StormMans/veldarmour/VA_BullBar_Data_Pack/pdf/VA-BB-01_bend_sheet.pdf

835.00

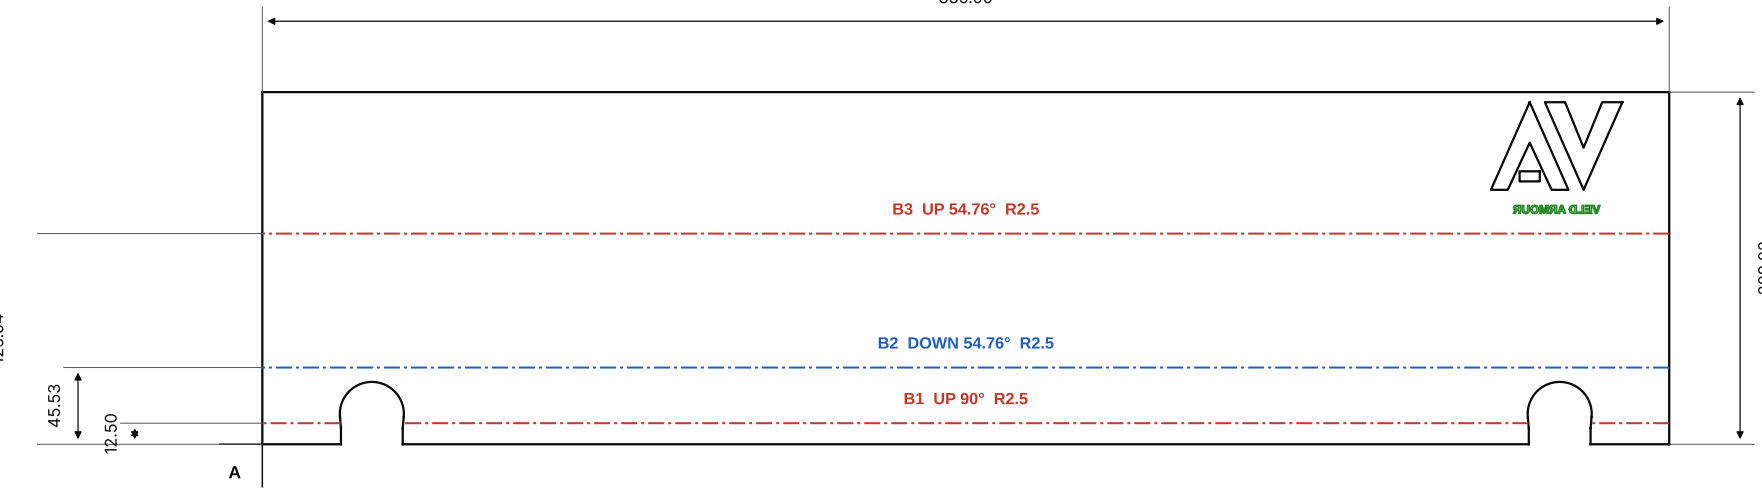
[picture p2: figure]
B2 DOWN 54.76° R2.5

209.02

125.04

## FLAT PATTERN - viewed from bend-note face (UP = toward viewer) scale 1:5

red dash-dot = BEND UP blue dash-dot = BEND DOWN green = ETCH/mark datum A = bottom-left corner of flat

# VELD ARMOUR

## BUILT FOR THE VELD

### CNC / PRESS-BRAKE DATA PACK

PART NO.

# VA-BB-01

TITLE

## Centre panel - FLAT PATTERN

MATERIAL

## 304 SS 2B

THICKNESS

## 3 mm

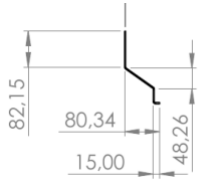
[picture p3: figure]
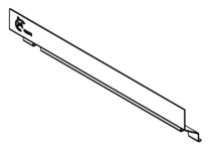
[picture p4: figure]

QTY / ASSY
1

FLAT SIZE
835.0 x 209.0

NET MASS
4.05 kg

K-FACTOR

## 0.46 (air bend, 304)

BENDS
3

SOURCE ITEM
#1

DXF

## VA-BB-01_Centre_panel_3mm.dxf

TOL. LINEAR
+/- 0.5 mm

TOL. ANGULAR

## +/- 1 deg

FINISH

## Deburr; brush; passivate

Veld Armour (Pty) Ltd - proprietary; not for distribution without written consent | A3 | SHEET 3 of 15 | SCALE 1:5 | REV A | 2026-10-19 | DO NOT SCALE DRAWING | ALL DIMENSIONS IN MM

## BEND TABLE

No | Dir | Angle | R in | From A | BA | BD | V-die
B1 | UP | 90° | 2.5 | 12.50 (Y) | 6.09 | 4.91 | 24
B2 | DOWN | 54.76° | 2.5 | 45.53 (Y) | 3.71 | 1.99 | 24
B3 | UP | 54.76° | 2.5 | 125.04 (Y) | 3.71 | 1.99 | 24

BA = bend allowance, BD = bend deduction (mm), K = 0.46, inside radius as listed. V-die = 8T opening (mm). "From A" = bend-line centre from datum edge. 304: ~1.5x mild-steel tonnage, 2-3 deg extra springback. WARNING: B1, B2, B3 inside R < 1T - cracking risk in 304; use R >= 3 tooling or prove on first-off.

## FORMED SECTION (neutral axis, to scale)

A

Flats from A: 12.5 / 33.0 / 79.5 / 84.0 mm

## FORMED VIEW (reference, not to scale)

NOTES: (1) Veld Armour monogram cut through; wordmark on ETCH layer (mirrored in flat, reads correct on outside face). (2) Half-round notches clear the upright lugs - check fit-up before final bend.
