StormMans/veldarmour/VA_BullBar_Data_Pack/pdf/VA-BB-02_bend_sheet.pdf

### FLAT PATTERN - viewed from bend-note face (UP = toward viewer) scale 1:5

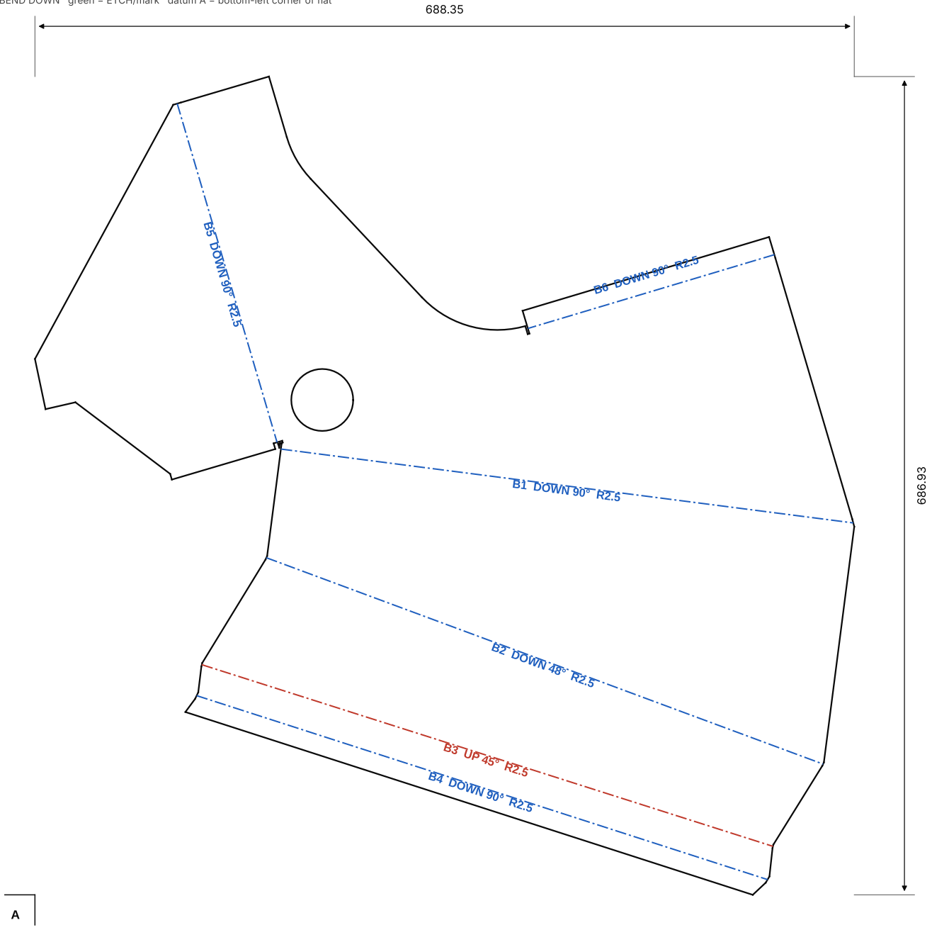
[picture p5: figure]
B1 DOWN 90° R2.5; B2 DOWN 48° R2.5; B4 DOWN 90° R2.5; B5 DOWN 90° R2.5; B6 DOWN 90° R2.5

red dash-dot = BEND UP blue dash-dot = BEND DOWN green = ETCH/mark datum A = bottom-left corner of flat

# VELD ARMOUR

BUILT FOR THE VELD

CNC / PRESS-BRAKE DATA PACK

PART NO.

# VA-BB-02

TITLE

### End panel (item 2) - FLAT PATTERN

MATERIAL

### 304 SS 2B

THICKNESS

### 3 mm

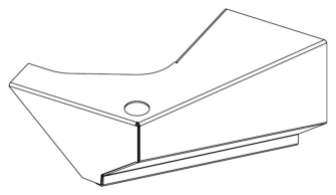
[picture p6: figure]

QTY / ASSY
1

FLAT SIZE
688.3 x 686.9

NET MASS
6.32 kg

K-FACTOR

### 0.46 (air bend, 304)

BENDS
6

SOURCE ITEM
#2

DXF

### VA-BB-02_End_panel_3mm.dxf

TOL. LINEAR
+/- 0.5 mm

TOL. ANGULAR

### +/- 1 deg

FINISH

### Deburr; brush; passivate

Veld Armour (Pty) Ltd - proprietary; not for distribution without written consent | A3 | SHEET 4 of 15 | SCALE 1:5 | REV A | 2026-10-19 | DO NOT SCALE DRAWING | ALL DIMENSIONS IN MM

### BEND TABLE

No | Dir | Angle | R in | From A | BA | BD | V-die
B1 | DOWN | 90° | 2.5 | see view | 6.09 | 4.91 | 24
B2 | DOWN | 48° | 2.5 | see view | 3.25 | 1.65 | 24
B3 | UP | 45° | 2.5 | see view | 3.05 | 1.51 | 24
B4 | DOWN | 90° | 2.5 | see view | 6.09 | 4.91 | 24
B5 | DOWN | 90° | 2.5 | see view | 6.09 | 4.91 | 24
B6 | DOWN | 90° | 2.5 | see view | 6.09 | 4.91 | 24

BA = bend allowance, BD = bend deduction (mm), K = 0.46, inside radius as listed. V-die = 8T opening (mm). "From A" = bend-line centre from datum edge. 304: ~1.5x mild-steel tonnage, 2-3 deg extra springback. WARNING: B1, B2, B3, B4, B5, B6 inside R < 1T - cracking risk in 304; use R >= 3 tooling or prove on first-off.

FORMED SECTION (neutral axis, to scale)

Non-parallel bends - see formed view and assembly sheet for orientation.

FORMED VIEW (reference, not to scale)

NOTES: (1) Non-parallel bends: form the short 90 deg corner flanges last, after the 48/45/90 return lip. (2) Suggested sequence: B2 (48 deg) > B3 (45 deg up) > B4 (90 deg lip) > B1 (long 90) > B5, B6 (corner flanges).
