StormMans/veldarmour/VA_BullBar_Data_Pack/pdf/VA-BB-TUBE_tube_schedule.pdf

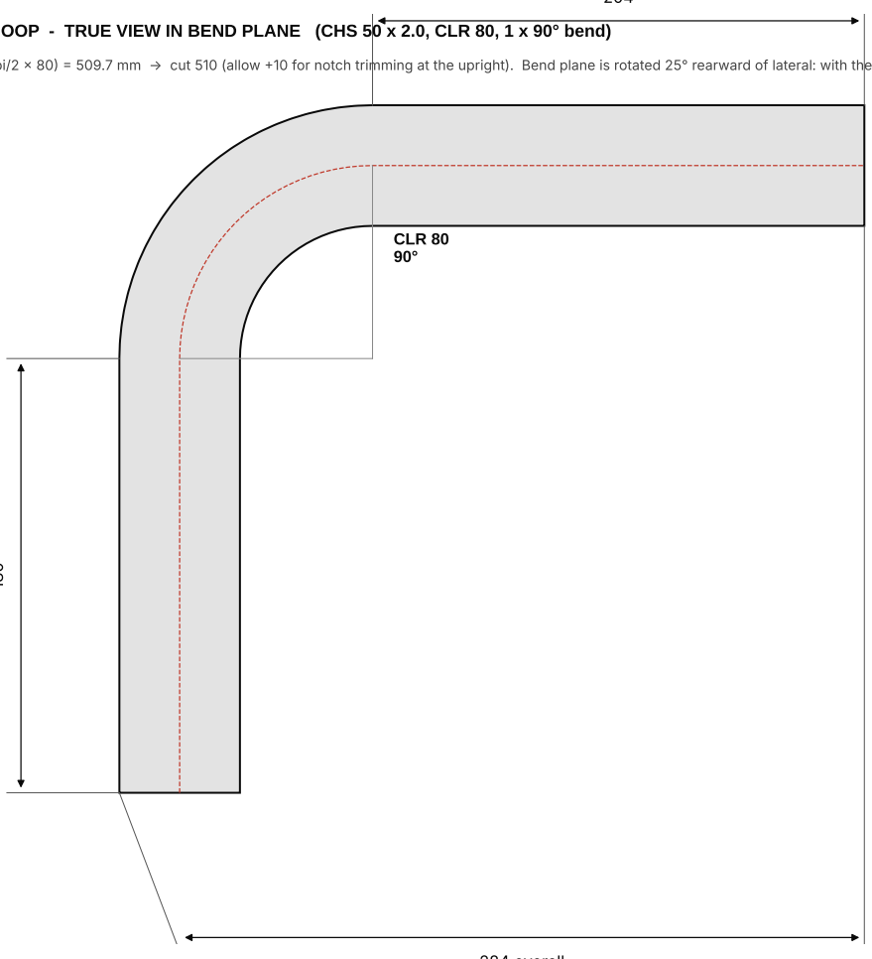
[picture p7: figure]
CLR 80 90°
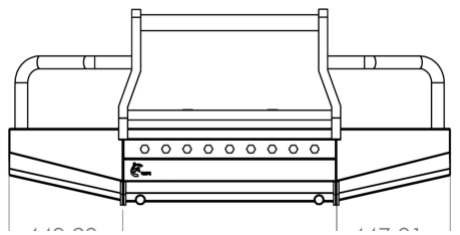
[picture p8: figure]

# VELD ARMOUR

## BUILT FOR THE VELD

### CNC / PRESS-BRAKE DATA PACK

PART NO.

# VA-BB-TUBE

TITLE

## TUBE SCHEDULE - CUT LENGTHS & BEND DATA

MATERIAL

## 304 SS CHS

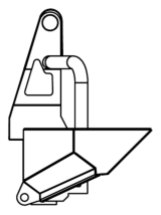
[picture p9: figure]

TUBE ITEMS
6

TUBE MASS

## 6.4 kg

HOOP CLR

## 80 mm (1.6 D)

BEND METHOD

## Mandrel / rotary draw

SOURCE SCALE

## 1:20, sheet 1

WALL

## 2.0 mm all tubes

FITMENT

## TBC

END CUTS

## square unless noted

TOL. LENGTH
+/- 1 mm

TOL. ANGLE

## +/- 1 deg

FINISH

## Brushed, passivated

Veld Armour (Pty) Ltd - proprietary; not for distribution without written consent | A3 | SHEET 2 of 15 | SCALE 1:5 | REV A | 2026-10-19 | DO NOT SCALE DRAWING | ALL DIMENSIONS IN MM ¹⁸⁰

204

## 284 overall

## 285 overall

## VA-BB-15 / 16 SIDE HOOP - TRUE VIEW IN BEND PLANE (CHS 50 x 2.0, CLR 80, 1 x 90° bend)

Cut length = 180 + 204 + (pi/2 x 80) = 509.7 mm -> cut 510 (allow +10 for notch trimming at the upright). Bend plane is rotated 25° rearward of lateral: with the vertical leg plumb, the inboard leg points toward the upright window. LH and RH are opposite hand. PLAN (looking down)

lateral (inboard)

rearward

vertical leg

25°

inboard leg direction
(front view: 362 lateral, side view: 85 rearward)

## TUBE SCHEDULE

## VA-BB-08 Pipe lift (jacking stub) x2

### CHS 38.1 x 2.0 cut length 100 mm 0.18 kg ea [approx.]

Seen end-on under the centre section in the front view (Ø38 outer / Ø32 inner at 705 mm centres); length from side view.

## VA-BB-09 Pipe centre (top hoop) x1

### CHS 63.5 x 2.0 cut length 702 mm 2.15 kg ea [measured]

Straight tube between the upright faces at the top (front view 5529.4 to 6231.4); Ø63 end-on in side view.

## VA-BB-10 Pipe spot (light bar) x1

### CHS 38.1 x 2.0 cut length 805 mm 1.45 kg ea [measured]

Straight tube between the upright feet (front view 5477.9 to 6282.9), 38.1 wide in front view.

## VA-BB-15 Tube 50 LH (side hoop) x1

### CHS 50 x 2.0 cut length 510 mm 1.22 kg ea [measured]

### bend 90°, CLR 80, legs 180 / 204 (tangent to end), bend plane 25° rearward

Vertical leg 180 from end-panel top to tangent; 90 deg bend, CLR 80 (105 outer / 55 inner); inboard leg 204 to end, running 25 deg rearward of lateral into the upright window.

## VA-BB-16 Tube 50 RH (side hoop) x1

### CHS 50 x 2.0 cut length 510 mm 1.22 kg ea [measured]

### bend 90°, CLR 80, legs 180 / 204 (tangent to end), bend plane 25° rearward

Mirror of VA-BB-15.

Measured from source assembly views at 1:20 (scale set from the 1741.09 dim). Wall 2.0 mm on all tubes per Veld Armour. Verify first-off on the jig.

SOURCE FRONT VIEW (measured) | SOURCE SIDE VIEW (measured)

## HOW THE LENGTHS WERE TAKEN

Vector geometry extracted from the assembly PDF; the 1741.09 overall width fixes the scale. Hoop: vertical-leg tangent and horizontal-leg tangent found from the tube silhouettes in both views; CLR = 80 from the tangent offsets (72 lateral, 33 rearward, 80 vertical). Inboard leg true length from its two projections (184 lateral / 85 rearward). Centre and spot tubes span between the upright faces/feet. Lift stubs: Ø38/Ø32 circles under the bar, length from the side view.
