StormMans/veldarmour/VA_BullBar_Data_Pack/pdf/VA-BB-03_bend_sheet.pdf

306.47

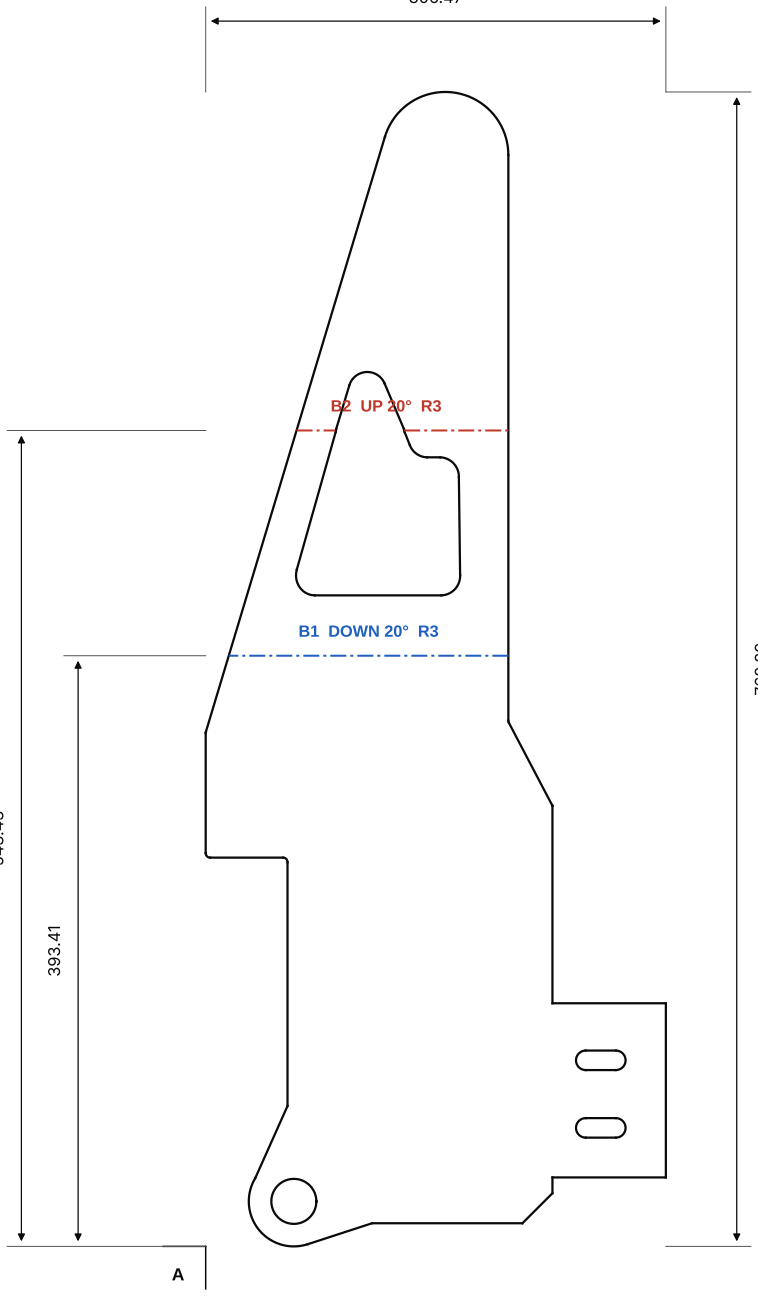
[picture p10: figure]
B1 DOWN 20° R3

768.89

543.43

## FLAT PATTERN - viewed from bend-note face (UP = toward viewer) scale 1:5

red dash-dot = BEND UP blue dash-dot = BEND DOWN green = ETCH/mark datum A = bottom-left corner of flat

# VELD ARMOUR

## BUILT FOR THE VELD

### CNC / PRESS-BRAKE DATA PACK

PART NO.

# VA-BB-03

TITLE

## Upright RH - FLAT PATTERN

MATERIAL

## 304 SS 2B

THICKNESS

## 5 mm

QTY / ASSY
1

FLAT SIZE
306.5 x 768.9

NET MASS
4.66 kg

K-FACTOR

## 0.46 (air bend, 304)

BENDS
2

SOURCE ITEM
#3

DXF

## VA-BB-03_Upright_RH_5mm.dxf

TOL. LINEAR
+/- 0.5 mm

TOL. ANGULAR

## +/- 1 deg

FINISH

## Deburr; brush; passivate

Veld Armour (Pty) Ltd - proprietary; not for distribution without written consent | A3 | SHEET 5 of 15 | SCALE 1:5 | REV A | 2026-10-19 | DO NOT SCALE DRAWING | ALL DIMENSIONS IN MM

## BEND TABLE

No | Dir | Angle | R in | From A | BA | BD | V-die
B1 | DOWN | 20° | 3 | 393.41 (Y) | 1.85 | 0.97 | 40
B2 | UP | 20° | 3 | 543.43 (Y) | 1.85 | 0.97 | 40

BA = bend allowance, BD = bend deduction (mm), K = 0.46, inside radius as listed. V-die = 8T opening (mm). "From A" = bend-line centre from datum edge. 304: ~1.5x mild-steel tonnage, 2-3 deg extra springback. WARNING: B1, B2 inside R < 1T - cracking risk in 304; use R >= 5 tooling or prove on first-off.

## FORMED SECTION (neutral axis, to scale)

A

Flats from A: 393.4 / 150.0 / 225.5 mm

## FORMED VIEW (reference, not to scale)

NOTES: (1) Two opposed 20 deg bends form a joggle - set back gauge from the slotted foot (datum edge A). (2) Lug (VA-BB-07) welds over the dia 30 hole; R30 boss on this part matches lug outer radius.
