StormMans/veldarmour/VA_BullBar_Data_Pack/pdf/VA-BB-07_bend_sheet.pdf

### FLAT PATTERN - viewed from bend-note face (UP = toward viewer) scale 1:1

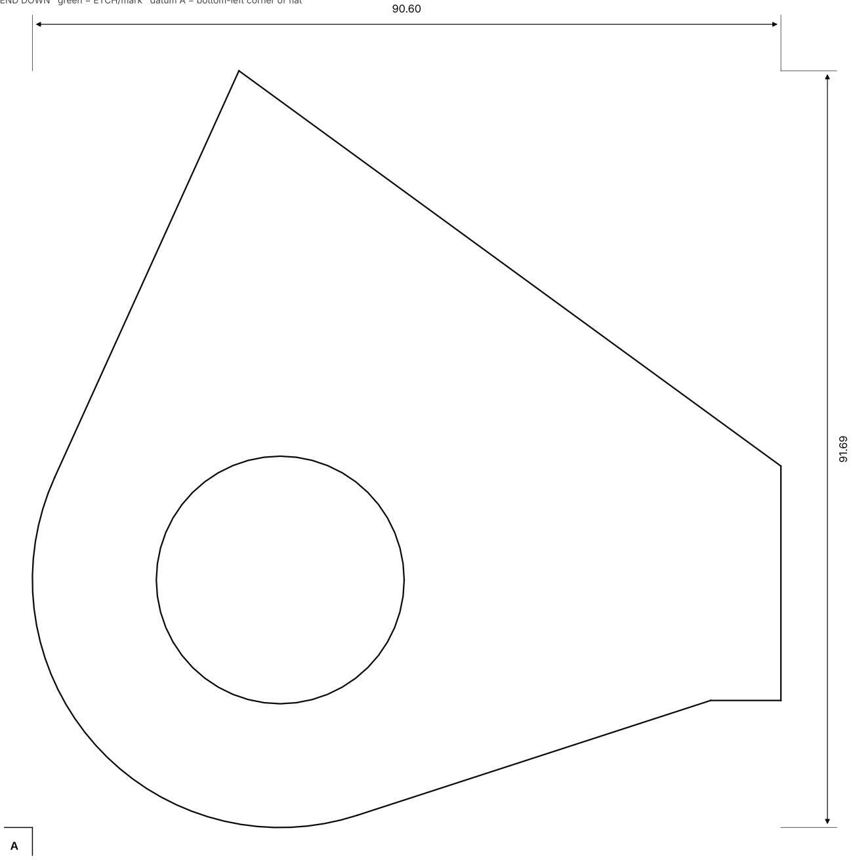
[picture p11: figure]

red dash-dot = BEND UP blue dash-dot = BEND DOWN green = ETCH/mark datum A = bottom-left corner of flat

# VELD ARMOUR

BUILT FOR THE VELD

CNC / PRESS-BRAKE DATA PACK

PART NO.

# VA-BB-07

TITLE

### Recovery lug - FLAT PATTERN

MATERIAL

### 304 SS 2B

THICKNESS

### 12 mm

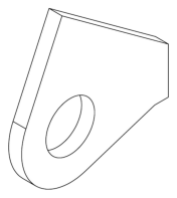
[picture p12: figure]

QTY / ASSY
4

FLAT SIZE
90.6 x 91.7

NET MASS
0.44 kg

K-FACTOR

### 0.46 (air bend, 304)

BENDS
0

SOURCE ITEM
#7

DXF

### VA-BB-07_Recovery_lug_12mm.dxf

TOL. LINEAR
+/- 0.5 mm

TOL. ANGULAR

### +/- 1 deg

FINISH

### Deburr; brush; passivate

Veld Armour (Pty) Ltd - proprietary; not for distribution without written consent | A3 | SHEET 9 of 15 | SCALE 1:1 | REV A | 2026-10-19 | DO NOT SCALE DRAWING | ALL DIMENSIONS IN MM

### BEND TABLE

No | Dir | Angle | R in | From A | BA | BD | V-die

No bends - flat laser-cut part.

BA = bend allowance, BD = bend deduction (mm), K = 0.46, inside radius as listed. V-die = 8T opening (mm). "From A" = bend-line centre from datum edge. 304: ~1.5x mild-steel tonnage, 2-3 deg extra springback.

FORMED SECTION (neutral axis, to scale)

Flat part - no section.

FORMED VIEW (reference, not to scale)

NOTES: (1) Redrawn from assembly drawing sheet 8 (no flat supplied in source). Dia 30 hole, R30 boss. Upgraded from 8 mm to 12 mm (Rev A). (2) Laser cut 12 mm with nitrogen; dress the hole for a 30 mm pin / shackle bow. Weld through to the chassis bracket, not only to the 3 mm end panel.
