StormMans/veldarmour/VA_BullBar_Data_Pack/pdf/VA-BB-17_bend_sheet.pdf

### FLAT PATTERN - viewed from bend-note face (UP = toward viewer) scale 1:5

red dash-dot = BEND UP blue dash-dot = BEND DOWN green = ETCH/mark datum A = bottom-left corner of flat

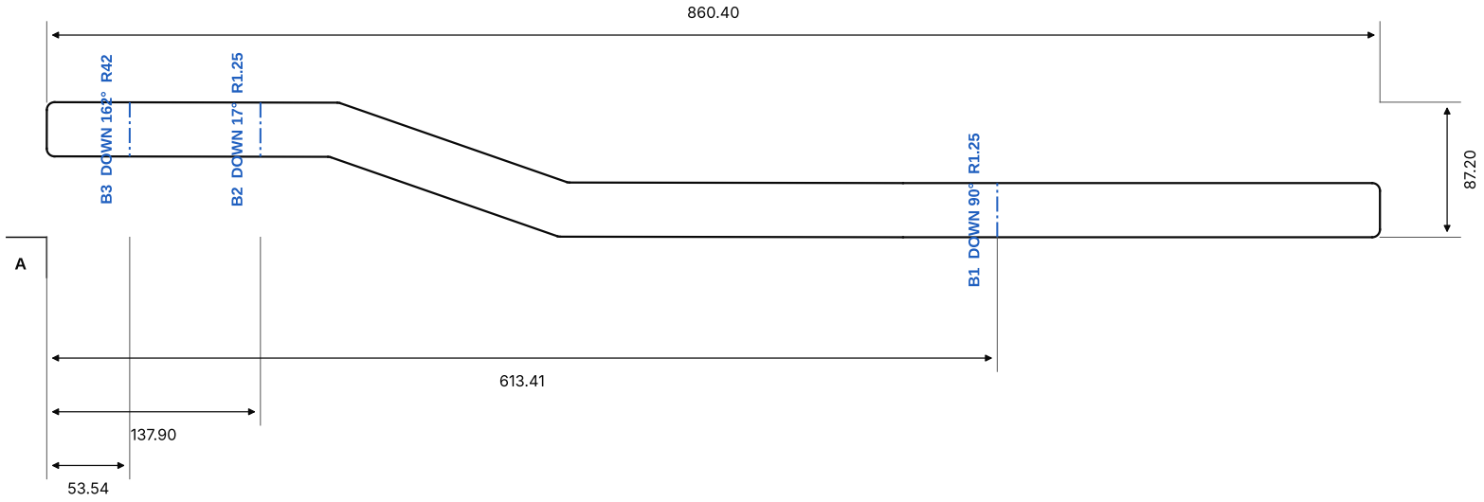
[picture p13: figure]
B1 DOWN 90° R1.25; B3 DOWN 162° R42; B2 DOWN 17° R1.25

# VELD ARMOUR

BUILT FOR THE VELD

CNC / PRESS-BRAKE DATA PACK

PART NO.

# VA-BB-17

TITLE

### Face 1 (RH trim strip) - FLAT PATTERN

MATERIAL

### 304 SS 2B

THICKNESS

### 2 mm

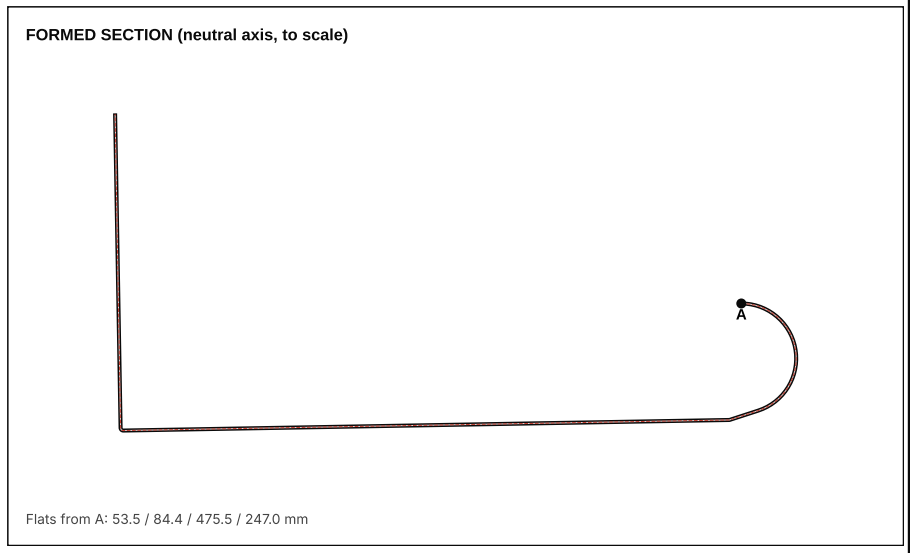
[picture p14: figure]
FORMED SECTION (neutral axis, to scale)

QTY / ASSY
1

FLAT SIZE
860.4 x 87.2

NET MASS
0.48 kg

K-FACTOR

### 0.46 (air bend, 304)

BENDS
3

SOURCE ITEM
#17

DXF

### VA-BB-17_Face_1_2mm.dxf

TOL. LINEAR
+/- 0.5 mm

TOL. ANGULAR

### +/- 1 deg

FINISH

### Deburr; brush; passivate

Veld Armour (Pty) Ltd - proprietary; not for distribution without written consent | A3 | SHEET 14 of 15 | SCALE 1:5 | REV A | 2026-10-19 | DO NOT SCALE DRAWING | ALL DIMENSIONS IN MM

### BEND TABLE

No | Dir | Angle | R in | From A | BA | BD | V-die
B1 | DOWN | 90° | 1.25 | 613.41 (X) | 3.41 | 3.09 | 16
B2 | DOWN | 17° | 1.25 | 137.90 (X) | 0.64 | 0.33 | 16
B3 | DOWN | 162° | 42 | 53.54 (X) | 121.35 | 434.26 | roll

BA = bend allowance, BD = bend deduction (mm), K = 0.46, inside radius as listed. V-die = 8T opening (mm). "From A" = bend-line centre from datum edge. 304: ~1.5x mild-steel tonnage, 2-3 deg extra springback. WARNING: B1, B2 inside R < 1T - cracking risk in 304; use R >= 2 tooling or prove on first-off.

Flats from A: 53.5 / 84.4 / 475.5 / 247.0 mm

FORMED VIEW (reference, not to scale)

NOTES: (1) Bends confirmed by Veld Armour (source sheet 9 note "NO BENDING" is superseded). (2) B3 (162 deg, R42) wraps the R42 top radius of the upright - roll/bump-form it, then fit the strip over the upright edge; B1/B2 on the brake.
