StormMans/veldarmour/kanopi_raw/Hilux GD6 Double Cab Data Pack (Side door with no windows)/40170.pdf

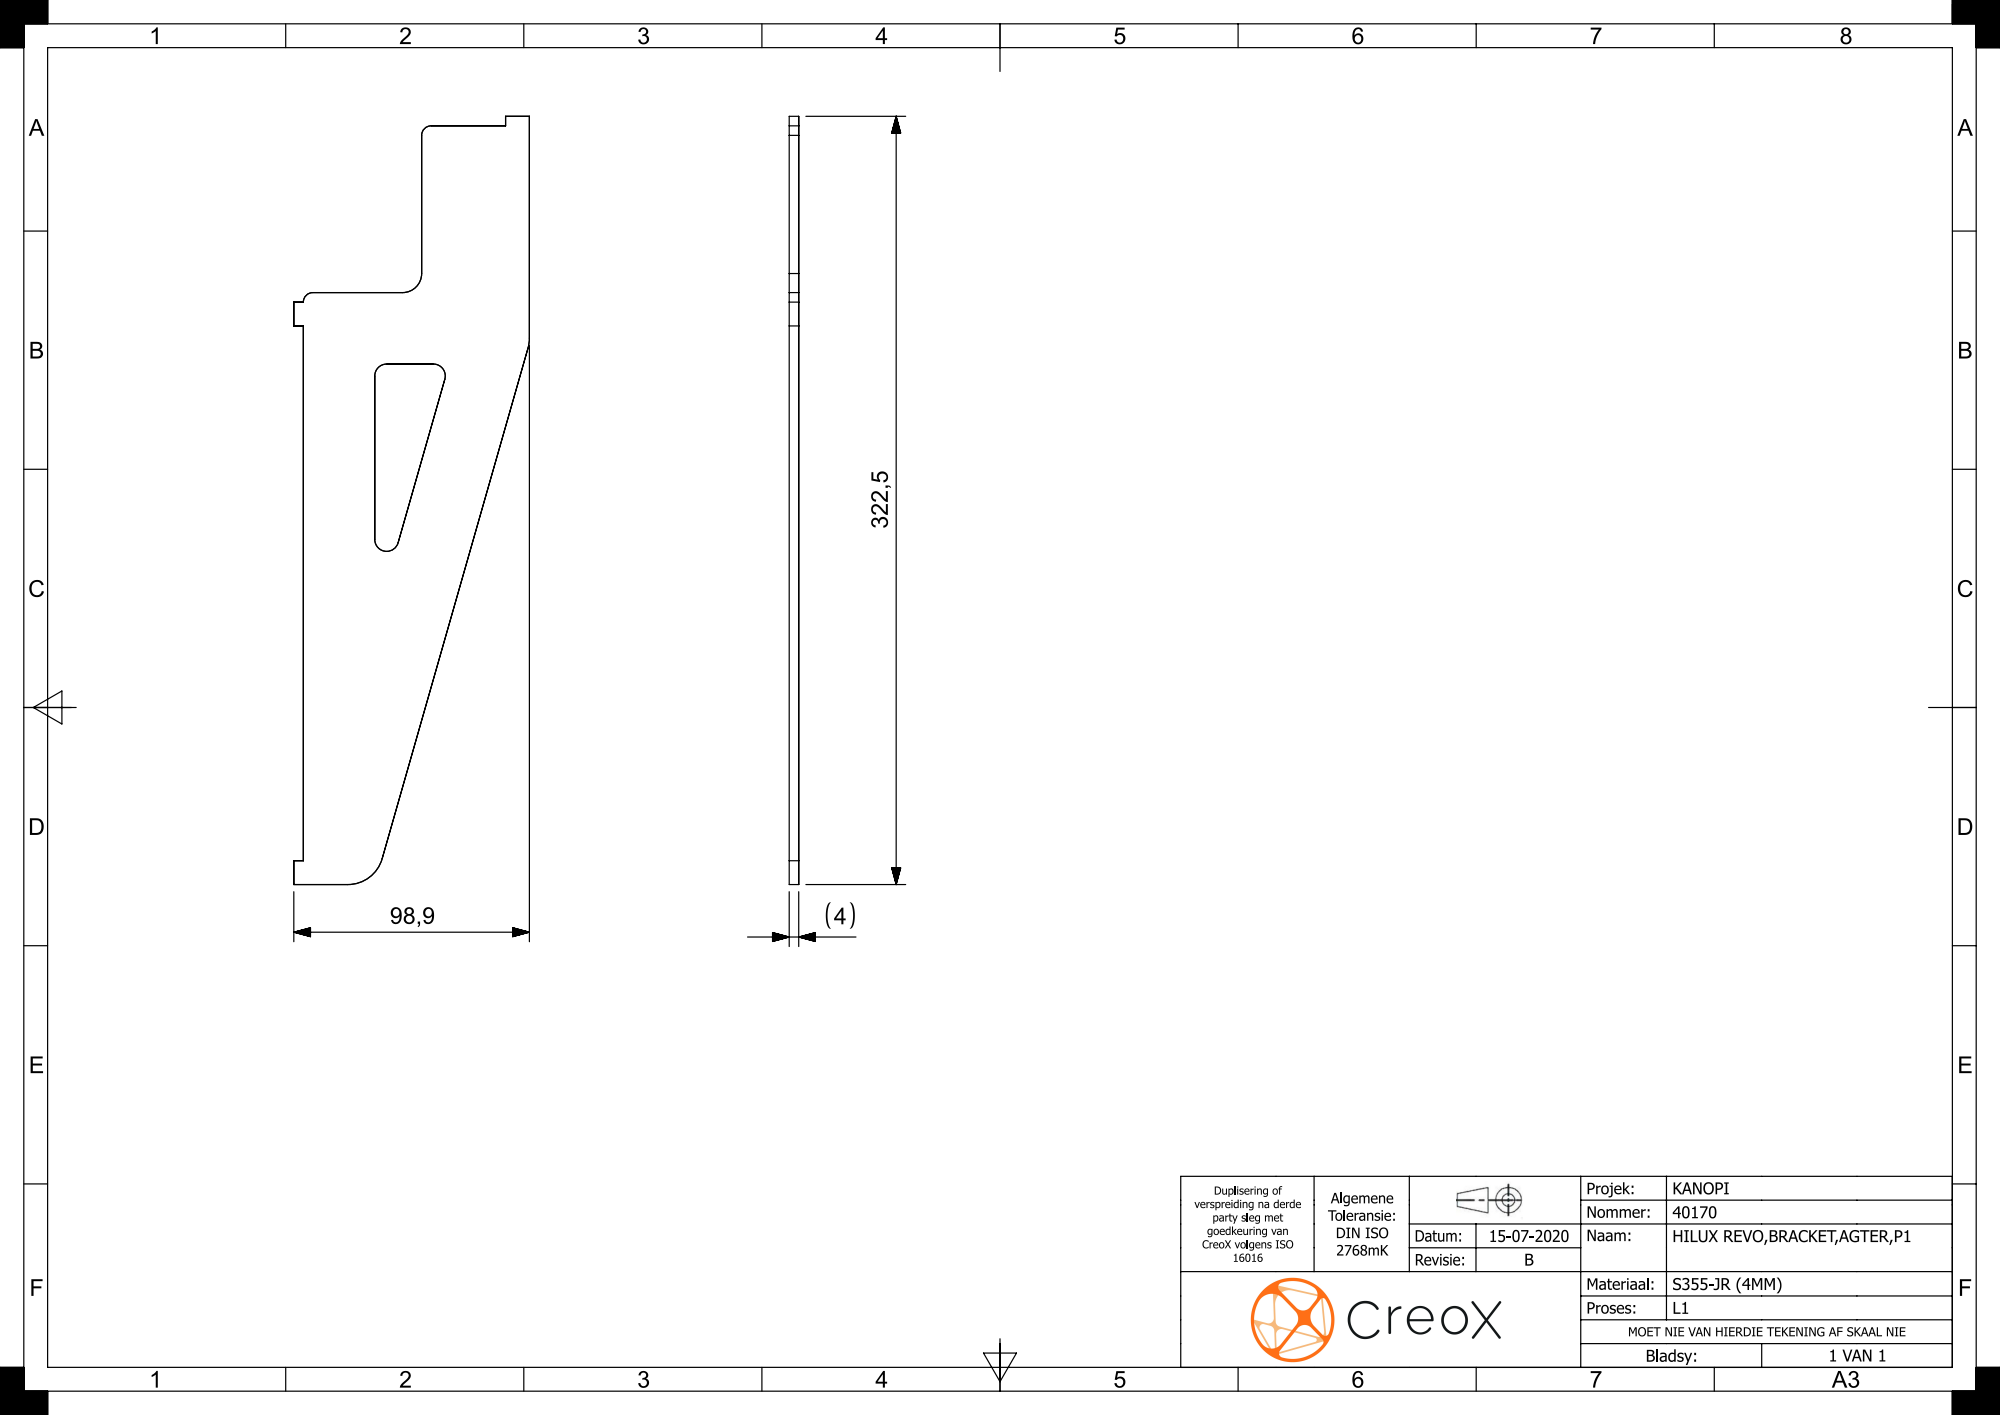
[picture p15: page 1]
