StormMans/veldarmour/Business card - Deniro.png

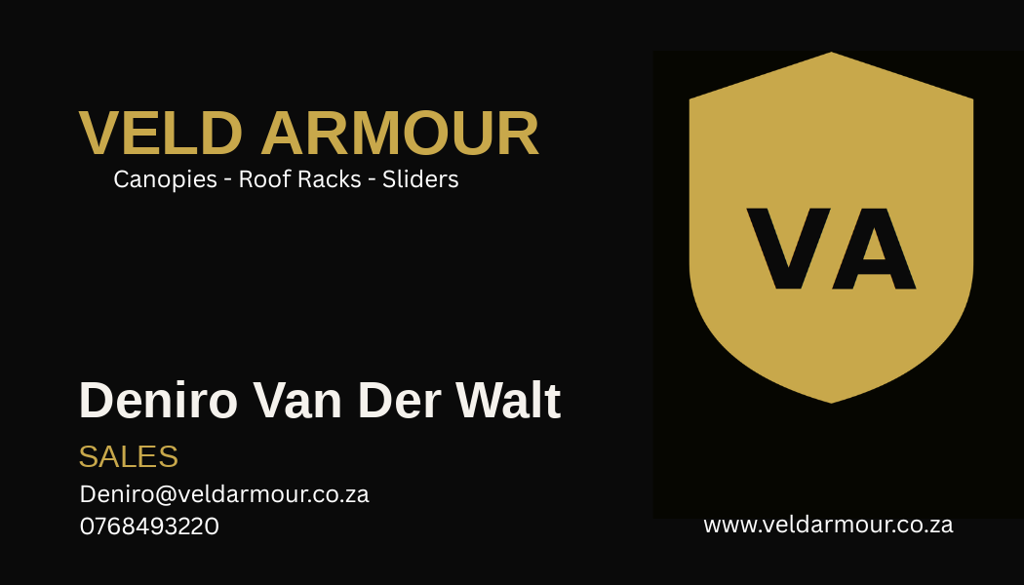
Business card - Deniro.png
