StormMans/veldarmour/Business Card - Evander.png

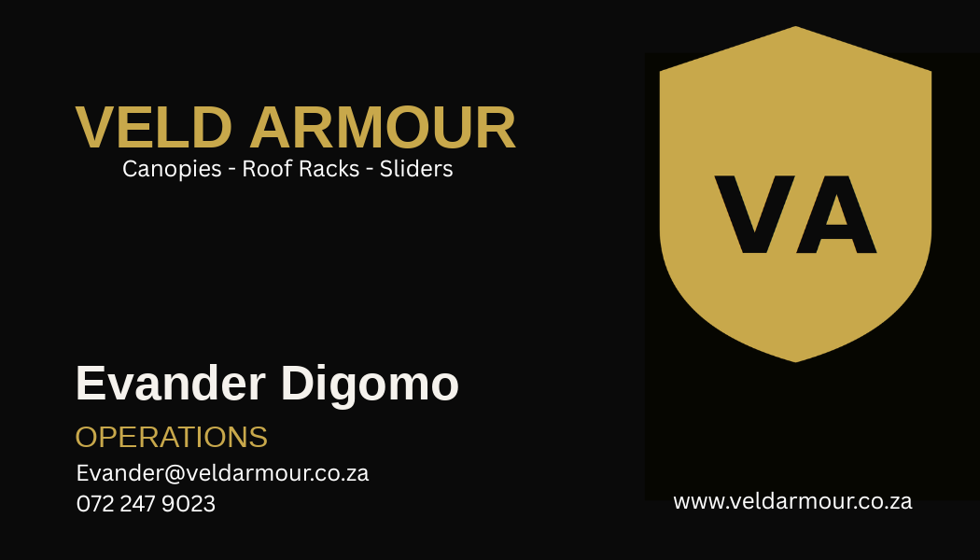
Business Card - Evander.png
