StormMans/veldarmour/VA_BullBar_Data_Pack/simulation/VA-BB-01_folded.png

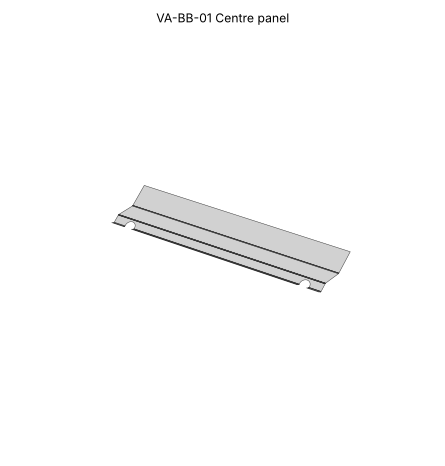
VA_BullBar_Data_Pack/simulation/VA-BB-01_folded.png
