StormMans/veldarmour/va_shield_black (2).png

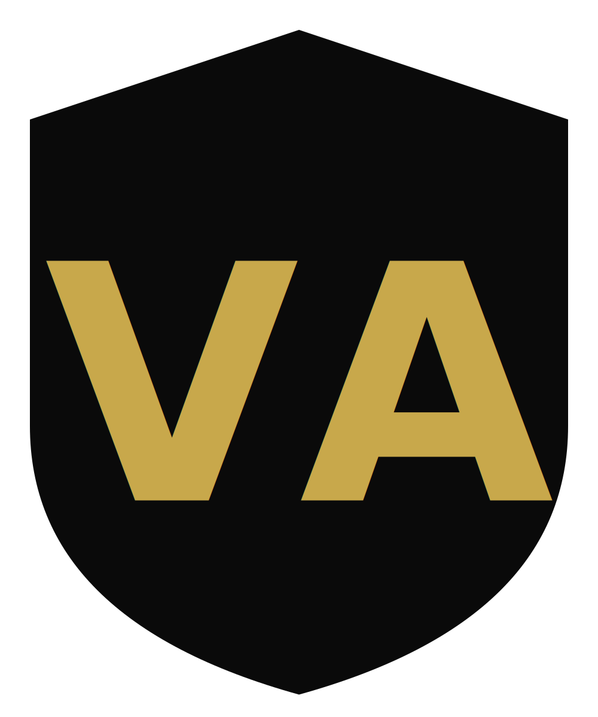
va_shield_black (2).png
