StormMans/veldarmour/va_shield_gold (2).png

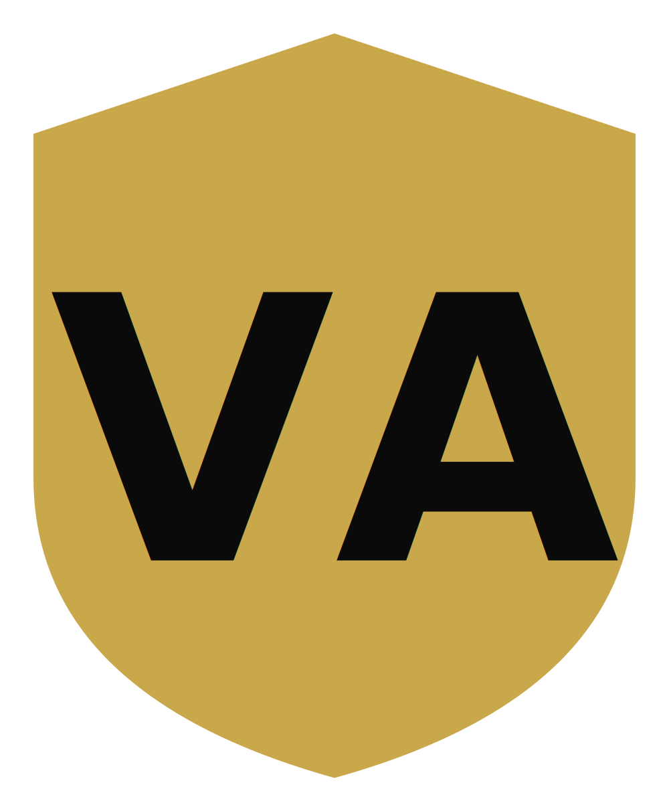
va_shield_gold (2).png
