StormMans/veldarmour/VA_Hilux_GD6_DC_Data_Pack/BOM Hilux GD6 DC - Veld Armour.xlsx

Veld Armour Parts Cut List (Hilux GD6 DC)
Part Number | Description | Thickness | QTY | Rev
40059 | Naamplaat,Veld Armour,1 | 1,5mm (304 Brushed Stainless Steel) | 1 | 1
40069 | Bracket Gaslift 1 | 3mm (3CR12) | 4 | 1
40070 | Bracket Gaslift 2 | 3mm (3CR12) | 2 | 1
40071 | Bracket Gaslift 3 | 3mm (3CR12) | 4 | 1
40072 | Bracket Gaslift 4 | 3mm (3CR12) | 1 | 1
40078 | Plaat Veld Armour Dak Profiel | 1,5mm (3CR12) | 6 | 1
40092 | Bracket Gaslift 5 | 3mm (3CR12) | 1 | 1
40095 | Plaat Hilux Revo DC Bo Voor | 1,5mm (3CR12) | 1 | 1
40096 | Plaat Hilux Revo DC Voor Regs | 1,5mm (3CR12) | 1 | 1
40097 | Plaat Hilux Revo DC Voor Onder | 1,5mm (3CR12) | 1 | 1
40099 | Plaat Hilux Revo DC Regs Bo | 1,5mm (3CR12) | 1 | 1
40100 | Plaat Hilux Revo DC Agter | 1,5mm (3CR12) | 1 | 1
40101 | Plaat Hilux Revo Regs Onder | 1,5mm (3CR12) | 1 | 1
40102 | Plaat Hilux Revo DC Deur RK Standaard | 1,5mm (3CR12) | 1 | 1
40103 | Plaat Hilux Revo DC Bo Agter | 1,5mm (3CR12) | 1 | 1
40104 | Plaat Hilux Revo DC Agterklap | 1,5mm (3CR12) | 1 | 1
40105 | Roof | 1,5mm (3CR12) | 1 | 1
40106 | Plaat Hilux Revo DC Bo Links | 1,5mm (3CR12) | 1 | 1
40107 | Plaat Hilux Revo DC Links Agter | 1,5mm (3CR12) | 1 | 1
40108 | Plaat Hilux Revo DC Voor Links | 1,5mm (3CR12) | 1 | 1
40109 | Plaat Hilux Revo DC Deur LK Standaard | 1,5mm (3CR12) | 1 | 1
40110 | Plaat Hilux Revo DC Onder Links | 1,5mm (3CR12) | 1 | 1
40112 | Naamplaat,Veld Armour,2 | 1,5mm (304 Brushed Stainless Steel) | 1 | 1
40160 | Plaat Hilux Revo DC Voorruit Skuif | 1,5mm (3CR12) | 1 | 1
40165 | Plaat Hilux Revo Bracket Voor P3 LK | 4mm S355-JR (4MM) | 1 | 1
40166 | Plaat Hilux Revo Bracket Voor P1 | 4mm S355-JR (4MM) | 2 | 1
40167 | Plaat Hilux Revo Bracket Voor P2 | 4mm S355-JR (4MM) | 2 | 1
40168 | Plaat Hilux Revo Bracket Voor P4 RK | 4mm S355-JR (4MM) | 1 | 1
40169 | Plaat Hilux Revo Bracket Agter P2 LK | 4mm S355-JR (4MM) | 1 | 1
40170 | Plaat Hilux Revo Bracket Agter P1 | 4mm S355-JR (4MM) | 2 | 1
40171 | Plaat Hilux Revo Bracket Agter P3 RK | 4mm S355-JR (4MM) | 1 | 1
40172 | Plaat Hilux Revo DC Agter | 1,5mm (3CR12) | 2 | 1
40173 | Plaat Hilux Revo DC Voor | 1,5mm (3CR12) | 2 | 1
40174 | Crush Tube, Hilux Revo DC | 1,5mm (3CR12) | 2 | 1
GD6DC-1023 | Corner 1 | 1,5mm (3CR12) | 2 | 1
GD6DC-1024 | Corner 2 | 1,5mm (3CR12) | 2 | 1
Veld Armour Parts List (Roofrack)
Part Number | Description | Thickness | QTY | Rev
RRD-1001 | Roof Rack Body PS | 1,5mm (3CR12) | 1 | 2
RRD-1002 | Roof Rack Body DS | 1,5mm (3CR12) | 1 | 2
RRD-1003 | Rood Rack Cross | 1,5mm (3CR12) | 5 | 2
RRD-1004 | Base Plate | 1,5mm (3CR12) | 4 | 2
Logo 2 | Logo | 1,5mm (304 Brushed Stainless Steel) | 1 | 1
