StormMans/veldarmour/kanopi_raw/Hilux GD6 Double Cab Data Pack (Side door with no windows)/2023/TOD6-12 v1.2R.DXF

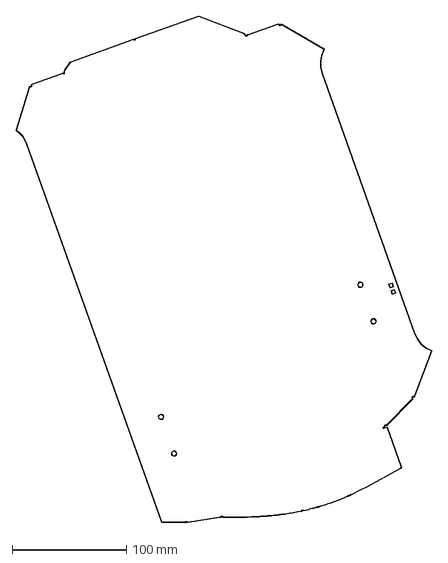
[picture p22: CAD file, 2026-06-11]
kanopi_raw/Hilux GD6 Double Cab Data Pack (Side door with no windows)/2023/TOD6-12 v1.2R.DXF
363.3 x 442.7 mm
