StormMans/veldarmour/VA_BullBar_Data_Pack/dxf/VA-BB-03_Upright_RH_5mm.dxf

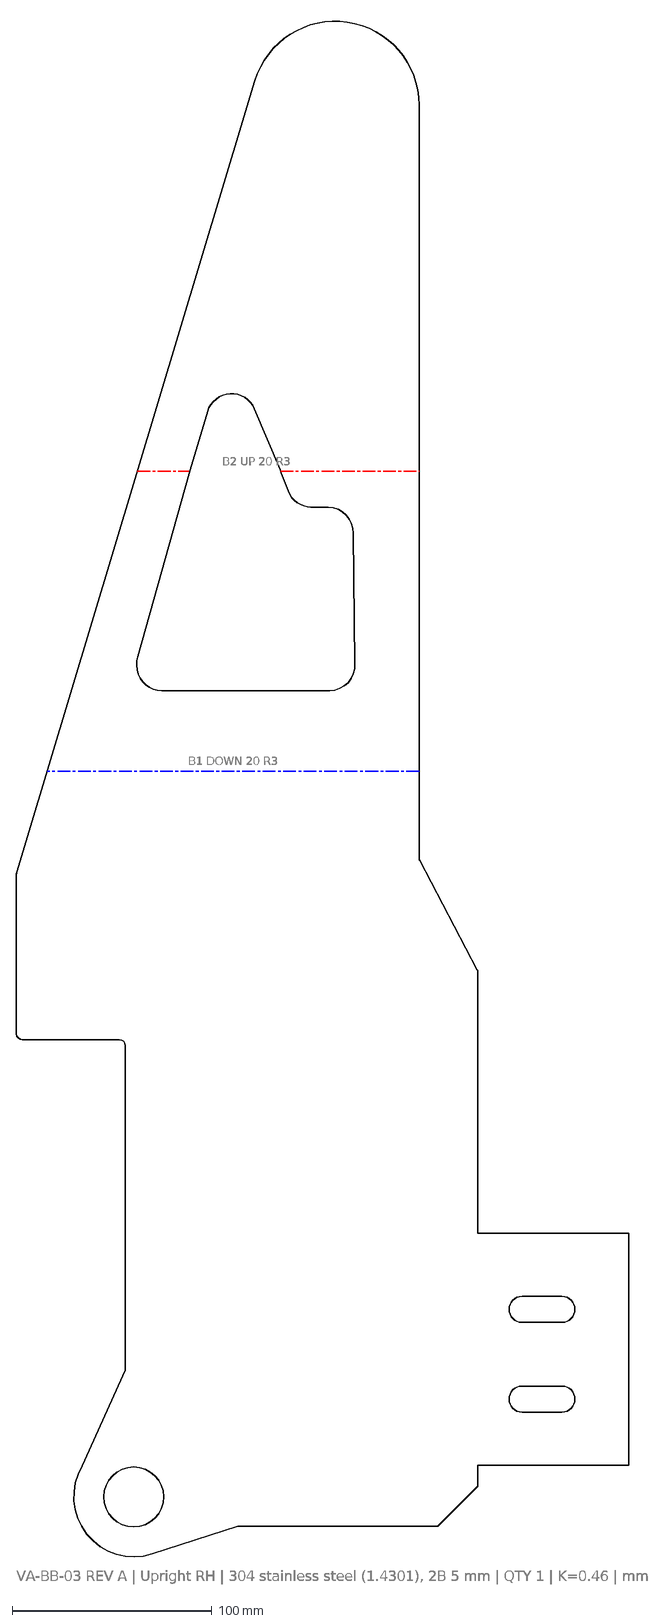
[picture p23: CAD file, 2026-10-19]
VA_BullBar_Data_Pack/dxf/VA-BB-03_Upright_RH_5mm.dxf
B1 DOWN 20 R3
B2 UP 20 R3
VA-BB-03 REV A | Upright RH | 304 stainless steel (1.4301), 2B 5 mm | QTY 1 | K=0.46 | mm
