StormMans/veldarmour/VA_BullBar_Data_Pack/source/d79e6554-Flat_pattern_-_Upriht.DXF

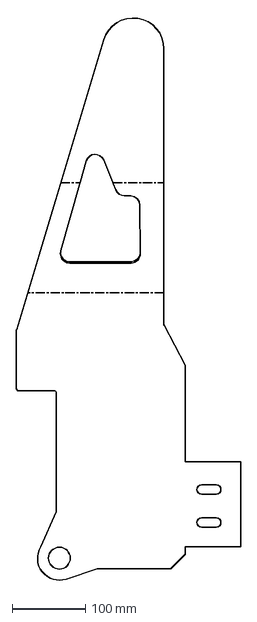
[picture p24: CAD file, 2026-10-19]
VA_BullBar_Data_Pack/source/d79e6554-Flat_pattern_-_Upriht.DXF
306.5 x 773.9 mm
