StormMans/veldarmour/VA_Logo_D2_Nameplate.dxf

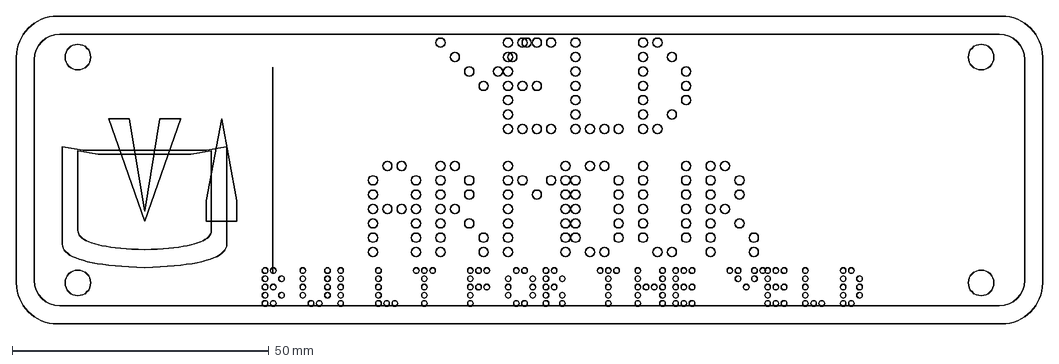
[picture p25: CAD file, 2026-06-11]
VA_Logo_D2_Nameplate.dxf
200.0 x 60.0 mm
