StormMans/veldarmour/kanopi_raw/Hilux GD6 Double Cab Data Pack (Side door with no windows)/2023/TOD6-06 v1.2.DXF

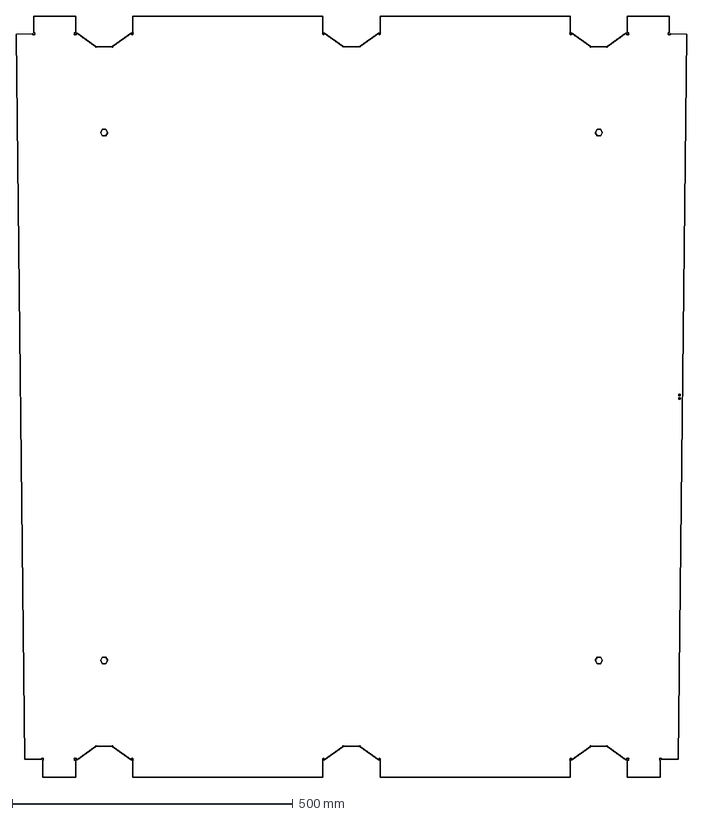
[picture p26: CAD file, 2026-06-11]
kanopi_raw/Hilux GD6 Double Cab Data Pack (Side door with no windows)/2023/TOD6-06 v1.2.DXF
1194.3 x 1354.8 mm
