StormMans/veldarmour/kanopi_raw/Hilux GD6 Double Cab Data Pack (Side door with no windows)/Flat pattern - RRD-1001-Rev-02.dxf

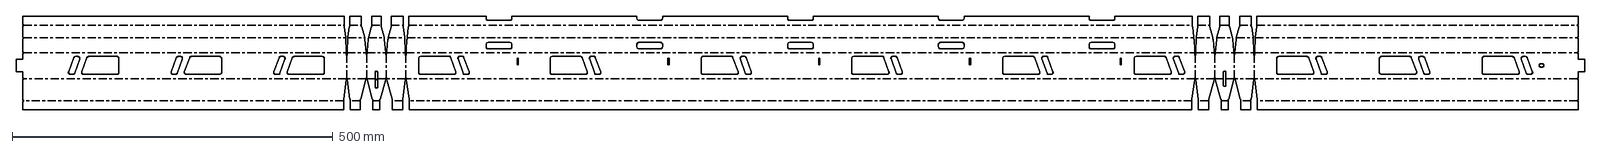
[picture p27: CAD file, 2026-06-11]
kanopi_raw/Hilux GD6 Double Cab Data Pack (Side door with no windows)/Flat pattern - RRD-1001-Rev-02.dxf
2443.7 x 145.4 mm
