StormMans/veldarmour/VA_Logo_D1_Shield.dxf

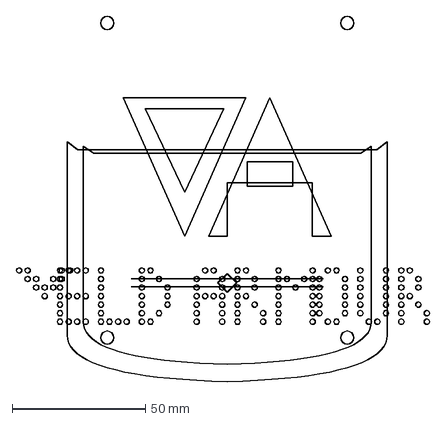
[picture p28: CAD file, 2026-06-11]
VA_Logo_D1_Shield.dxf
155.0 x 137.0 mm
