StormMans/veldarmour/kanopi_raw/Hilux GD6 Double Cab Data Pack (Side door with no windows)/2023/TOD6-04 v1.2N.DXF

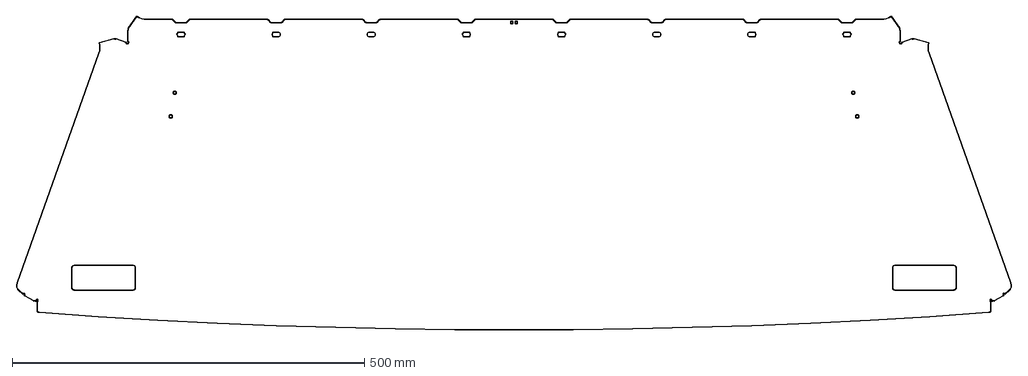
[picture p29: CAD file, 2026-06-11]
kanopi_raw/Hilux GD6 Double Cab Data Pack (Side door with no windows)/2023/TOD6-04 v1.2N.DXF
1413.2 x 453.2 mm
