StormMans/veldarmour/VA_BullBar_Data_Pack/source/7f169f1e-Flat_pattern_-_end_3.DXF

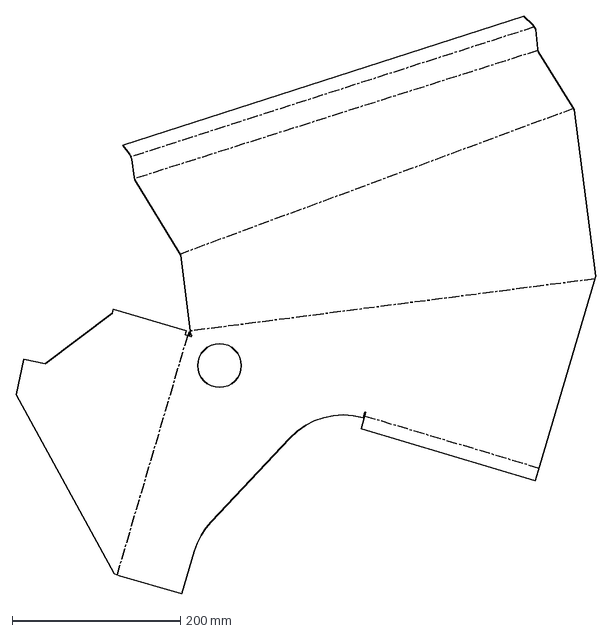
[picture p32: CAD file, 2026-10-19]
VA_BullBar_Data_Pack/source/7f169f1e-Flat_pattern_-_end_3.DXF
688.3 x 686.9 mm
