StormMans/veldarmour/VA_Logo_D3_CircleBadge.dxf

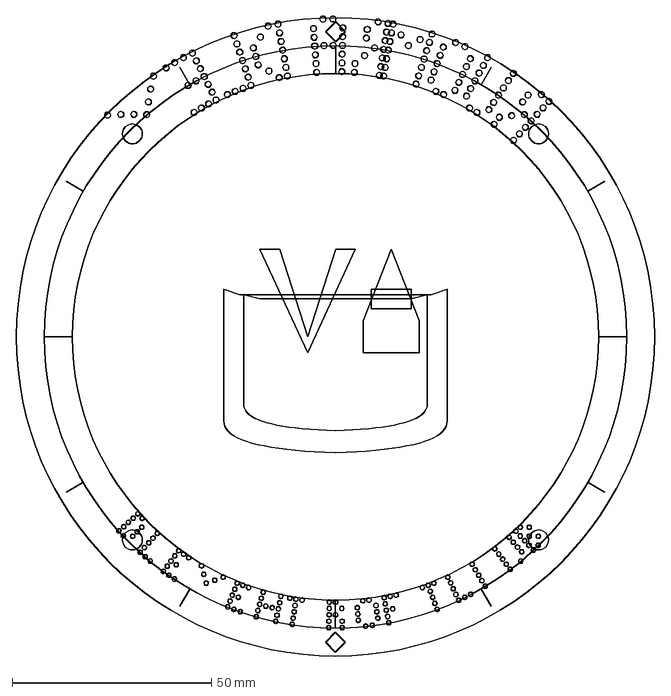
[picture p33: CAD file, 2026-06-11]
VA_Logo_D3_CircleBadge.dxf
160.0 x 160.4 mm
