StormMans/veldarmour/kanopi_raw/Hilux GD6 Double Cab Data Pack (Side door with no windows)/2023/URI-01 v1.0.DXF

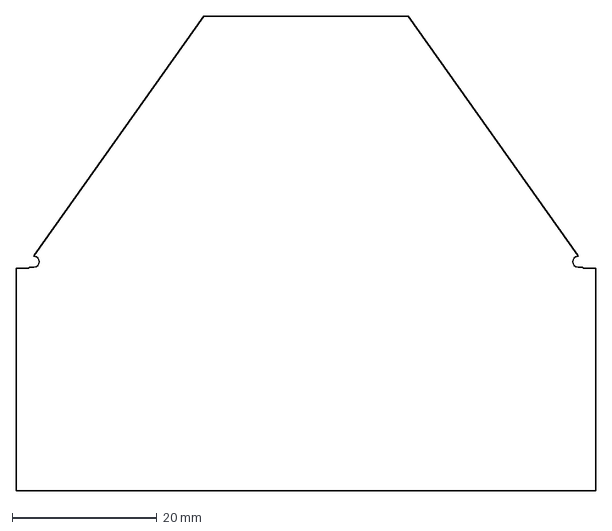
[picture p34: CAD file, 2026-06-11]
kanopi_raw/Hilux GD6 Double Cab Data Pack (Side door with no windows)/2023/URI-01 v1.0.DXF
80.0 x 65.6 mm
