StormMans/veldarmour/VA_BullBar_Data_Pack/dxf/VA-BB-12_Centre_panel_P2_3mm.dxf

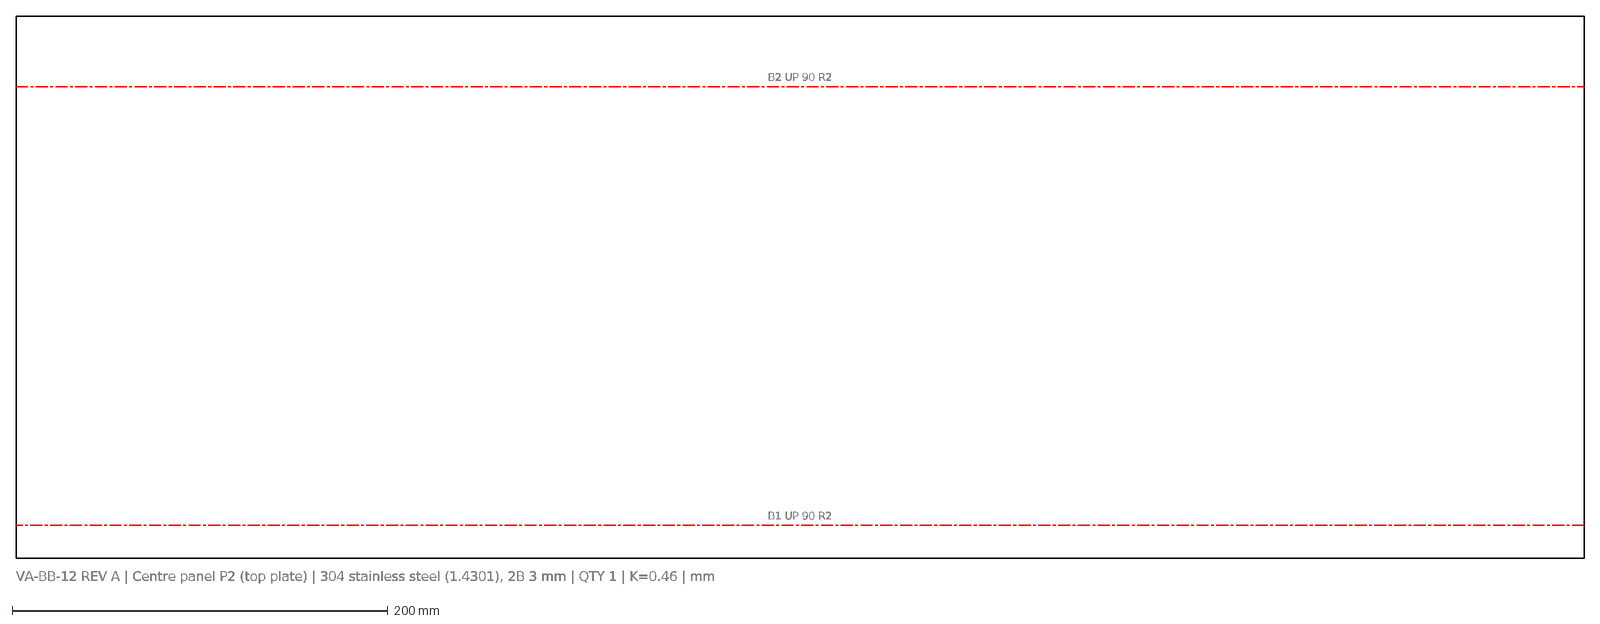
[picture p35: CAD file, 2026-10-19]
VA_BullBar_Data_Pack/dxf/VA-BB-12_Centre_panel_P2_3mm.dxf
B1 UP 90 R2
B2 UP 90 R2
VA-BB-12 REV A | Centre panel P2 (top plate) | 304 stainless steel (1.4301), 2B 3 mm | QTY 1 | K=0.46 | mm
