StormMans/veldarmour/VA_BullBar_Data_Pack/source/e31a439c-Flat_pattern_-_face_1.DXF

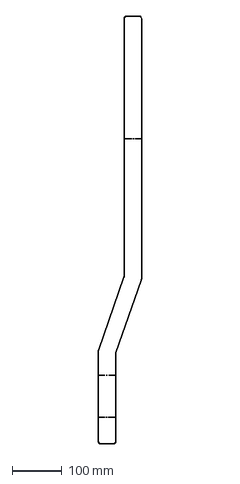
[picture p36: CAD file, 2026-10-19]
VA_BullBar_Data_Pack/source/e31a439c-Flat_pattern_-_face_1.DXF
87.2 x 860.4 mm
