StormMans/veldarmour/kanopi_raw/Hilux GD6 Double Cab Data Pack (Side door with no windows)/2023/TOD6-05 v1.2RW.DXF

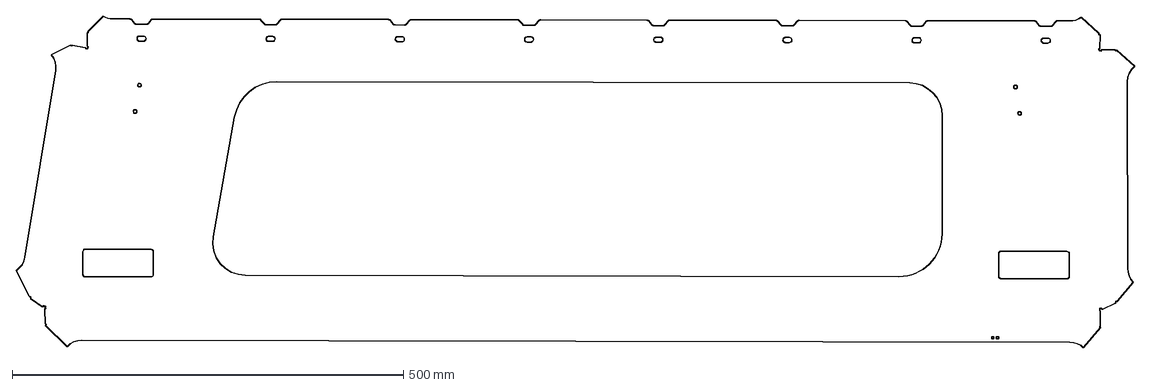
[picture p37: CAD file, 2026-06-11]
kanopi_raw/Hilux GD6 Double Cab Data Pack (Side door with no windows)/2023/TOD6-05 v1.2RW.DXF
1429.0 x 423.2 mm
