StormMans/veldarmour/VA_BullBar_Data_Pack/dxf/VA-BB-13_Centre_panel_P3_3mm.dxf

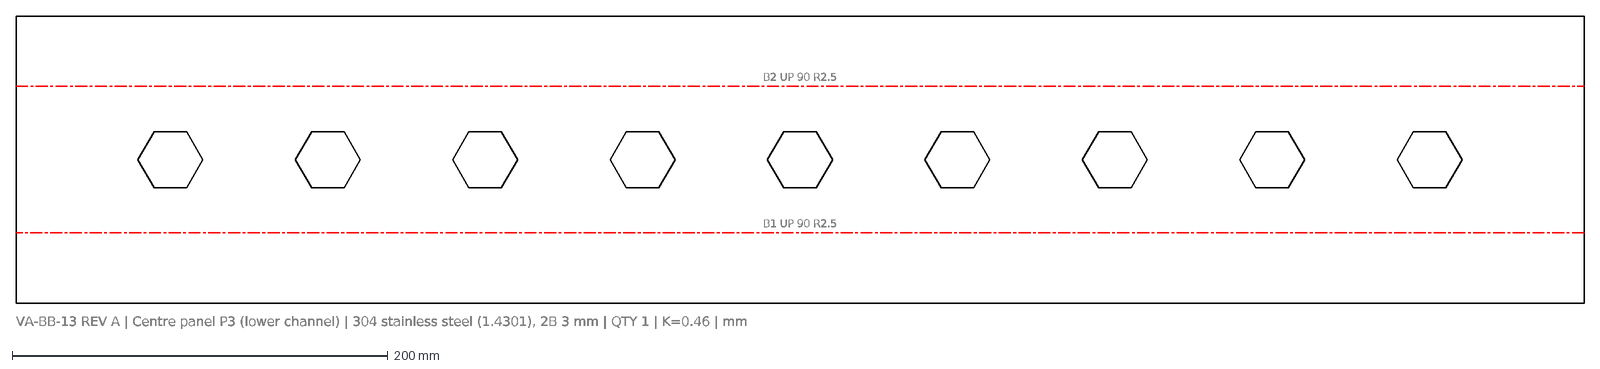
[picture p38: CAD file, 2026-10-19]
VA_BullBar_Data_Pack/dxf/VA-BB-13_Centre_panel_P3_3mm.dxf
B1 UP 90 R2.5
B2 UP 90 R2.5
VA-BB-13 REV A | Centre panel P3 (lower channel) | 304 stainless steel (1.4301), 2B 3 mm | QTY 1 | K=0.46 | mm
