StormMans/veldarmour/VA_BullBar_Data_Pack/source/e3a78948-Flat_pattern_-_SPOT_BRKT.DXF

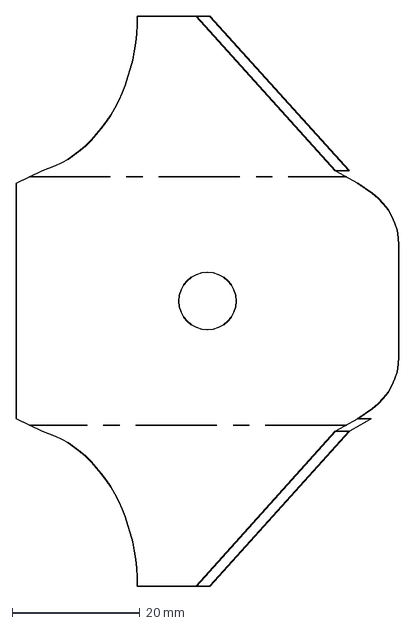
[picture p39: CAD file, 2026-10-19]
VA_BullBar_Data_Pack/source/e3a78948-Flat_pattern_-_SPOT_BRKT.DXF
60.0 x 89.3 mm
