StormMans/veldarmour/kanopi_raw/Hilux GD6 Double Cab Data Pack (Side door with no windows)/2023/TOD6-08 v1.2.DXF

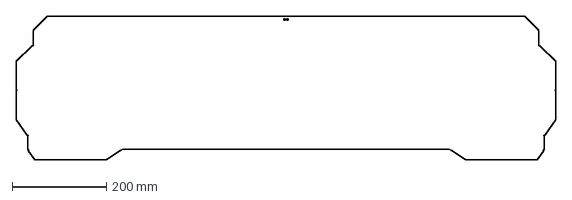
[picture p40: CAD file, 2026-06-11]
kanopi_raw/Hilux GD6 Double Cab Data Pack (Side door with no windows)/2023/TOD6-08 v1.2.DXF
1147.2 x 304.6 mm
