StormMans/veldarmour/VA_BullBar_Data_Pack/dxf/VA-BB-06_Bracket_1_5mm.dxf

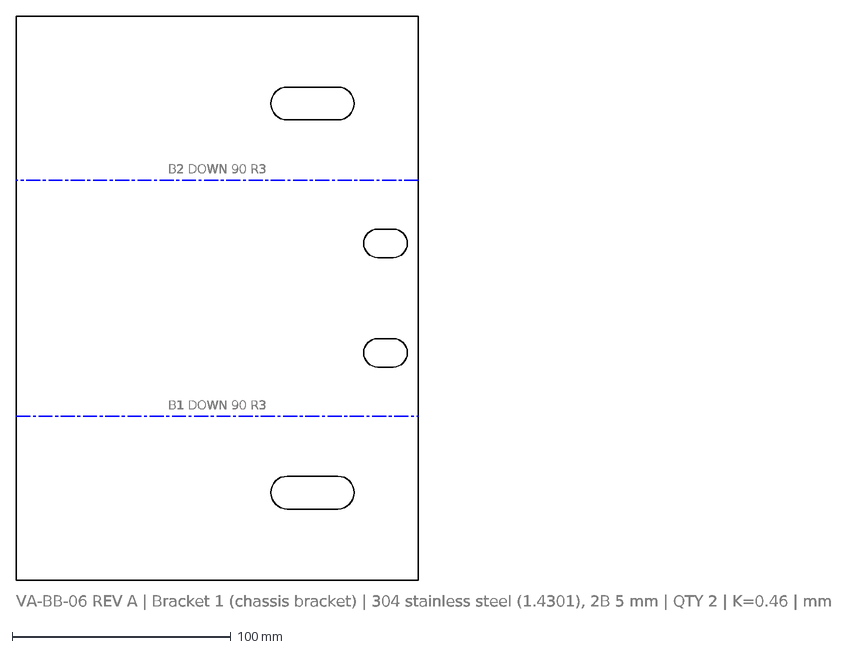
[picture p41: CAD file, 2026-10-19]
VA_BullBar_Data_Pack/dxf/VA-BB-06_Bracket_1_5mm.dxf
B1 DOWN 90 R3
B2 DOWN 90 R3
VA-BB-06 REV A | Bracket 1 (chassis bracket) | 304 stainless steel (1.4301), 2B 5 mm | QTY 2 | K=0.46 | mm
