StormMans/veldarmour/kanopi_raw/Hilux GD6 Double Cab Data Pack (Side door with no windows)/Flat pattern - RRD-1003-Rev-02.dxf

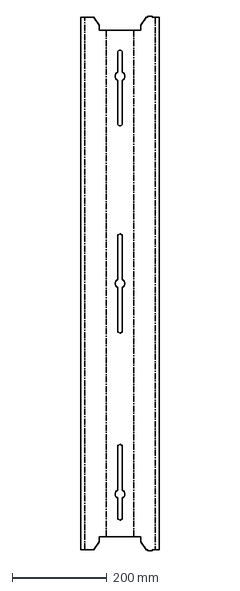
[picture p43: CAD file, 2026-06-11]
kanopi_raw/Hilux GD6 Double Cab Data Pack (Side door with no windows)/Flat pattern - RRD-1003-Rev-02.dxf
165.5 x 1129.8 mm
