StormMans/veldarmour/VA_BullBar_Data_Pack/dxf/VA-BB-07_Recovery_lug_12mm.dxf

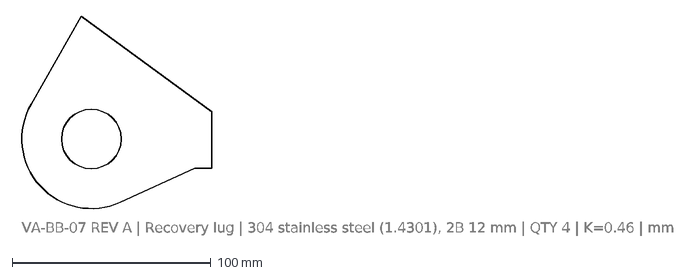
[picture p44: CAD file, 2026-10-19]
VA_BullBar_Data_Pack/dxf/VA-BB-07_Recovery_lug_12mm.dxf
VA-BB-07 REV A | Recovery lug | 304 stainless steel (1.4301), 2B 12 mm | QTY 4 | K=0.46 | mm
