StormMans/veldarmour/kanopi_raw/Hilux GD6 Double Cab Data Pack (Side door with no windows)/2023/GSB-01 v1.0.DXF

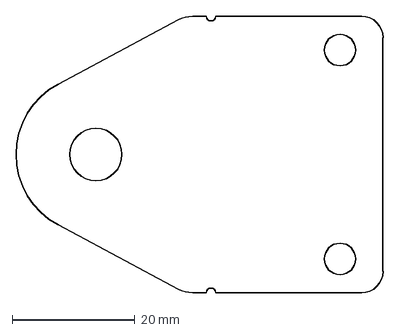
[picture p45: CAD file, 2026-06-11]
kanopi_raw/Hilux GD6 Double Cab Data Pack (Side door with no windows)/2023/GSB-01 v1.0.DXF
59.7 x 45.0 mm
