StormMans/veldarmour/VA_BullBar_Data_Pack/dxf/VA-BB-05_End_plate_3mm.dxf

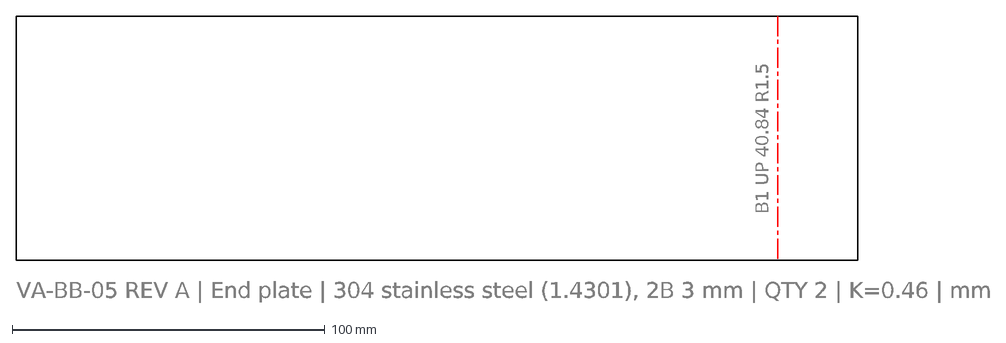
[picture p46: CAD file, 2026-10-19]
VA_BullBar_Data_Pack/dxf/VA-BB-05_End_plate_3mm.dxf
B1 UP 40.84 R1.5
VA-BB-05 REV A | End plate | 304 stainless steel (1.4301), 2B 3 mm | QTY 2 | K=0.46 | mm
