StormMans/veldarmour/VA_BullBar_Data_Pack/dxf/VA-BB-11_Spot_bracket_2mm.dxf

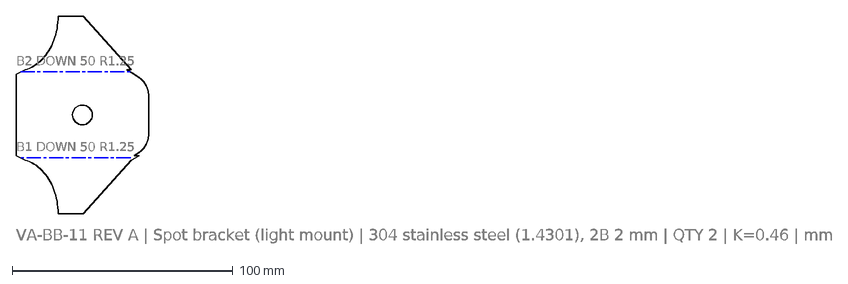
[picture p48: CAD file, 2026-10-19]
VA_BullBar_Data_Pack/dxf/VA-BB-11_Spot_bracket_2mm.dxf
B1 DOWN 50 R1.25
B2 DOWN 50 R1.25
VA-BB-11 REV A | Spot bracket (light mount) | 304 stainless steel (1.4301), 2B 2 mm | QTY 2 | K=0.46 | mm
