StormMans/veldarmour/VA_BullBar_Data_Pack/dxf/VA-BB-01_Centre_panel_3mm.dxf

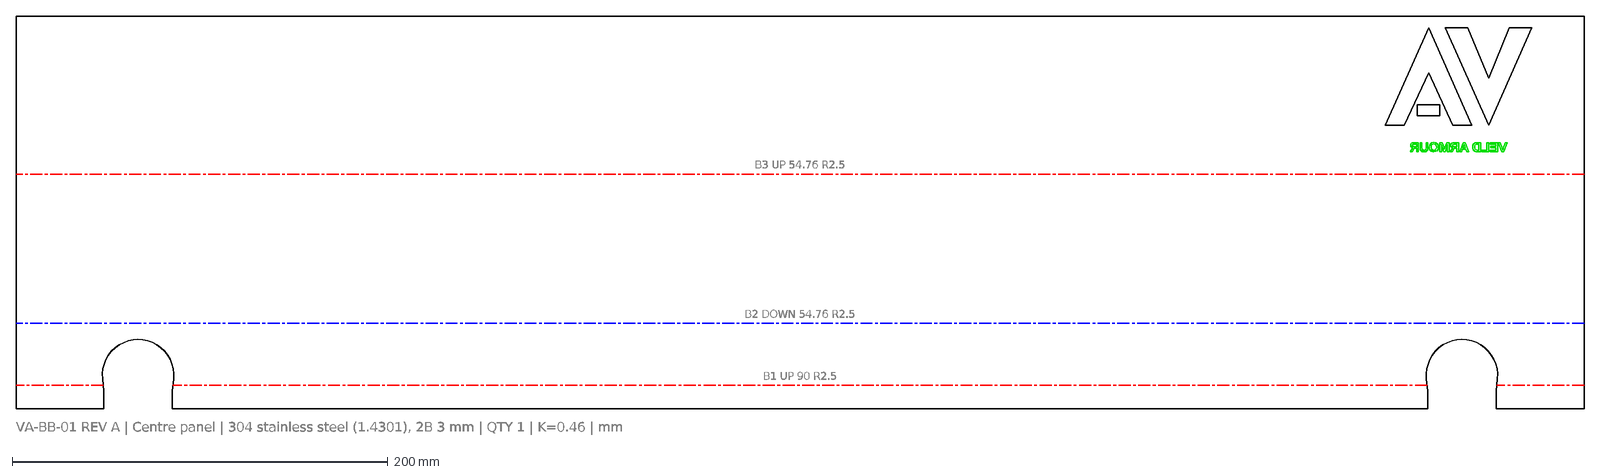
[picture p53: CAD file, 2026-10-19]
VA_BullBar_Data_Pack/dxf/VA-BB-01_Centre_panel_3mm.dxf
B1 UP 90 R2.5
B2 DOWN 54.76 R2.5
B3 UP 54.76 R2.5
VA-BB-01 REV A | Centre panel | 304 stainless steel (1.4301), 2B 3 mm | QTY 1 | K=0.46 | mm
