StormMans/veldarmour/VA_BullBar_Data_Pack/dxf/VA-BB-04_End_panel,_opposite_hand_3mm.dxf

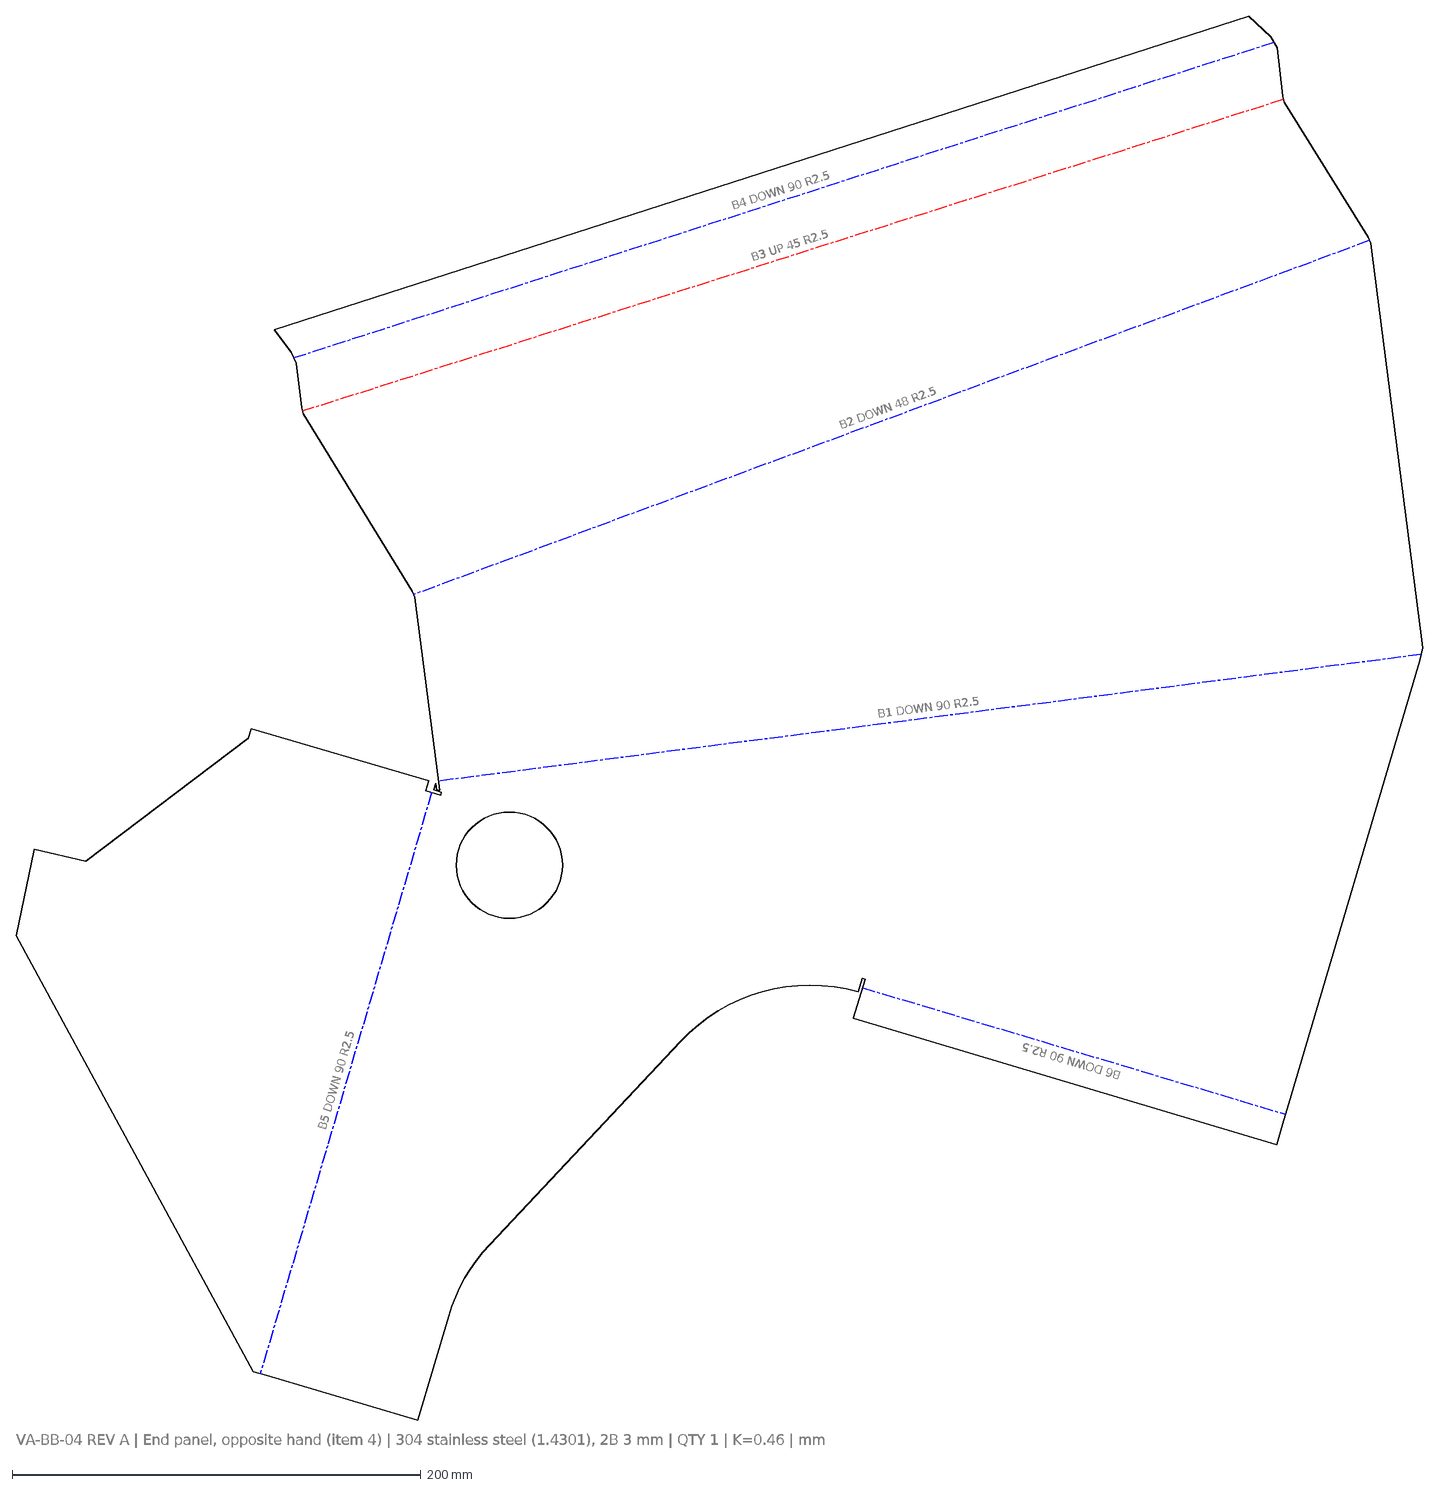
[picture p55: CAD file, 2026-10-19]
VA_BullBar_Data_Pack/dxf/VA-BB-04_End_panel,_opposite_hand_3mm.dxf
B1 DOWN 90 R2.5
B2 DOWN 48 R2.5
B3 UP 45 R2.5
B4 DOWN 90 R2.5
B5 DOWN 90 R2.5
B6 DOWN 90 R2.5
VA-BB-04 REV A | End panel, opposite hand (item 4) | 304 stainless steel (1.4301), 2B 3 mm | QTY 1 | K=0.46 | mm
