StormMans/veldarmour/kanopi_raw/Hilux GD6 Double Cab Data Pack (Side door with no windows)/2023/GSB-02 v1.0.DXF

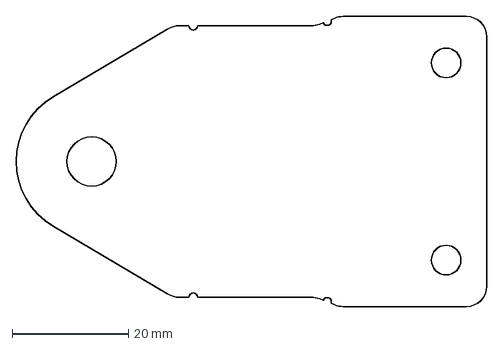
[picture p56: CAD file, 2026-06-11]
kanopi_raw/Hilux GD6 Double Cab Data Pack (Side door with no windows)/2023/GSB-02 v1.0.DXF
81.1 x 50.0 mm
