StormMans/veldarmour/kanopi_raw/Hilux GD6 Double Cab Data Pack (Side door with no windows)/2023/GSB-03 v1.0L.DXF

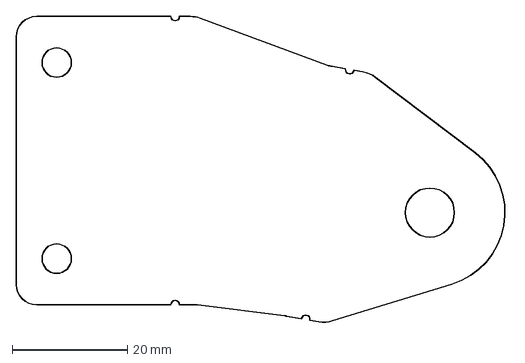
[picture p64: CAD file, 2026-06-11]
kanopi_raw/Hilux GD6 Double Cab Data Pack (Side door with no windows)/2023/GSB-03 v1.0L.DXF
85.4 x 53.1 mm
