StormMans/veldarmour/kanopi_raw/Hilux GD6 Double Cab Data Pack (Side door with no windows)/GD6DC-1023.DXF

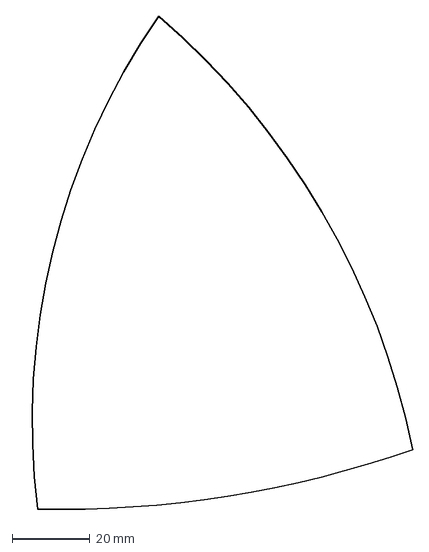
[picture p70: CAD file, 2026-06-11]
kanopi_raw/Hilux GD6 Double Cab Data Pack (Side door with no windows)/GD6DC-1023.DXF
102.4 x 127.9 mm
