StormMans/veldarmour/kanopi_raw/Hilux GD6 Double Cab Data Pack (Side door with no windows)/RRD-1004-Rev-02.DXF

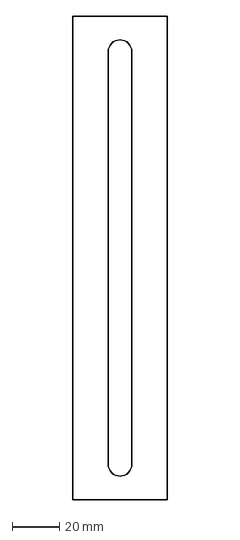
[picture p71: CAD file, 2026-06-11]
kanopi_raw/Hilux GD6 Double Cab Data Pack (Side door with no windows)/RRD-1004-Rev-02.DXF
40.0 x 205.0 mm
