StormMans/veldarmour/kanopi_raw/Hilux GD6 Double Cab Data Pack (Side door with no windows)/GD6DC-1024.DXF

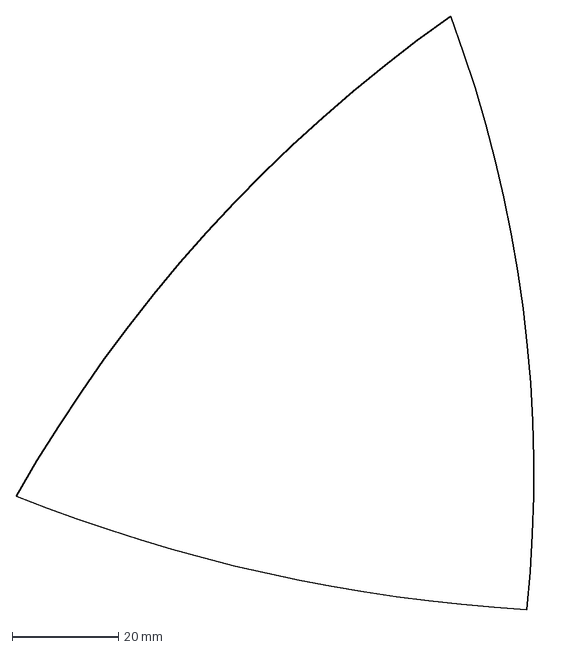
[picture p72: CAD file, 2026-06-11]
kanopi_raw/Hilux GD6 Double Cab Data Pack (Side door with no windows)/GD6DC-1024.DXF
99.9 x 111.5 mm
