StormMans/veldarmour/(list of files, cad)

Other CAD files:
VA_BullBar_Data_Pack/dxf/VA-BB-18_Face_1_LH_2mm.dxf
VA_BullBar_Data_Pack/dxf/VA-BB-17_Face_1_2mm.dxf
VA_BullBar_Data_Pack/source/02106d2d-Flat_pattern_-_centre_P2.DXF
kanopi_raw/Hilux GD6 Double Cab Data Pack (Side door with no windows)/40059_1.dxf
kanopi_raw/Hilux GD6 Double Cab Data Pack (Side door with no windows)/40069_1.dxf
kanopi_raw/Hilux GD6 Double Cab Data Pack (Side door with no windows)/40070_1.dxf
kanopi_raw/Hilux GD6 Double Cab Data Pack (Side door with no windows)/40071_1.dxf
kanopi_raw/Hilux GD6 Double Cab Data Pack (Side door with no windows)/40072_1.dxf
kanopi_raw/Hilux GD6 Double Cab Data Pack (Side door with no windows)/40078_1.dxf
kanopi_raw/Hilux GD6 Double Cab Data Pack (Side door with no windows)/40092_1.dxf
kanopi_raw/Hilux GD6 Double Cab Data Pack (Side door with no windows)/40095_1.dxf
kanopi_raw/Hilux GD6 Double Cab Data Pack (Side door with no windows)/40096_1.dxf
kanopi_raw/Hilux GD6 Double Cab Data Pack (Side door with no windows)/40097_1.dxf
kanopi_raw/Hilux GD6 Double Cab Data Pack (Side door with no windows)/40099_1.dxf
kanopi_raw/Hilux GD6 Double Cab Data Pack (Side door with no windows)/40100_1.dxf
kanopi_raw/Hilux GD6 Double Cab Data Pack (Side door with no windows)/40101_1.dxf
kanopi_raw/Hilux GD6 Double Cab Data Pack (Side door with no windows)/40102_1.dxf
kanopi_raw/Hilux GD6 Double Cab Data Pack (Side door with no windows)/40103_1.dxf
kanopi_raw/Hilux GD6 Double Cab Data Pack (Side door with no windows)/40104_1-Rev 3.dxf
kanopi_raw/Hilux GD6 Double Cab Data Pack (Side door with no windows)/40105_1.DXF
kanopi_raw/Hilux GD6 Double Cab Data Pack (Side door with no windows)/40106_1.dxf
kanopi_raw/Hilux GD6 Double Cab Data Pack (Side door with no windows)/40107_1.dxf
kanopi_raw/Hilux GD6 Double Cab Data Pack (Side door with no windows)/40108_1.dxf
kanopi_raw/Hilux GD6 Double Cab Data Pack (Side door with no windows)/40109_1.dxf
kanopi_raw/Hilux GD6 Double Cab Data Pack (Side door with no windows)/40110_1.dxf
kanopi_raw/Hilux GD6 Double Cab Data Pack (Side door with no windows)/40112_1.dxf
kanopi_raw/Hilux GD6 Double Cab Data Pack (Side door with no windows)/40160_1.dxf
kanopi_raw/Hilux GD6 Double Cab Data Pack (Side door with no windows)/40165_1.dxf
kanopi_raw/Hilux GD6 Double Cab Data Pack (Side door with no windows)/40166_1.dxf
kanopi_raw/Hilux GD6 Double Cab Data Pack (Side door with no windows)/40167_1.dxf
kanopi_raw/Hilux GD6 Double Cab Data Pack (Side door with no windows)/40168_1.dxf
kanopi_raw/Hilux GD6 Double Cab Data Pack (Side door with no windows)/40169_1.dxf
kanopi_raw/Hilux GD6 Double Cab Data Pack (Side door with no windows)/40170_1.dxf
kanopi_raw/Hilux GD6 Double Cab Data Pack (Side door with no windows)/40171_1.dxf
kanopi_raw/Hilux GD6 Double Cab Data Pack (Side door with no windows)/40172.dxf
kanopi_raw/Hilux GD6 Double Cab Data Pack (Side door with no windows)/40173.dxf
kanopi_raw/Hilux GD6 Double Cab Data Pack (Side door with no windows)/40174.dxf
