StormMans/veldarmour/VA_BullBar_Data_Pack/source/2dd2abdf-assy.PDF

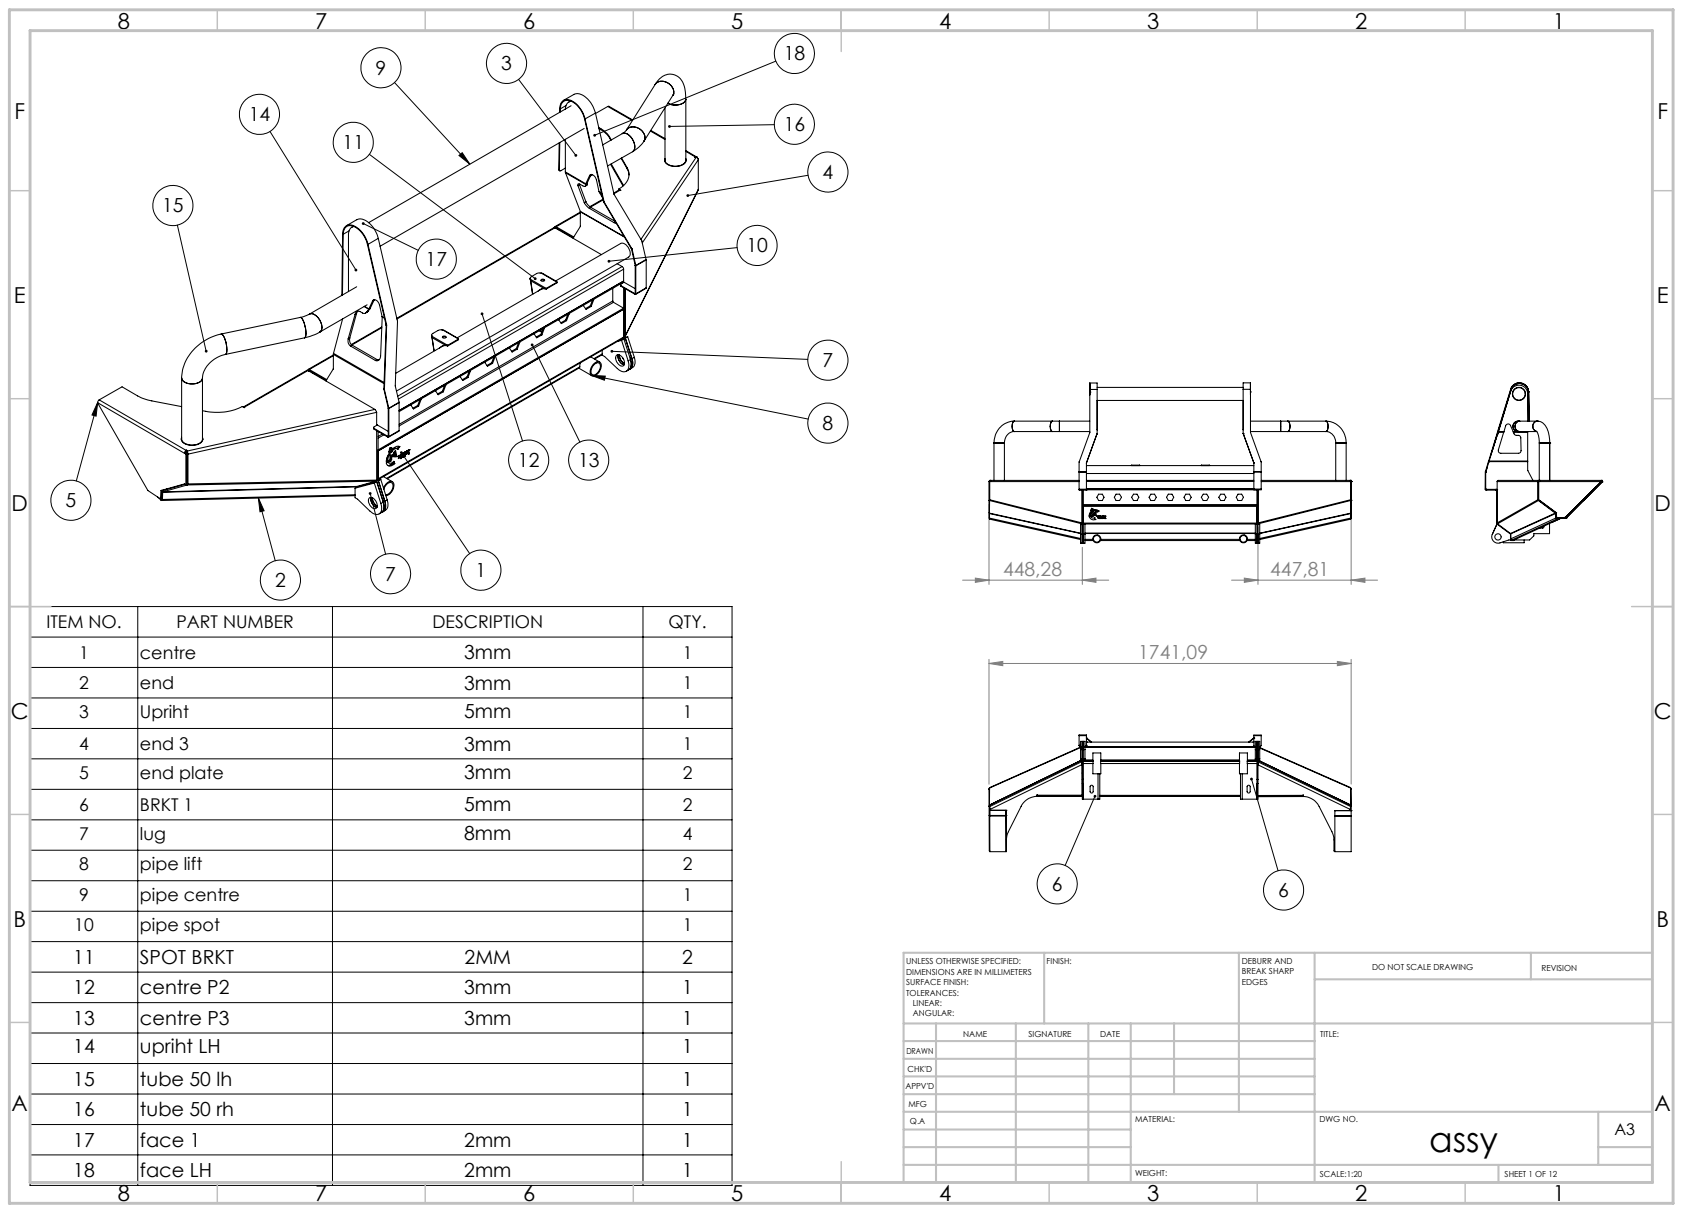
[picture p87: page 1]
tube 50 rh; FINISH:; DEBURR AND; BREAK SHARP; DO NOT SCALE DRAWING; REVISION

ITEM NO. | PART NUMBER | DESCRIPTION | QTY.
1 | centre | 3mm | 1

3 | Upriht | 5mm | 1
4 | end 3 | 3mm | 1
5 | end plate | 3mm | 2
6 | BRKT 1 | 5mm | 2
7 | lug | 8mm | 4
8 | pipe lift | | 2
9 | pipe centre | | 1
10 | pipe spot | | 1
11 | SPOT BRKT | 2MM | 2
12 | centre P2 | 3mm | 1
13 | centre P3 | 3mm | 1
14 | upriht LH | | 1
15 | tube 50 lh | | 1

UNLESS OTHERWISE SPECIFIED:
DIMENSIONS ARE IN MILLIMETERS
SURFACE FINISH:
TOLERANCES:
LINEAR:
ANGULAR:

NAME | SIGNATURE | DATE | TITLE:

DRAWN
CHK'D
APPV'D

Q.A | MATERIAL: | DWG NO. assy | A3

17 | face 1 | 2mm | 1
18 | face LH | 2mm | 1

WEIGHT: | SCALE:1:20 | SHEET 1 OF 12

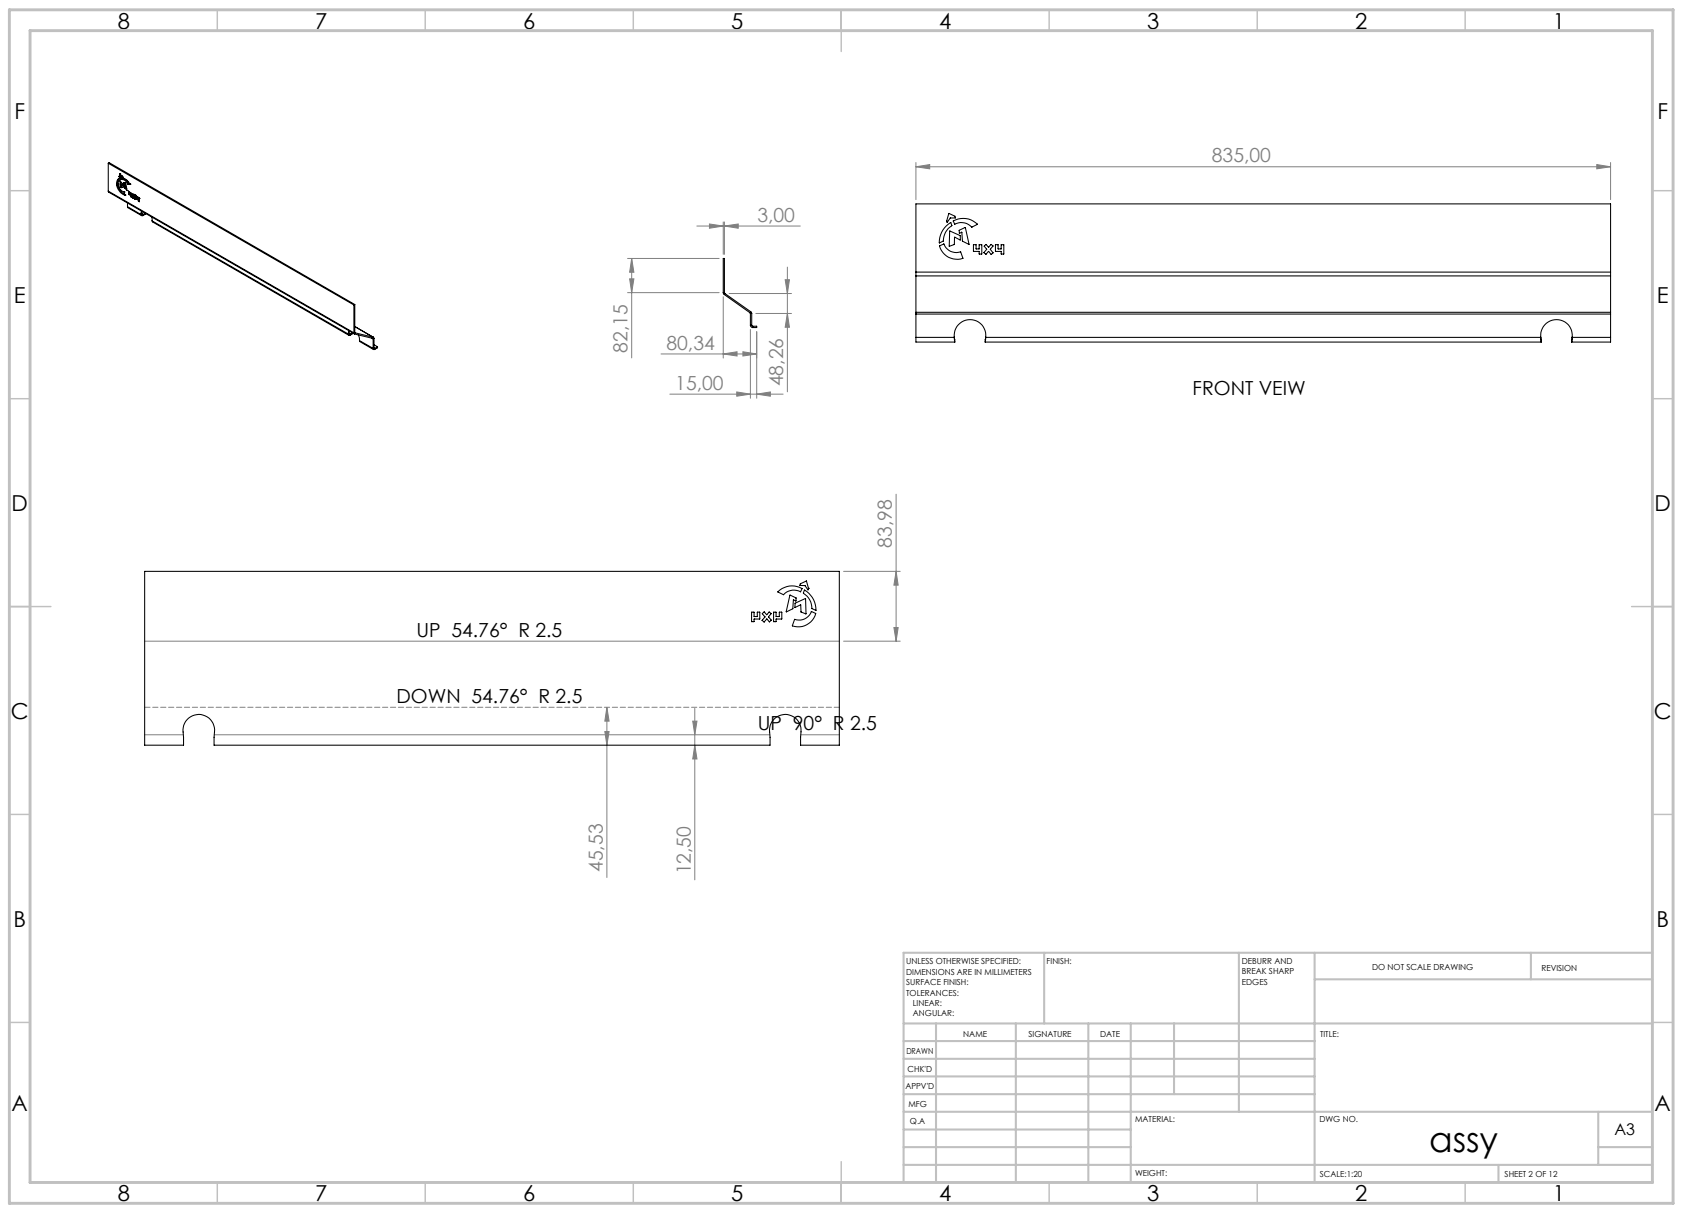
[picture p88: page 2]
DOWN 54.76° R 2.5; FRONT VEIW; FINISH:; DEBURR AND; BREAK SHARP; DO NOT SCALE DRAWING; REVISION

UNLESS OTHERWISE SPECIFIED:
DIMENSIONS ARE IN MILLIMETERS
SURFACE FINISH:
TOLERANCES:
LINEAR:
ANGULAR:

NAME | SIGNATURE | DATE | TITLE:

DRAWN
CHK'D
APPV'D
MFG

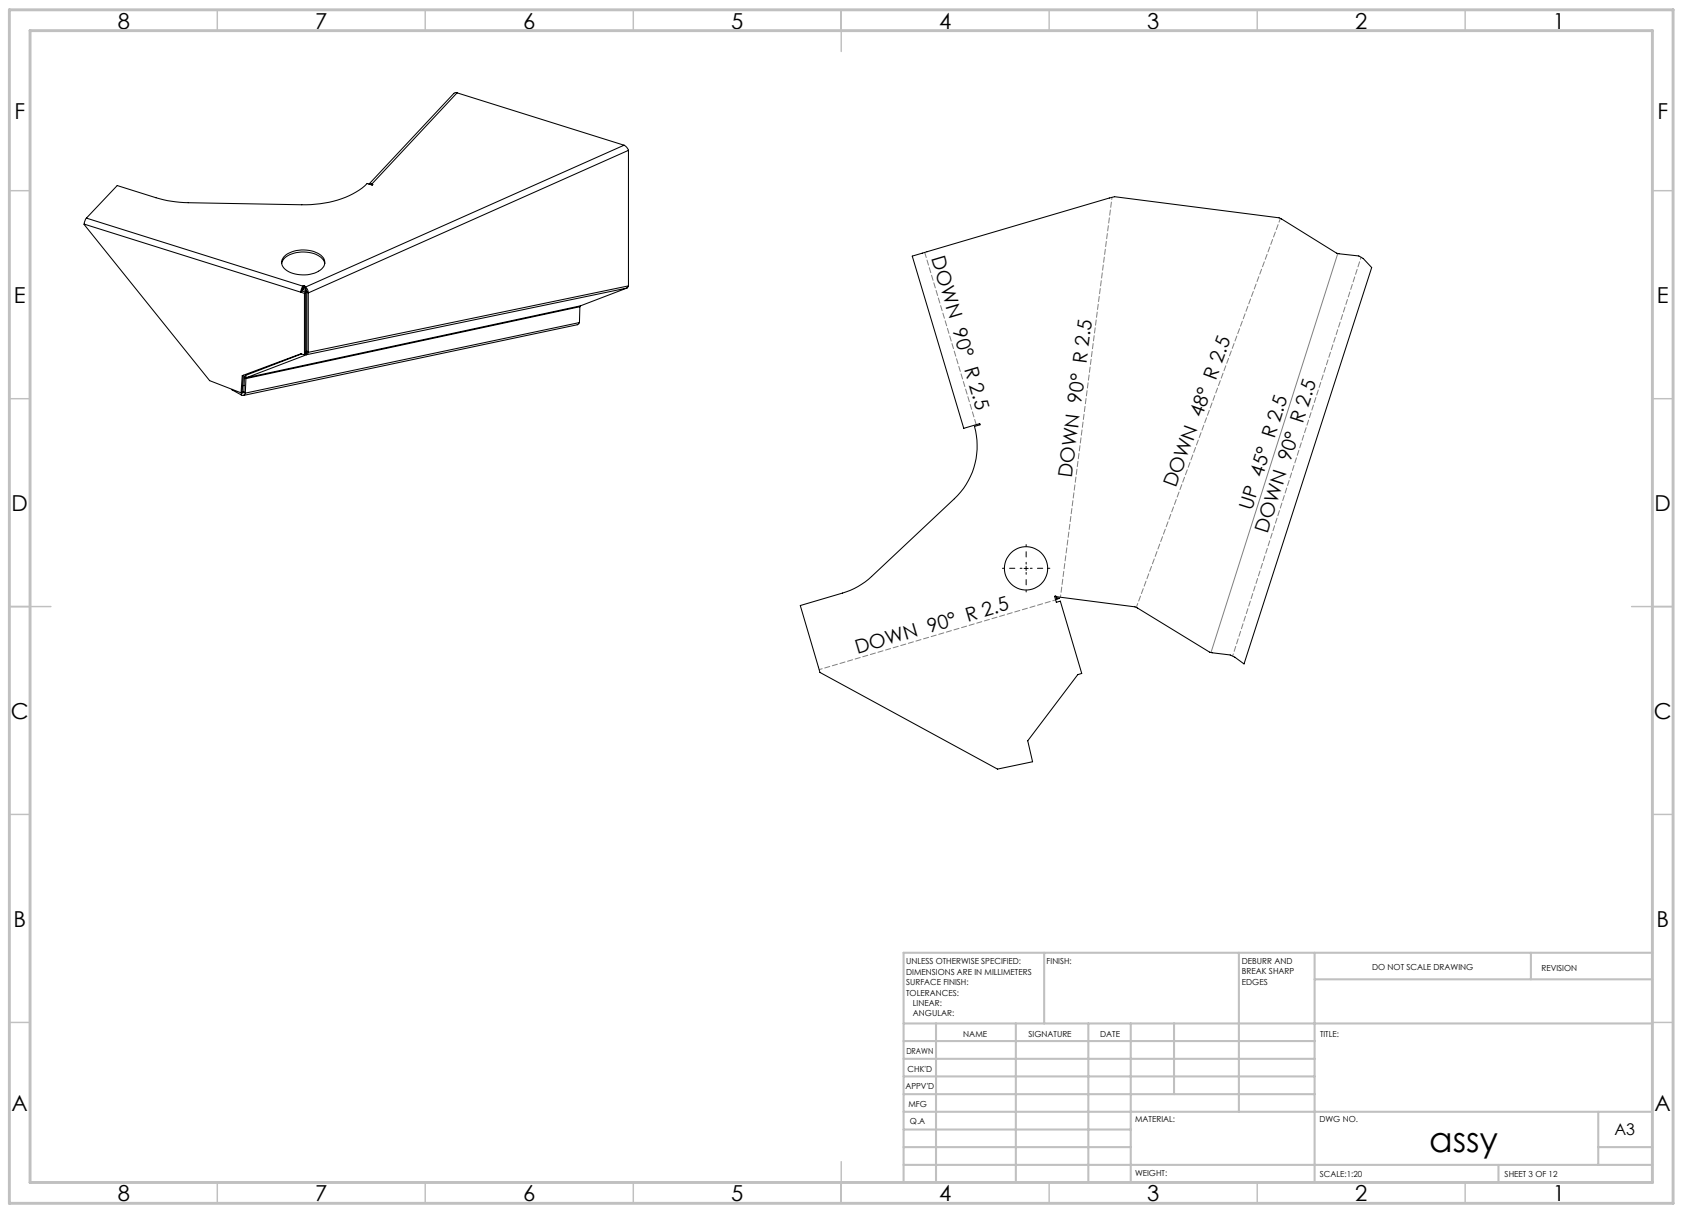
[picture p89: page 3]
DOWN 90° R 2.5 DOWN 90° R 2.5; DOWN 90° R 2.5 UP 45° R 2.5; DOWN 48° R 2.5; DOWN 90° R 2.5; FINISH:; DEBURR AND; BREAK SHARP; DO NOT SCALE DRAWING; REVISION

UNLESS OTHERWISE SPECIFIED:
DIMENSIONS ARE IN MILLIMETERS
SURFACE FINISH:
TOLERANCES:
LINEAR:
ANGULAR:

NAME | SIGNATURE | DATE | TITLE:

DRAWN
CHK'D
APPV'D
MFG

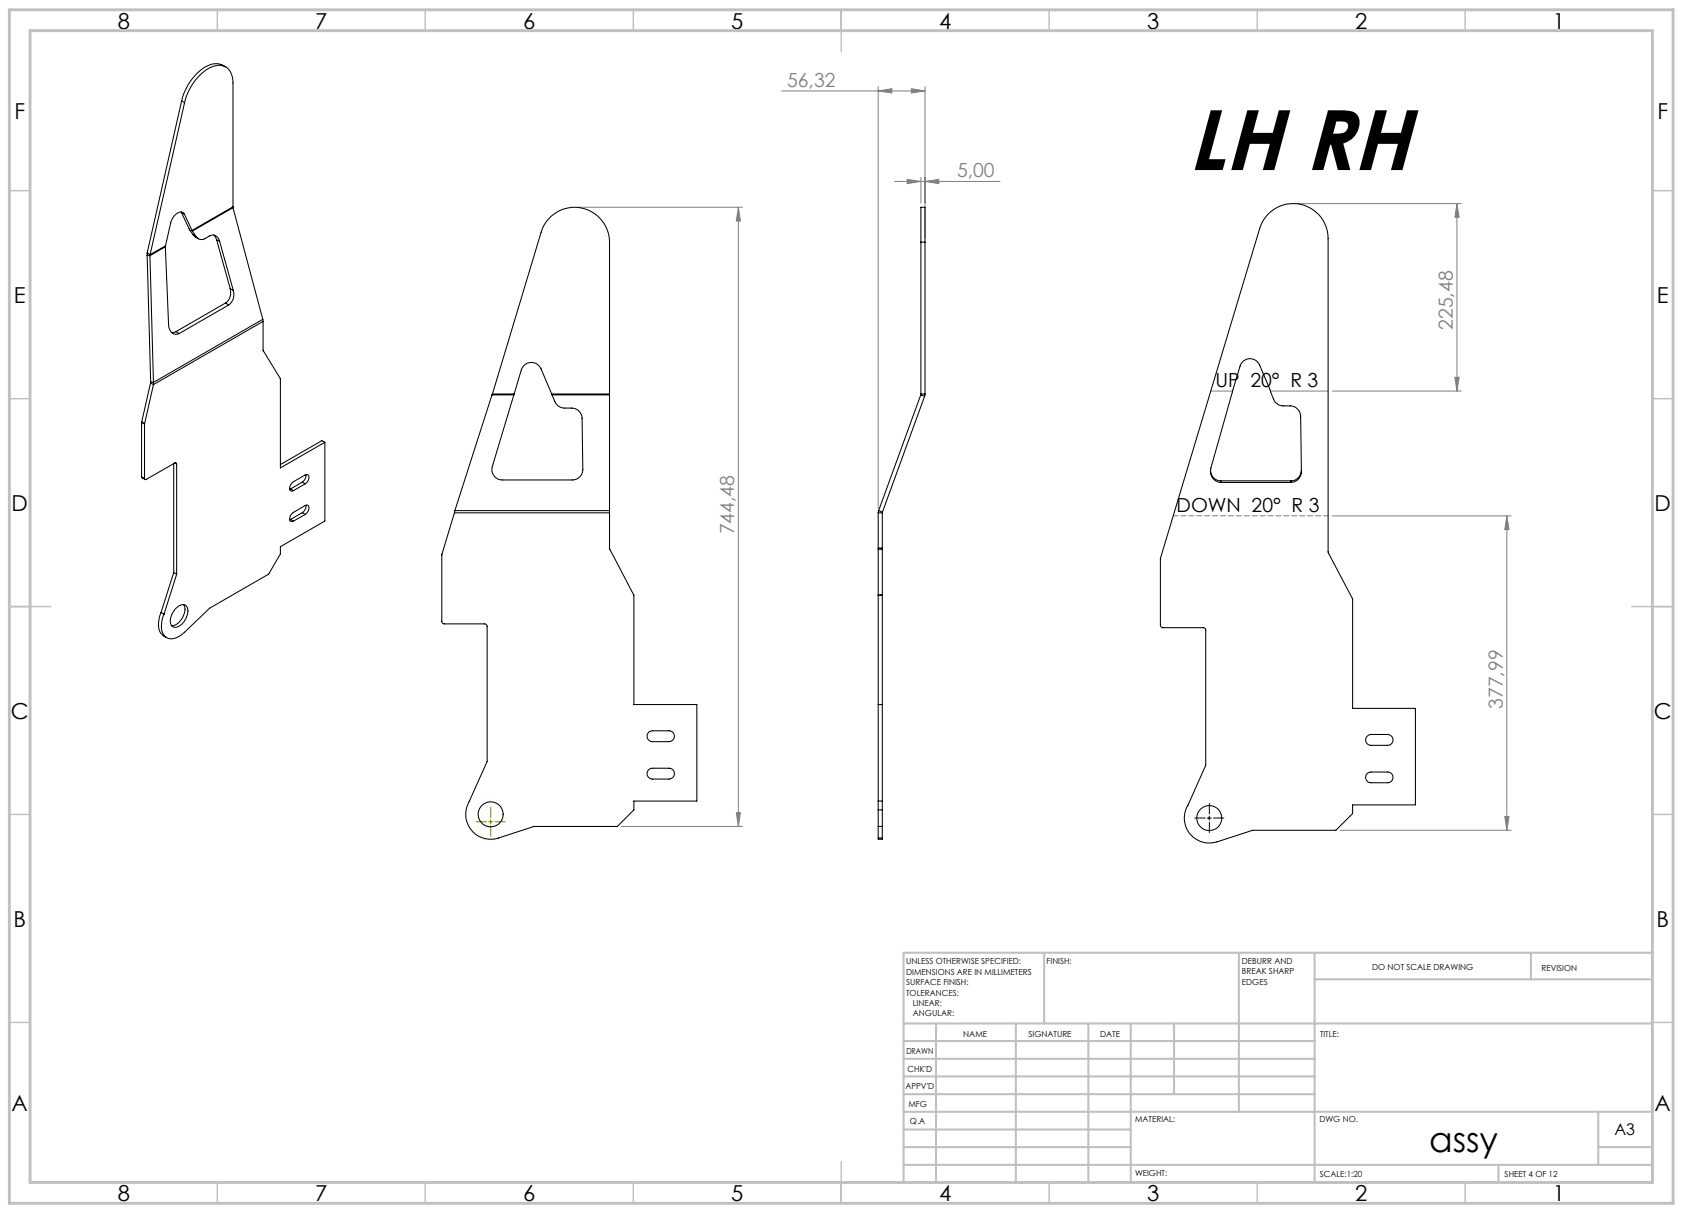
[picture p90: page 4]
DOWN 20° R 3; FINISH:; DEBURR AND; BREAK SHARP; DO NOT SCALE DRAWING; REVISION

UNLESS OTHERWISE SPECIFIED:
DIMENSIONS ARE IN MILLIMETERS
SURFACE FINISH:
TOLERANCES:
LINEAR:
ANGULAR:

NAME | SIGNATURE | DATE | TITLE:

DRAWN
CHK'D
APPV'D
MFG

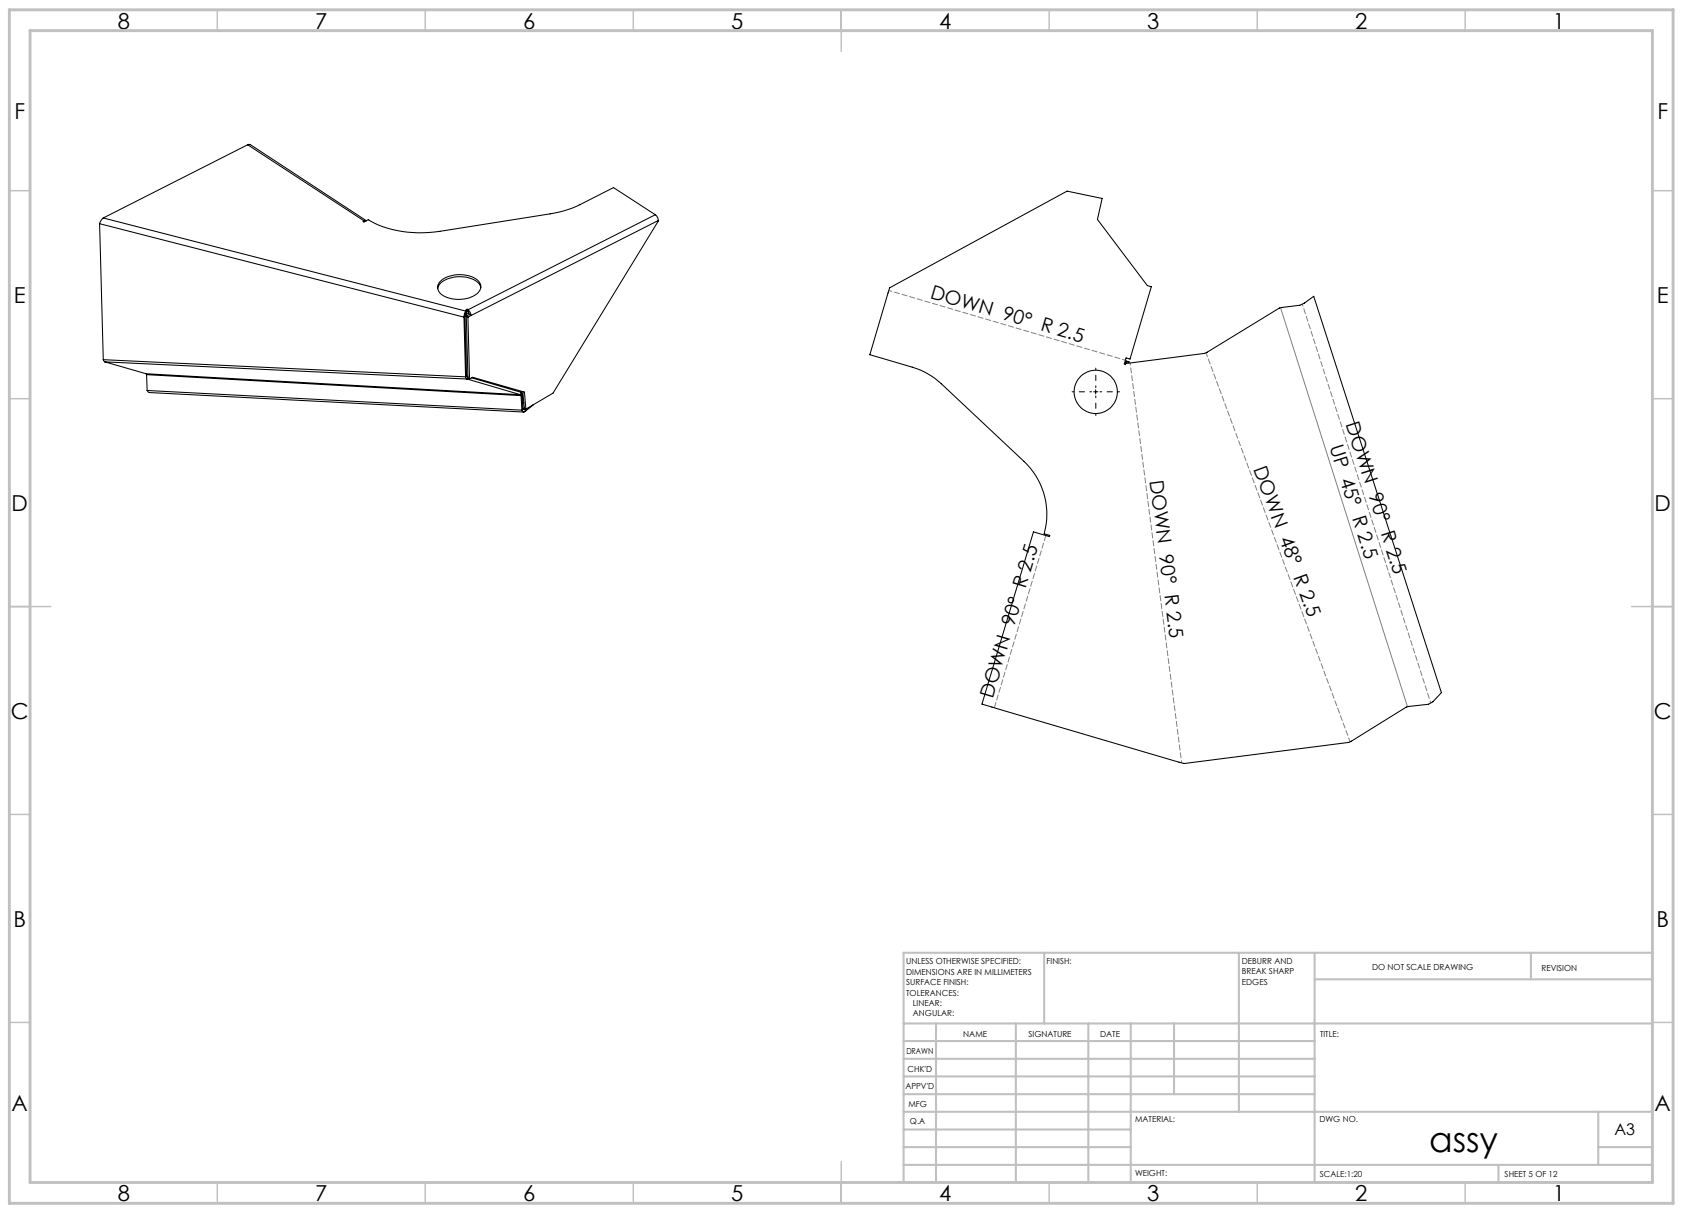
[picture p91: page 5]
DOWN 48° R 2.5; DOWN 90° R 2.5 DOWN 90° R 2.5; DOWN 90° R 2.5 UP 45° R 2.5; DOWN 90° R 2.5; FINISH:; DEBURR AND; BREAK SHARP; DO NOT SCALE DRAWING; REVISION

UNLESS OTHERWISE SPECIFIED:
DIMENSIONS ARE IN MILLIMETERS
SURFACE FINISH:
TOLERANCES:
LINEAR:
ANGULAR:

NAME | SIGNATURE | DATE | TITLE:

DRAWN
CHK'D
APPV'D
MFG

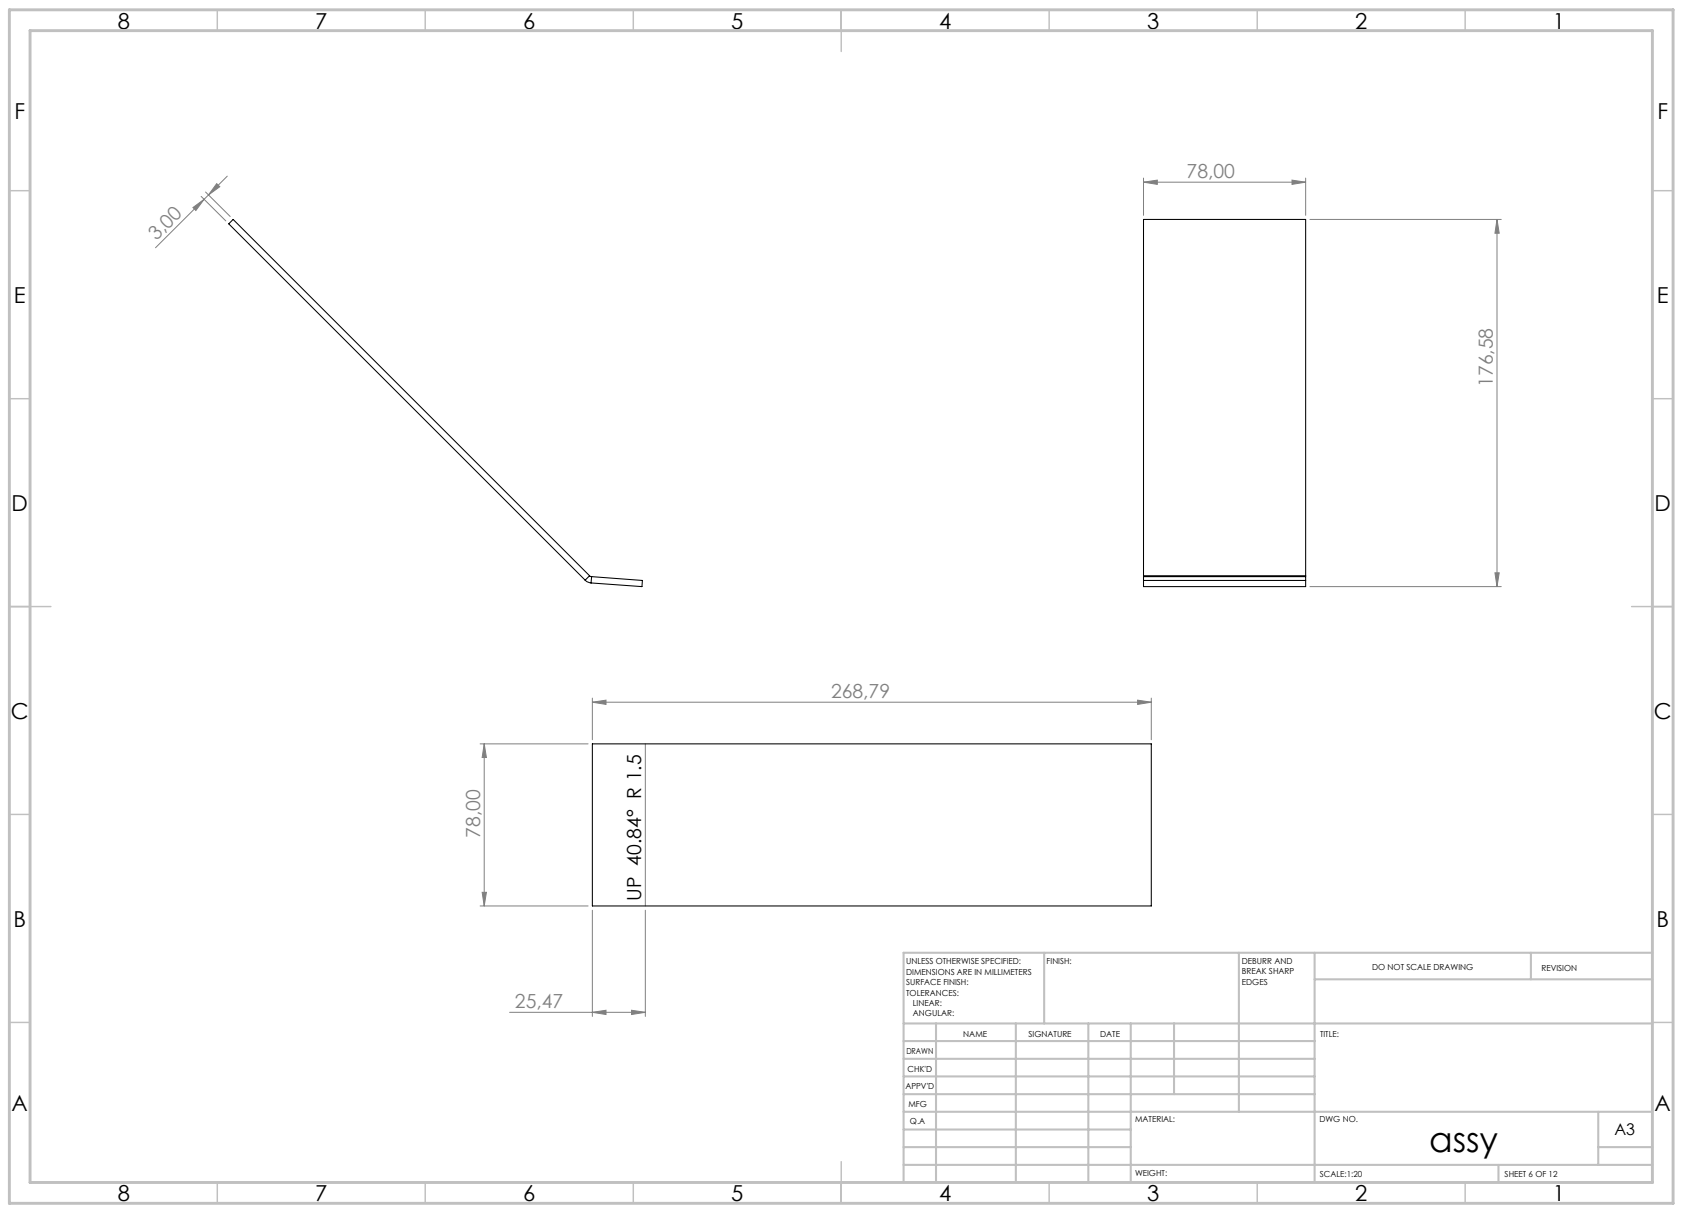
[picture p92: page 6]
FINISH:; DEBURR AND; BREAK SHARP; DO NOT SCALE DRAWING; REVISION

UNLESS OTHERWISE SPECIFIED:
DIMENSIONS ARE IN MILLIMETERS
SURFACE FINISH:
TOLERANCES:
LINEAR:
ANGULAR:

NAME | SIGNATURE | DATE | TITLE:

DRAWN
CHK'D
APPV'D
MFG

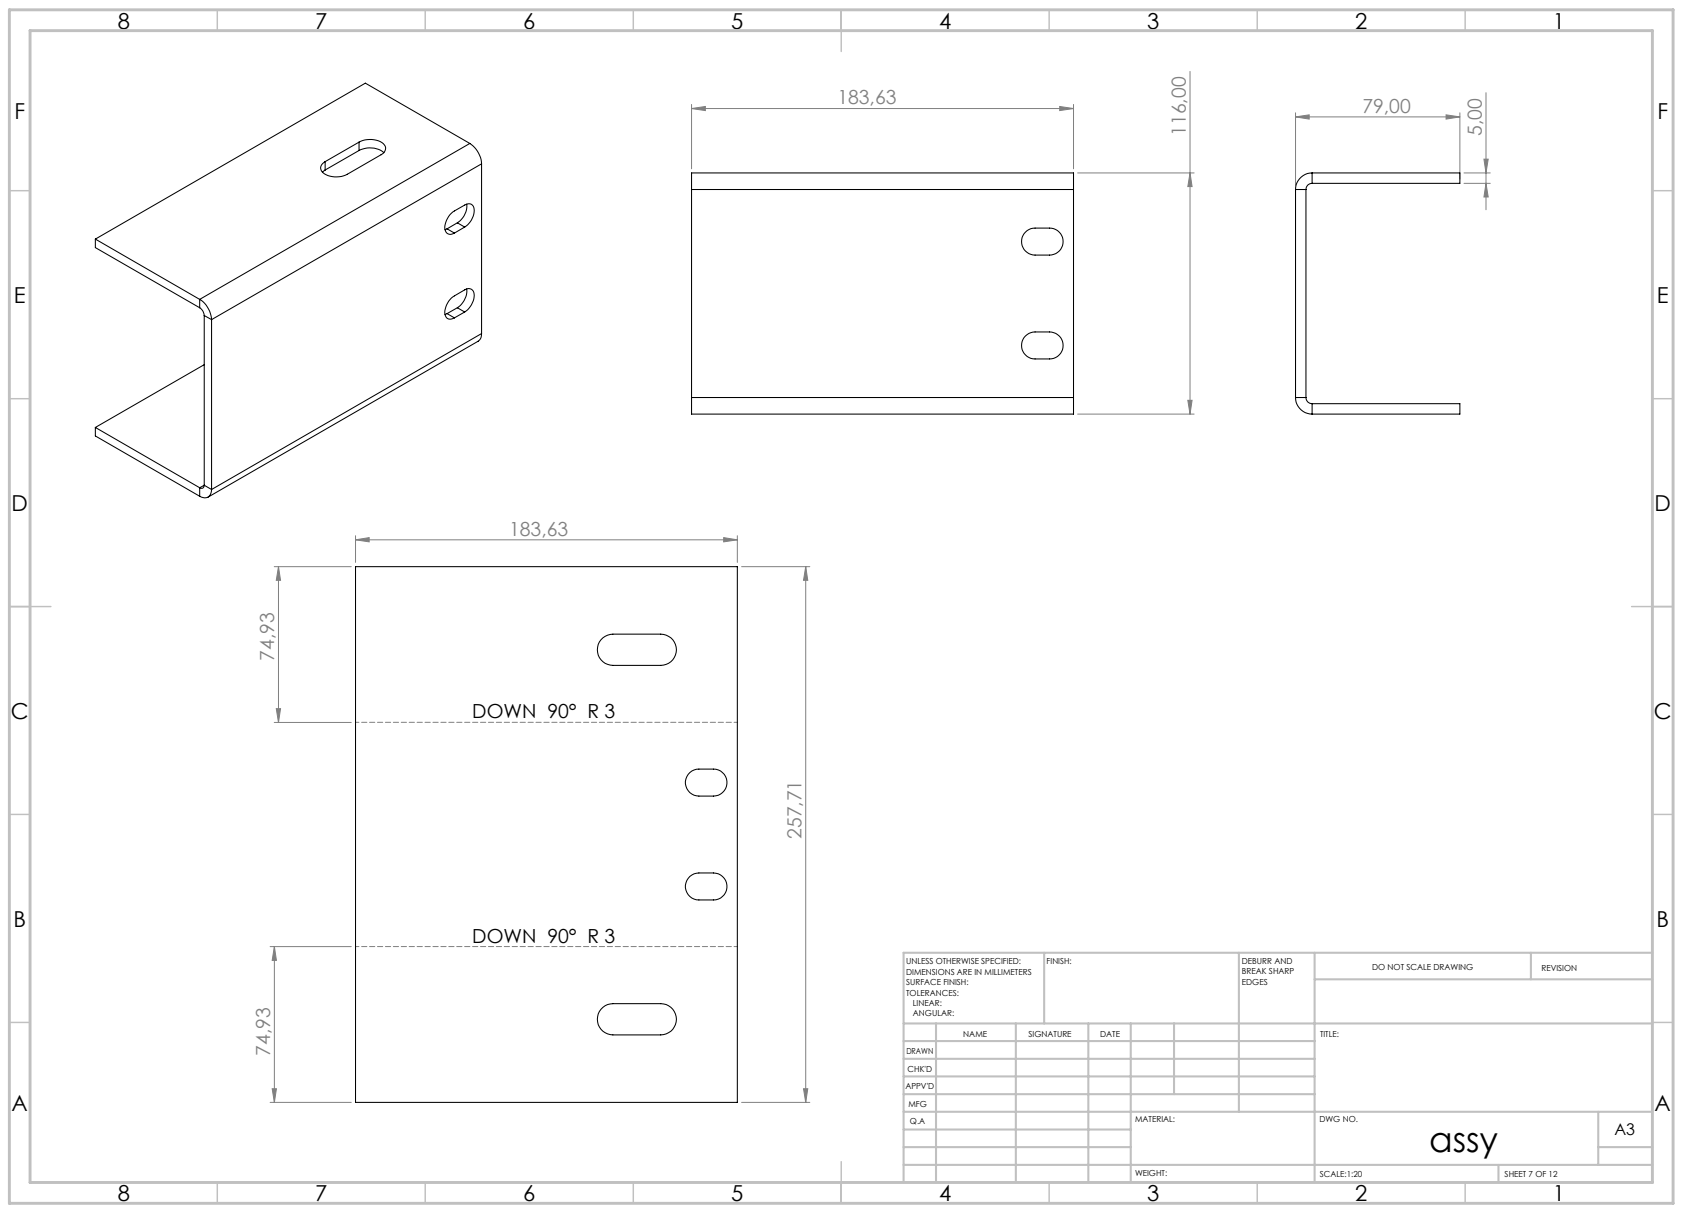
[picture p93: page 7]
DOWN 90° R 3; FINISH:; DEBURR AND; BREAK SHARP; DO NOT SCALE DRAWING; REVISION

UNLESS OTHERWISE SPECIFIED:
DIMENSIONS ARE IN MILLIMETERS
SURFACE FINISH:
TOLERANCES:
LINEAR:
ANGULAR:

NAME | SIGNATURE | DATE | TITLE:

DRAWN
CHK'D
APPV'D
MFG

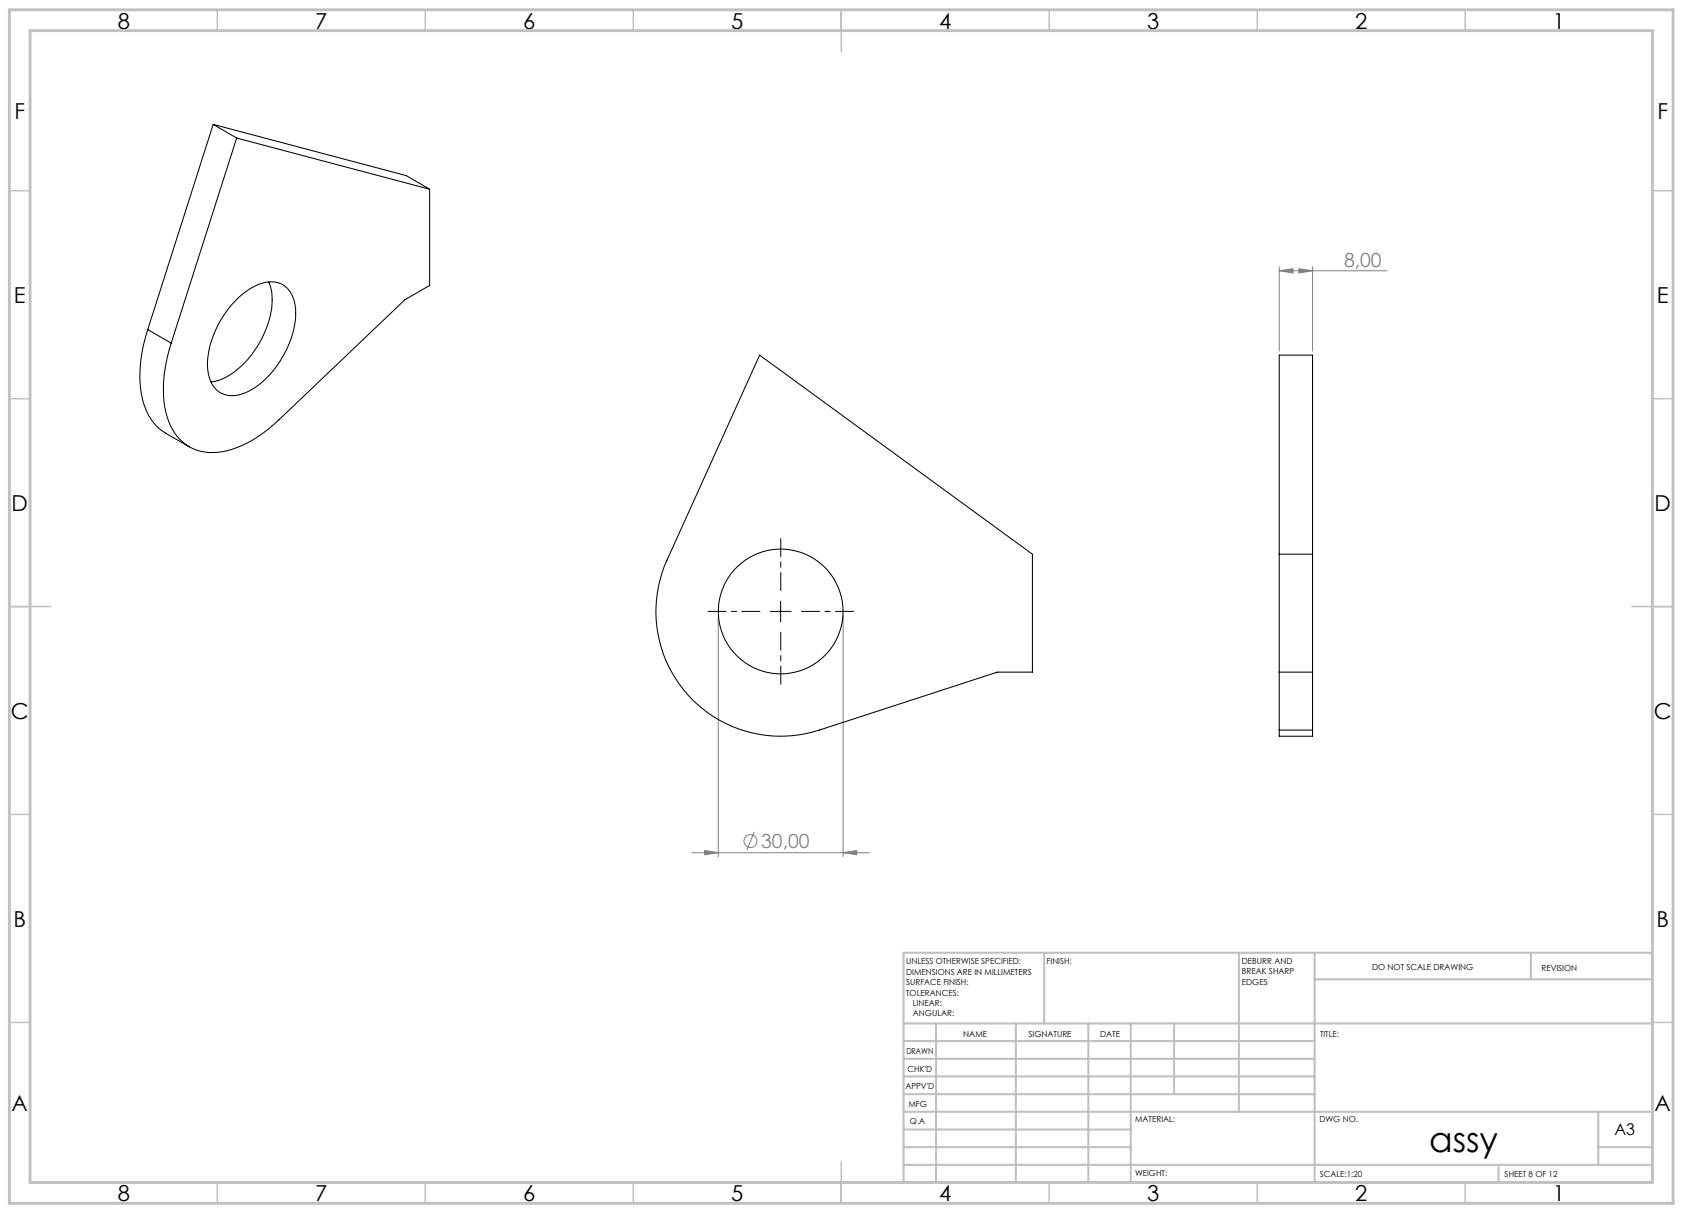
[picture p94: page 8]
FINISH:; DEBURR AND; BREAK SHARP; DO NOT SCALE DRAWING; REVISION

UNLESS OTHERWISE SPECIFIED:
DIMENSIONS ARE IN MILLIMETERS
SURFACE FINISH:
TOLERANCES:
LINEAR:
ANGULAR:

NAME | SIGNATURE | DATE | TITLE:

DRAWN
CHK'D
APPV'D
MFG

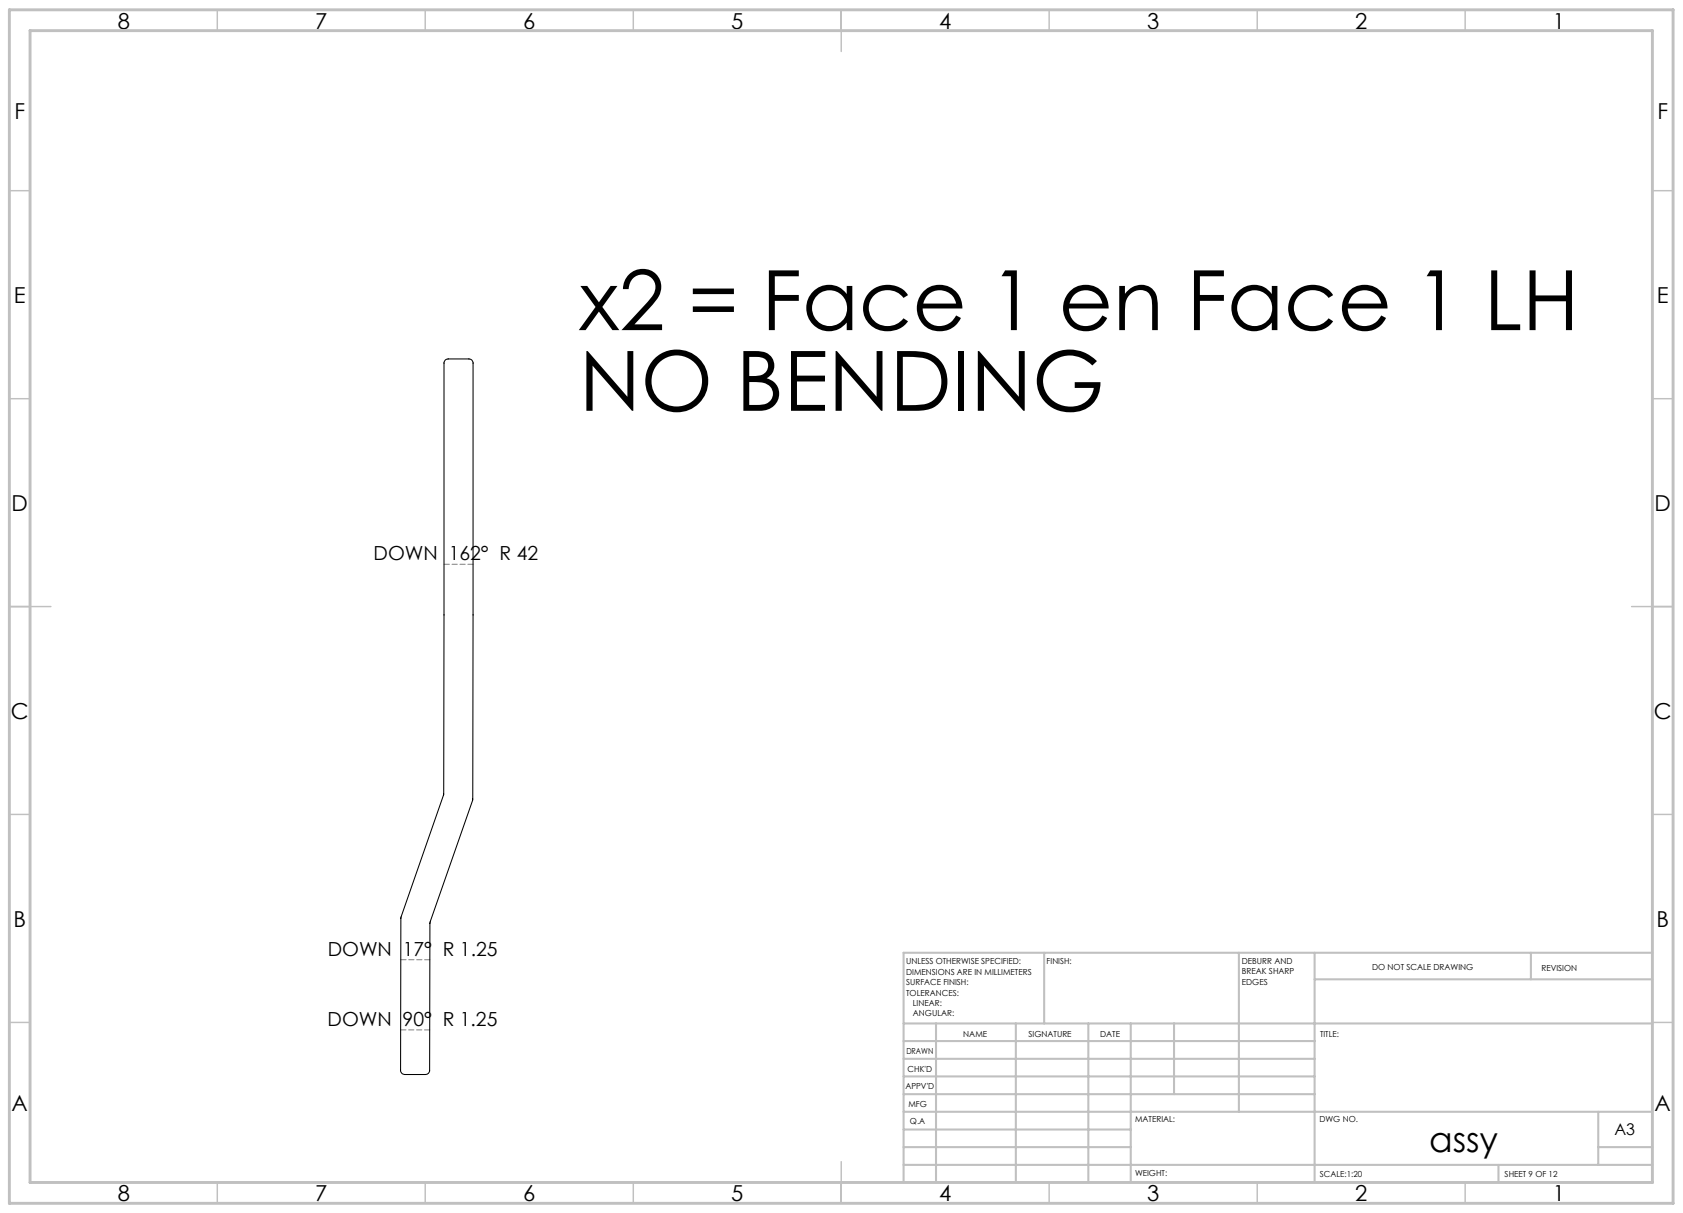
[picture p95: page 9]
DOWN 90° R 1.25; DOWN 17° R 1.25; DOWN 162° R 42; FINISH:; DEBURR AND; BREAK SHARP; DO NOT SCALE DRAWING; REVISION

x2 = Face 1 en Face 1 LH
NO BENDING

UNLESS OTHERWISE SPECIFIED:
DIMENSIONS ARE IN MILLIMETERS
SURFACE FINISH:
TOLERANCES:
LINEAR:
ANGULAR:

NAME | SIGNATURE | DATE | TITLE:

DRAWN
CHK'D
APPV'D
MFG

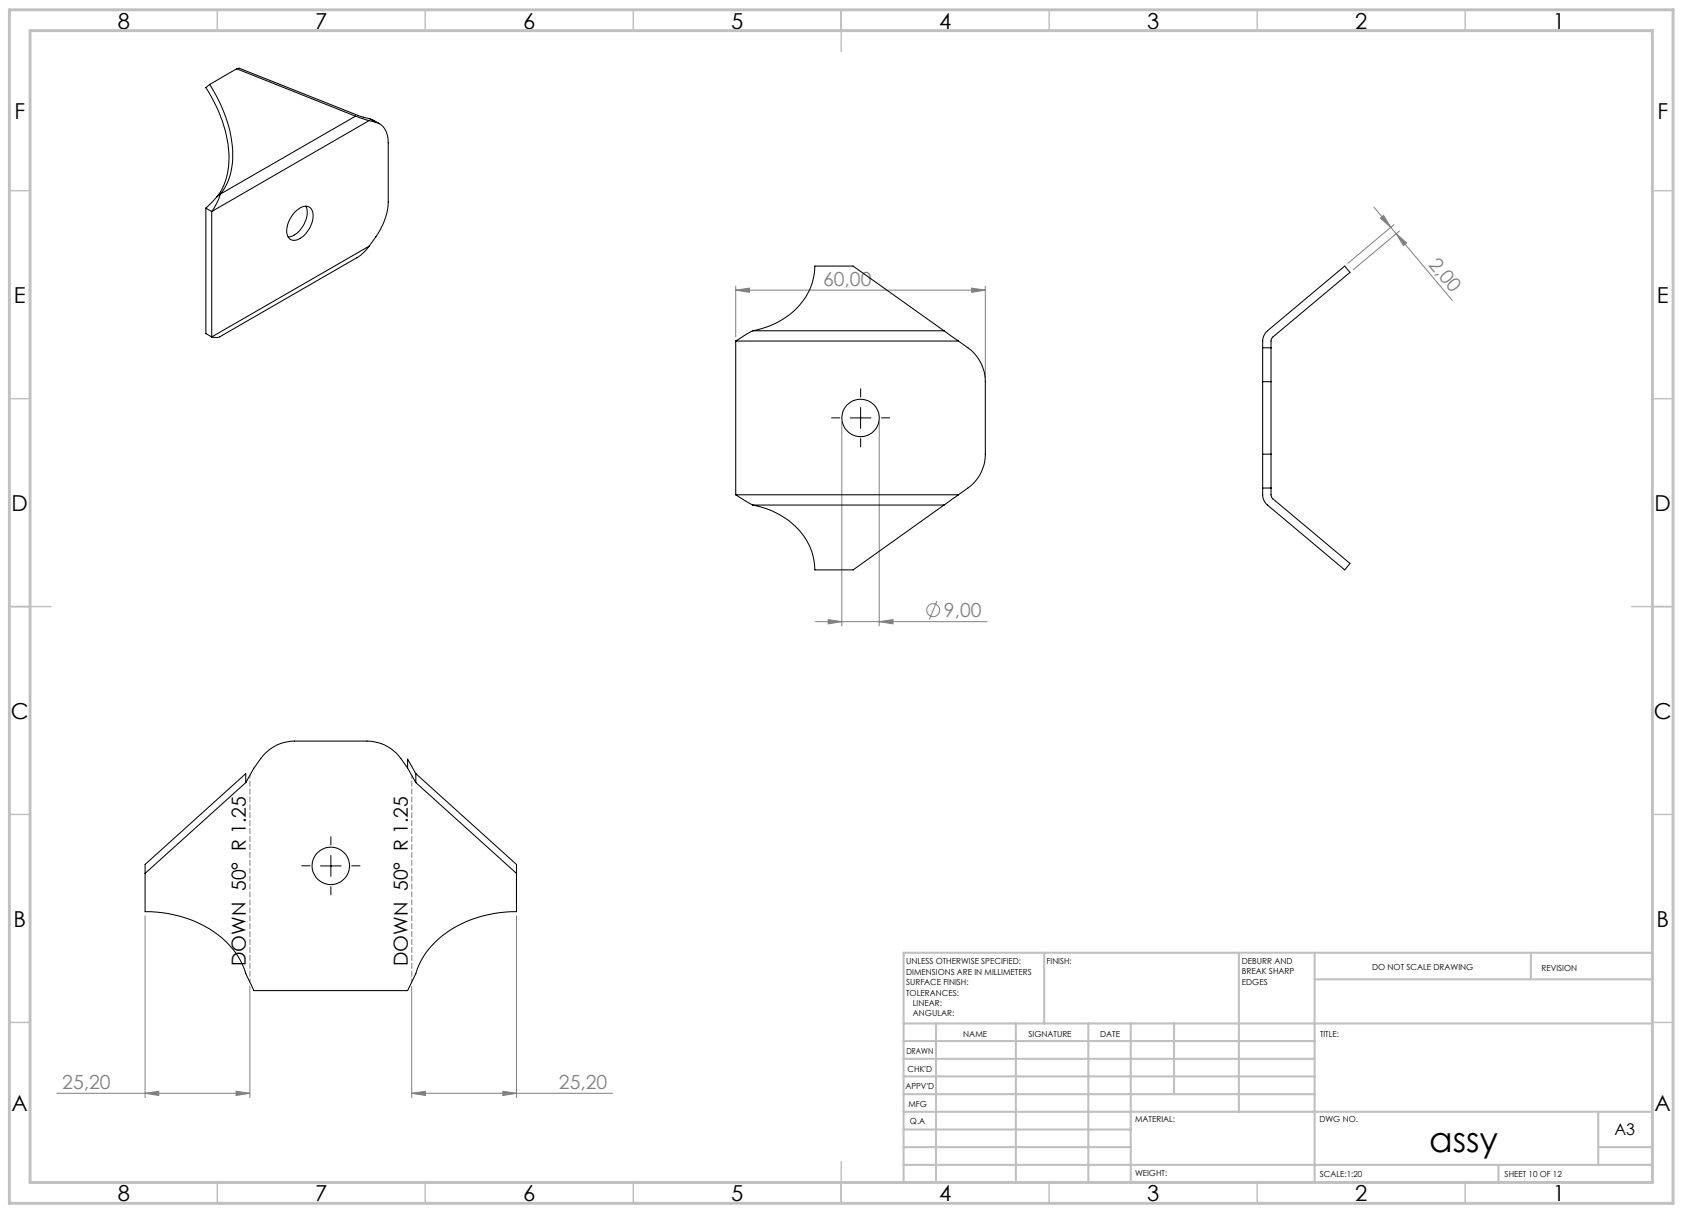
[picture p96: page 10]
25,20 DOWN 50° R 1.25; DOWN 50° R 1.25; FINISH:; DEBURR AND; BREAK SHARP; DO NOT SCALE DRAWING; REVISION

UNLESS OTHERWISE SPECIFIED:
DIMENSIONS ARE IN MILLIMETERS
SURFACE FINISH:
TOLERANCES:
LINEAR:
ANGULAR:

NAME | SIGNATURE | DATE | TITLE:

DRAWN
CHK'D
APPV'D
MFG

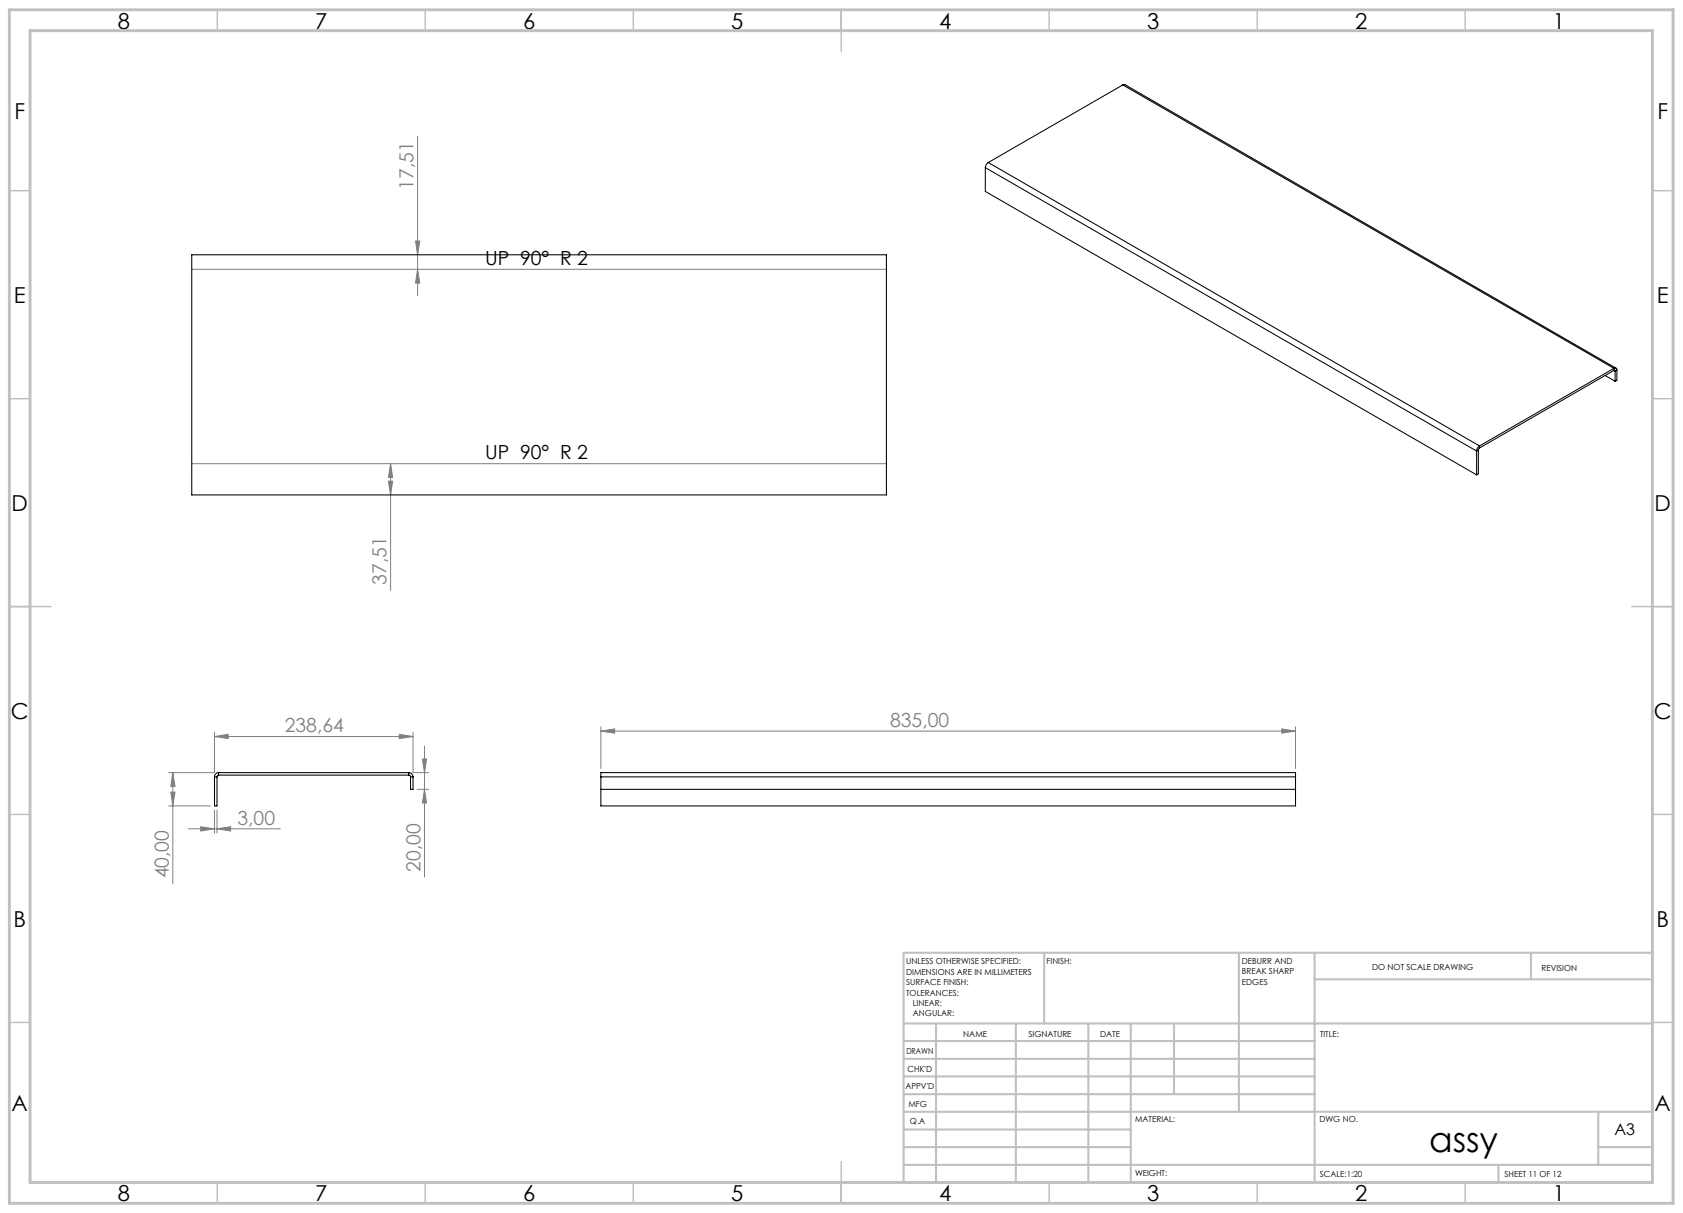
[picture p97: page 11]
FINISH:; DEBURR AND; BREAK SHARP; DO NOT SCALE DRAWING; REVISION

UNLESS OTHERWISE SPECIFIED:
DIMENSIONS ARE IN MILLIMETERS
SURFACE FINISH:
TOLERANCES:
LINEAR:
ANGULAR:

NAME | SIGNATURE | DATE | TITLE:

DRAWN
CHK'D
APPV'D
MFG

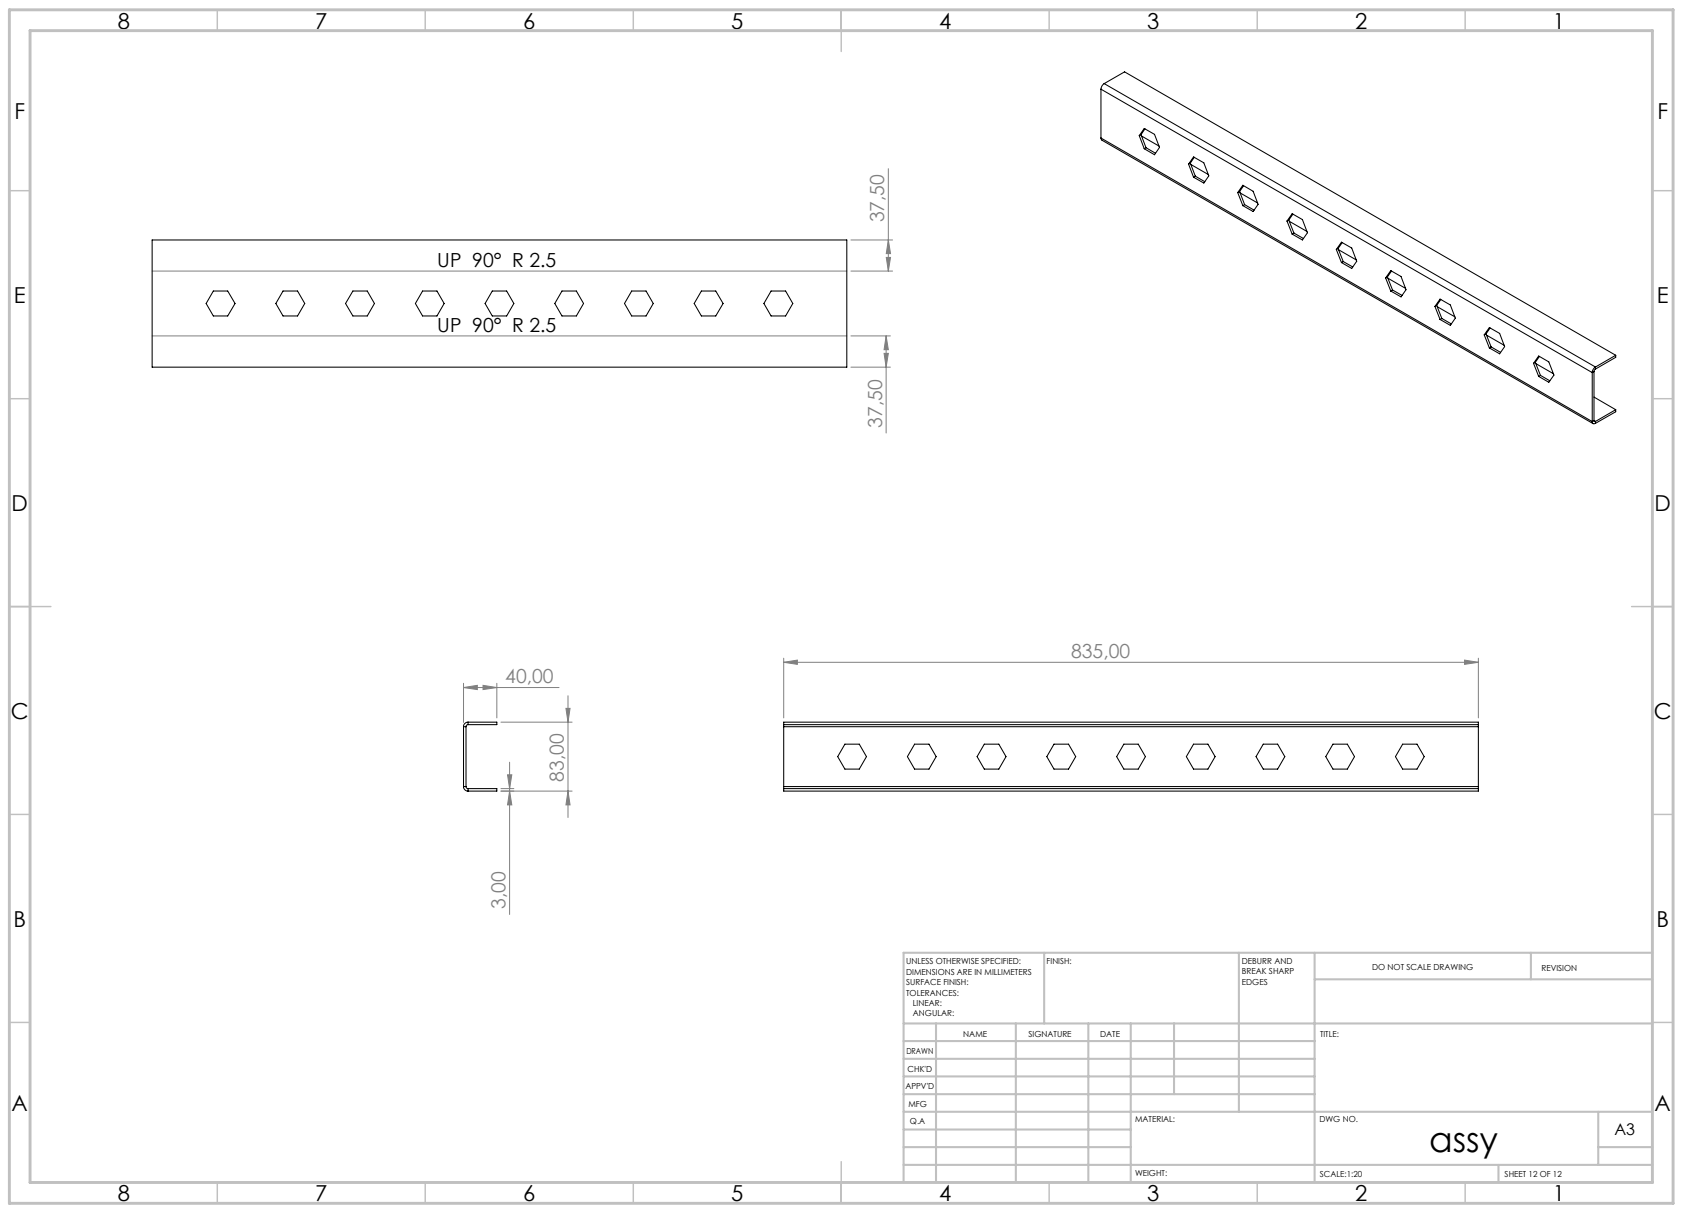
[picture p98: page 12]
FINISH:; DEBURR AND; BREAK SHARP; DO NOT SCALE DRAWING; REVISION

UNLESS OTHERWISE SPECIFIED:
DIMENSIONS ARE IN MILLIMETERS
SURFACE FINISH:
TOLERANCES:
LINEAR:
ANGULAR:

NAME | SIGNATURE | DATE | TITLE:

DRAWN
CHK'D
APPV'D
MFG
