StormMans/veldarmour/kanopi_raw/Hilux GD6 Double Cab Data Pack (Side door with no windows)/Roof Rack-DC-Rev-02.PDF

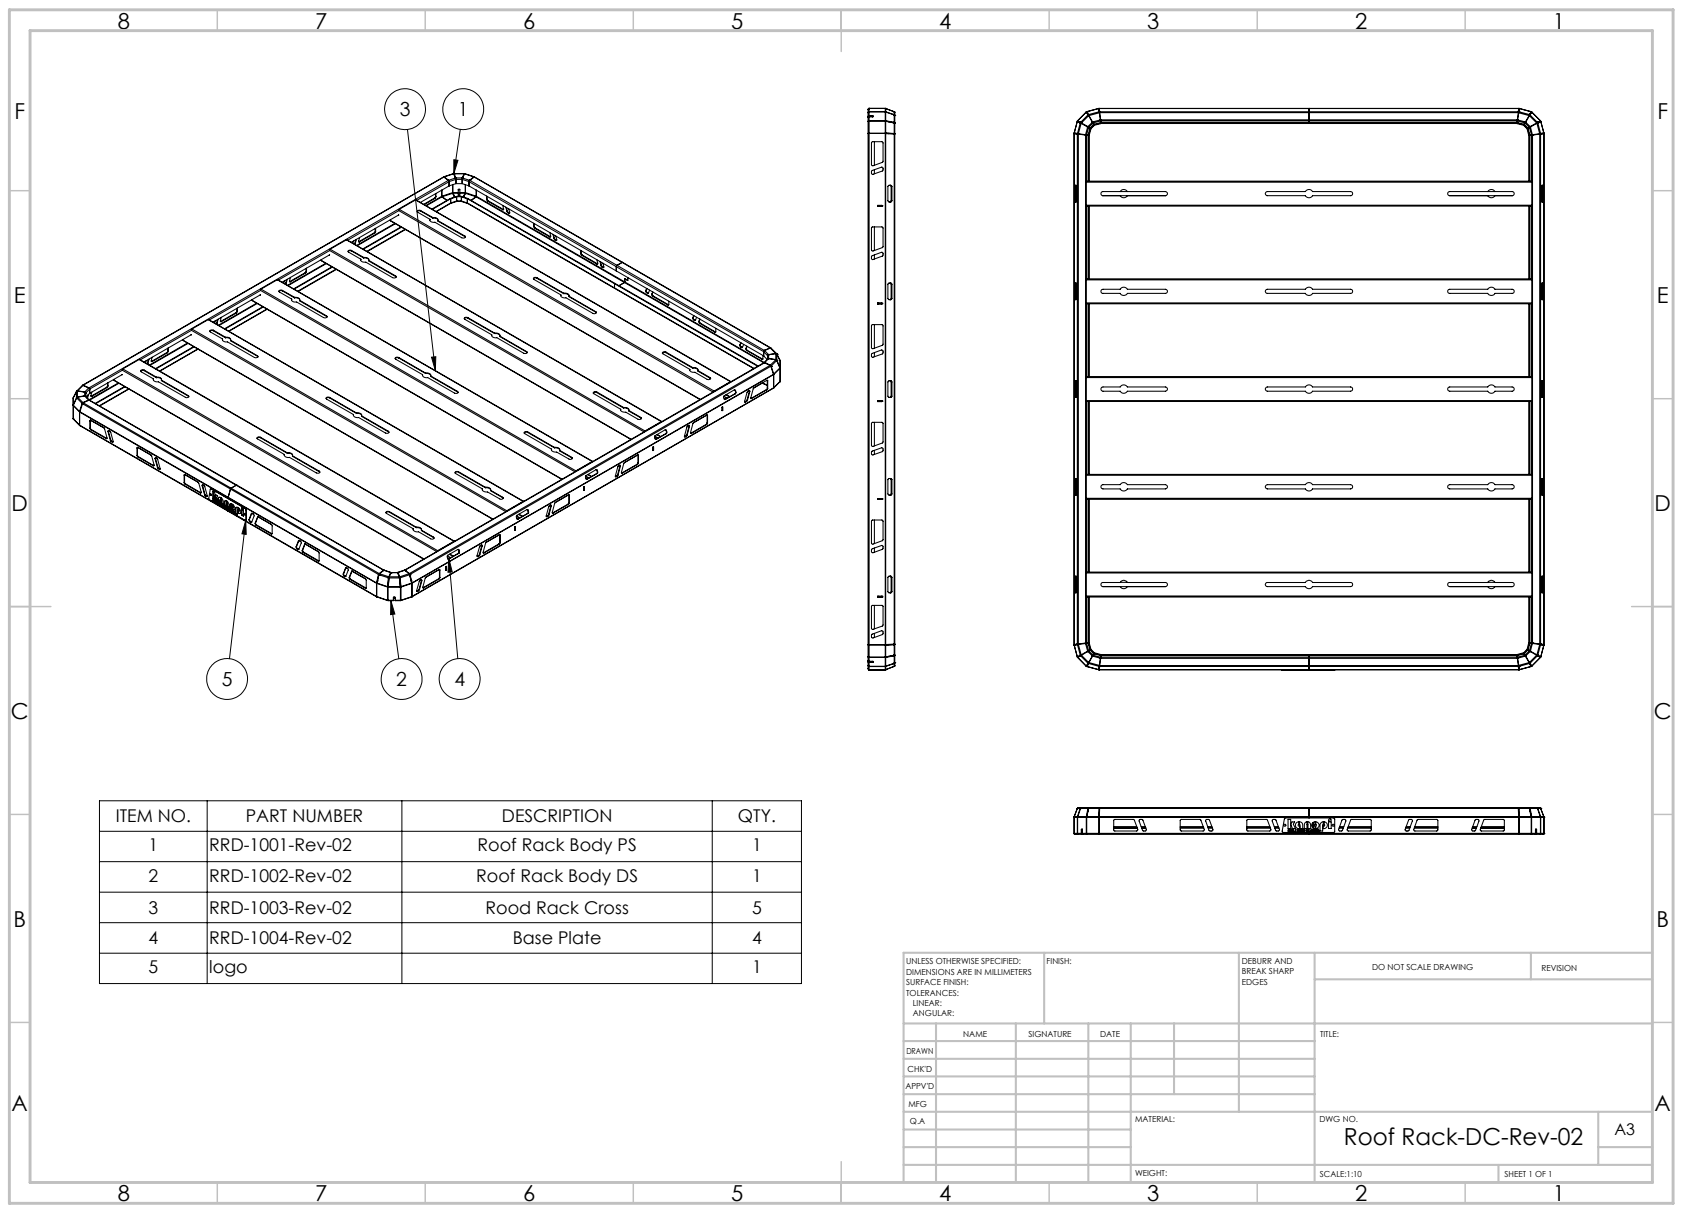
[picture p102: page 1]
FINISH:; DEBURR AND; BREAK SHARP; DO NOT SCALE DRAWING; REVISION; SCALE:1:10; SHEET 1 OF 1

ITEM NO. | PART NUMBER | DESCRIPTION | QTY.
1 | RRD-1001-Rev-02 | Roof Rack Body PS | 1
2 | RRD-1002-Rev-02 | Roof Rack Body DS | 1
3 | RRD-1003-Rev-02 | Rood Rack Cross | 5
4 | RRD-1004-Rev-02 | Base Plate | 4

UNLESS OTHERWISE SPECIFIED:
DIMENSIONS ARE IN MILLIMETERS
SURFACE FINISH:
TOLERANCES:
LINEAR:
ANGULAR:

NAME | SIGNATURE | DATE | | | | TITLE:

DRAWN
CHK'D
APPV'D
MFG
Q.A | | | | MATERIAL: | DWG NO. Roof Rack-DC-Rev-02 | A3
