StormMans/veldarmour/kanopi_raw/Hilux GD6 Double Cab Data Pack (Side door with no windows)/2023/GSB-01 v1.0.pdf

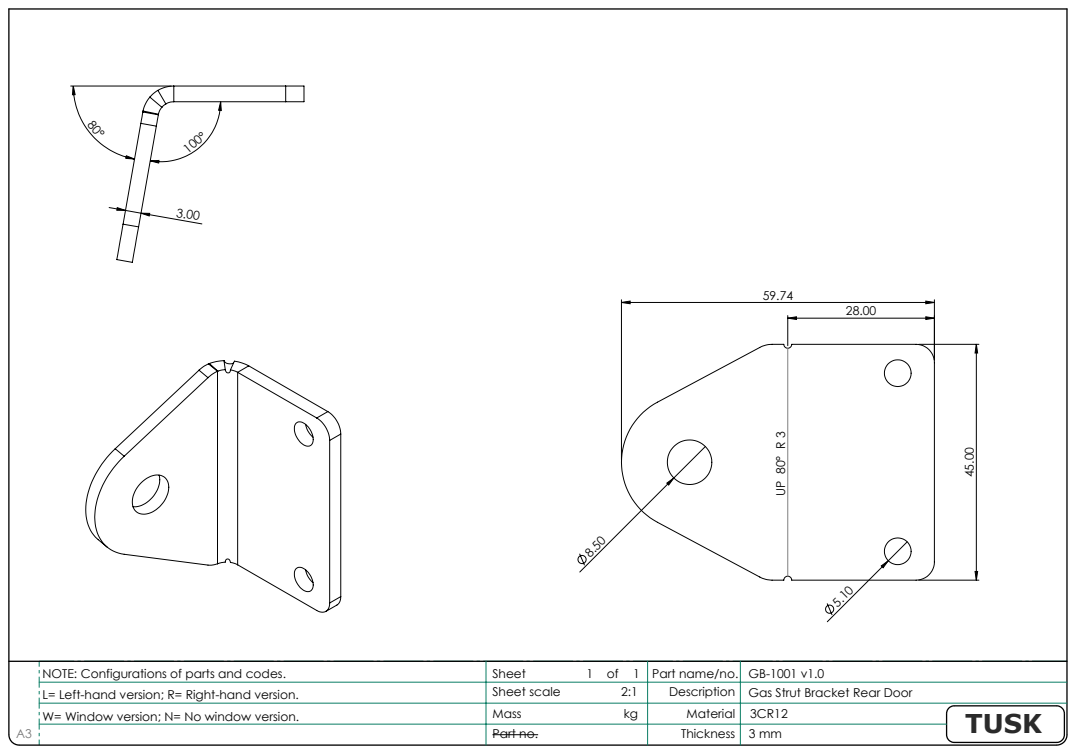
[picture p106: page 1]
Part no.

NOTE: Configurations of parts and codes. | Sheet 1 of 1 | Part name/no. | GB-1001 v1.0
L= Left-hand version; R= Right-hand version. | Sheet scale 2:1 | Description | Gas Strut Bracket Rear Door
W= Window version; N= No window version. | Mass | Material
