StormMans/veldarmour/kanopi_raw/Hilux GD6 Double Cab Data Pack (Side door with no windows)/2023/GSB-02 v1.0.pdf

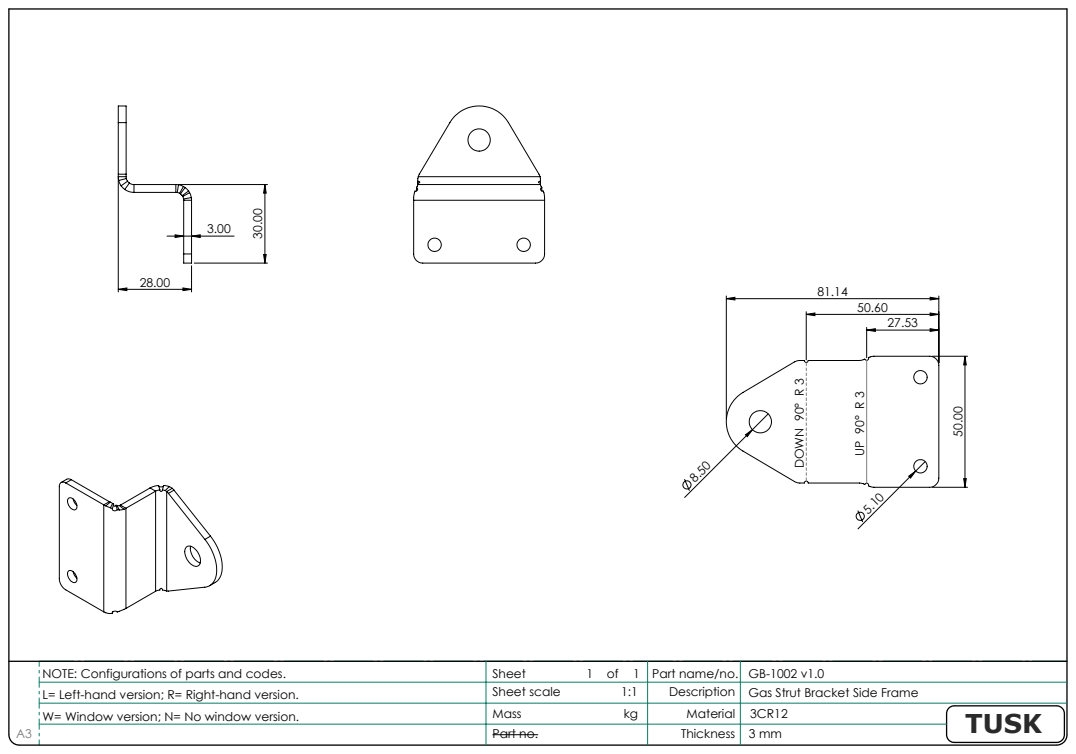
[picture p107: page 1]
DOWN 90° R 3; Part no.

NOTE: Configurations of parts and codes. | Sheet 1 of 1 | Part name/no. | GB-1002 v1.0
L= Left-hand version; R= Right-hand version. | Sheet scale 1:1 | Description | Gas Strut Bracket Side Frame
W= Window version; N= No window version. | Mass | Material
