StormMans/veldarmour/kanopi_raw/Hilux GD6 Double Cab Data Pack (Side door with no windows)/2023/GSB-03 v1.0.pdf

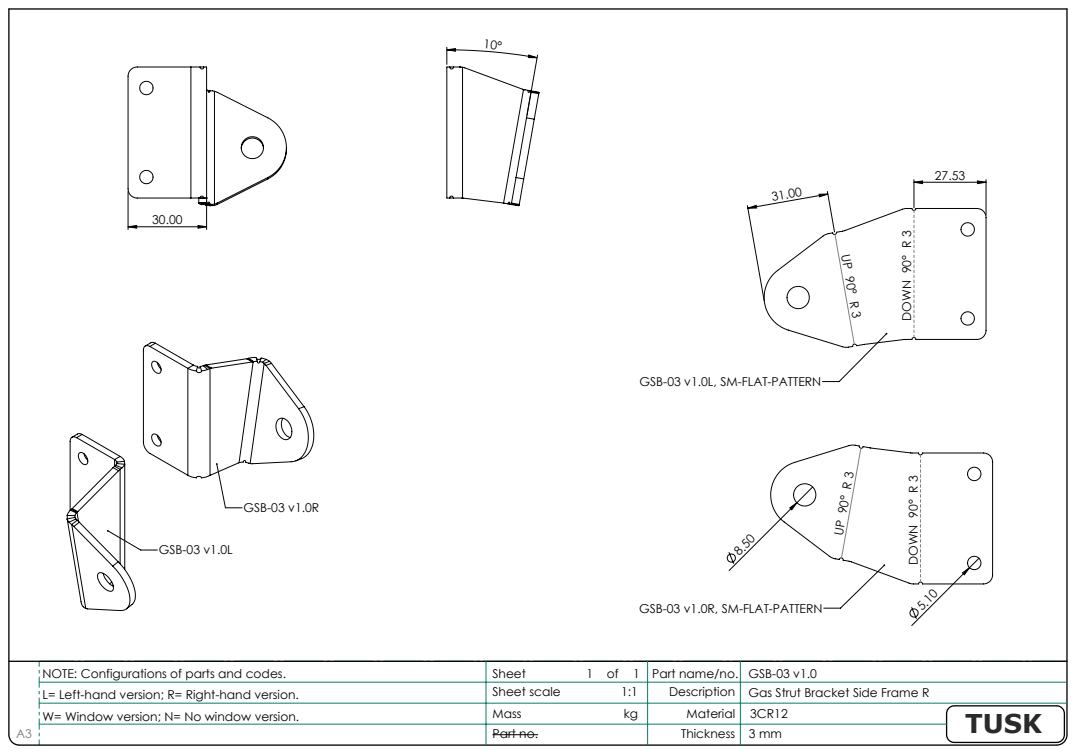
[picture p108: page 1]
GSB-03 v1.0R; 5.10 DOWN 90° R 3; GSB-03 v1.0L; DOWN 90° R 3; Part no.

GSB-03 v1.0L, SM-FLAT-PATTERN

GSB-03 v1.0R, SM-FLAT-PATTERN

NOTE: Configurations of parts and codes. | Sheet 1 of 1 | Part name/no. | GSB-03 v1.0
L= Left-hand version; R= Right-hand version. | Sheet scale 1:1 | Description | Gas Strut Bracket Side Frame R
W= Window version; N= No window version. | Mass | Material
