StormMans/veldarmour/kanopi_raw/Hilux GD6 Double Cab Data Pack (Side door with no windows)/2023/TOD6-02 v1.2.pdf

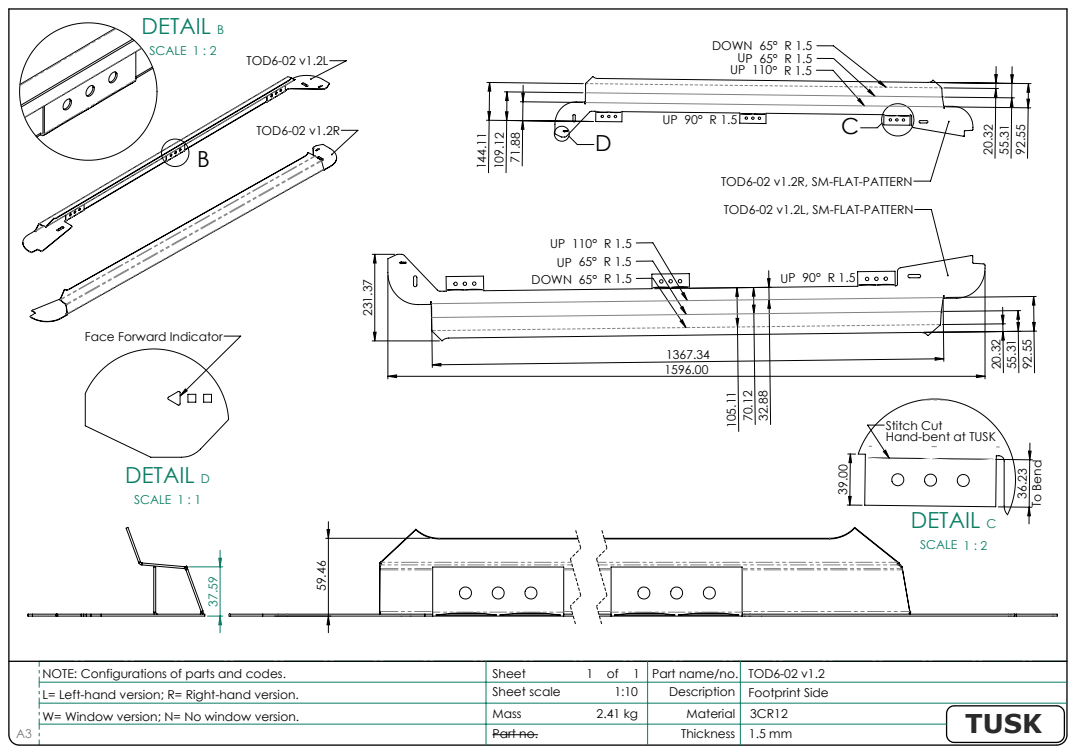
[picture p110: page 1]
TOD6-02 v1.2R; UP 65° R 1.5 DOWN 65° R 1.5; TOD6-02 v1.2L; DOWN 65° R 1.5 UP 65° R 1.5 UP 110° R 1.5; DETAIL B; SCALE 1 : 2; To Bend; DETAIL C; DETAIL D; SCALE 1 : 1; Part no.

TOD6-02 v1.2R, SM-FLAT-PATTERN
TOD6-02 v1.2L, SM-FLAT-PATTERN

Face Forward Indicator

Stitch Cut
Hand-bent at TUSK

NOTE: Configurations of parts and codes. | Sheet 1 of 1 | Part name/no. | TOD6-02 v1.2
L= Left-hand version; R= Right-hand version. | Sheet scale 1:10 | Description | Footprint Side
W= Window version; N= No window version. | Mass | Material
