StormMans/veldarmour/kanopi_raw/Hilux GD6 Double Cab Data Pack (Side door with no windows)/2023/TOD6-03 v1.2.pdf

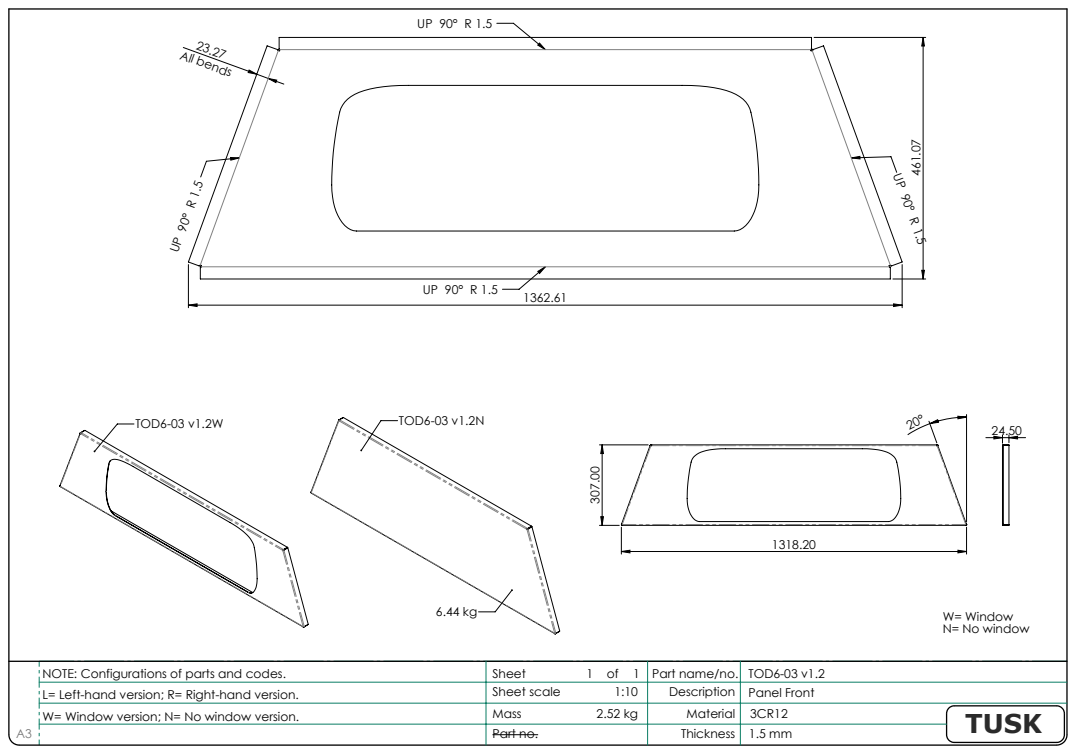
[picture p111: page 1]
TOD6-03 v1.2W; TOD6-03 v1.2N; All bends; W= Window N= No window; Part no.

NOTE: Configurations of parts and codes. | Sheet 1 of 1 | Part name/no. | TOD6-03 v1.2
L= Left-hand version; R= Right-hand version. | Sheet scale 1:10 | Description | Panel Front
W= Window version; N= No window version. | Mass | Material
