StormMans/veldarmour/kanopi_raw/Hilux GD6 Double Cab Data Pack (Side door with no windows)/2023/TOD6-04 v1.2.pdf

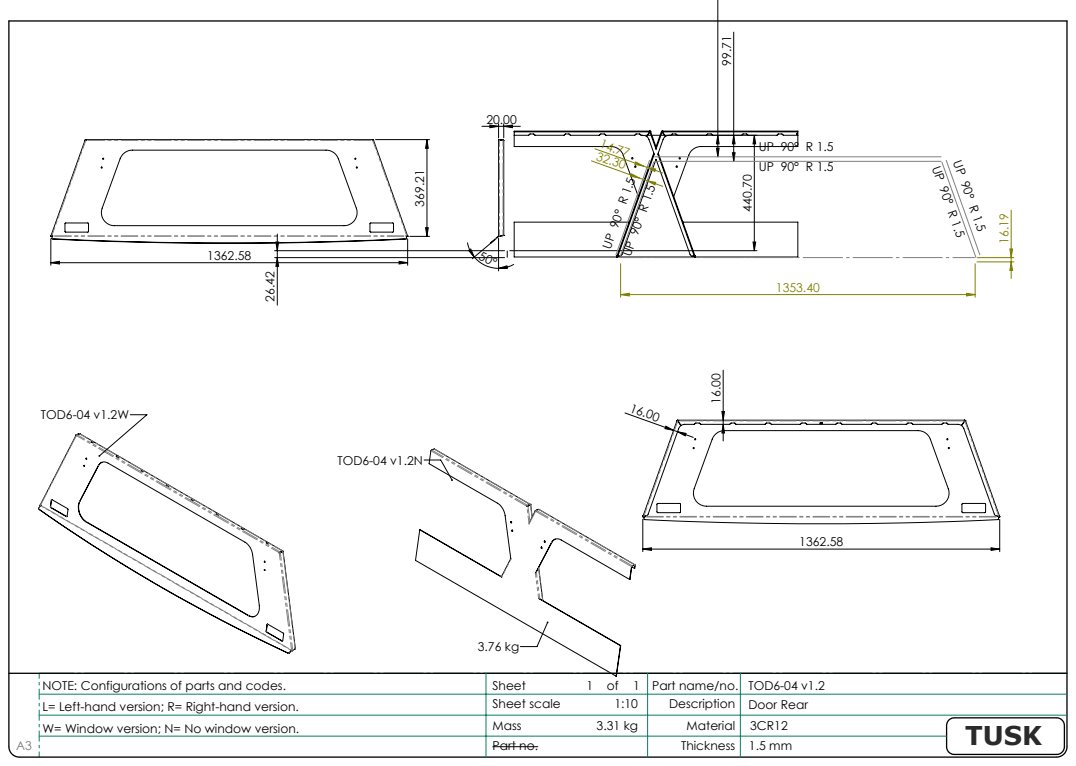
[picture p112: page 1]
TOD6-04 v1.2W; TOD6-04 v1.2N; Part no.

NOTE: Configurations of parts and codes. | Sheet 1 of 1 | Part name/no. | TOD6-04 v1.2
L= Left-hand version; R= Right-hand version. | Sheet scale 1:10 | Description | Door Rear
W= Window version; N= No window version. | Mass | Material
