StormMans/veldarmour/kanopi_raw/Hilux GD6 Double Cab Data Pack (Side door with no windows)/2023/TOD6-05 v1.2.pdf

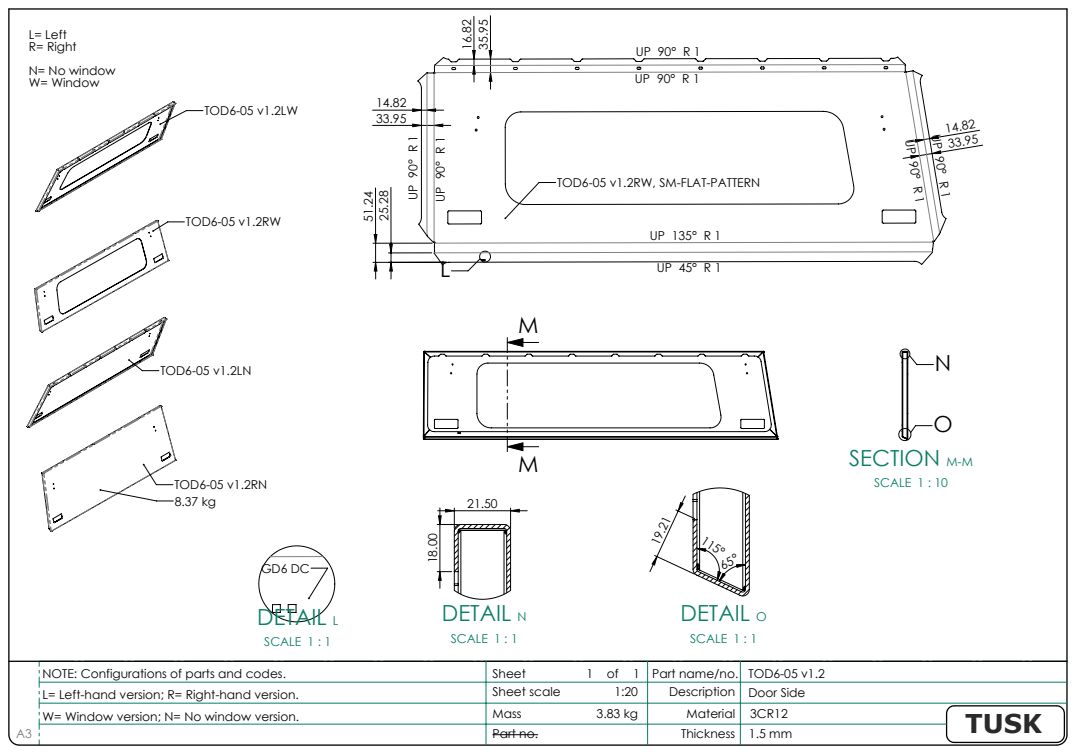
[picture p113: page 1]
TOD6-05 v1.2RW; TOD6-05 v1.2LW; TOD6-05 v1.2RN 8.37 kg; TOD6-05 v1.2LN; DETAIL L; SCALE 1 : 1; SECTION M-M; SCALE 1 : 10; DETAIL N; DETAIL O; L= Left R= Right N= No window W= Window; Part no.

TOD6-05 v1.2RW, SM-FLAT-PATTERN

NOTE: Configurations of parts and codes. | Sheet 1 of 1 | Part name/no. | TOD6-05 v1.2
L= Left-hand version; R= Right-hand version. | Sheet scale 1:20 | Description | Door Side
W= Window version; N= No window version. | Mass | Material
