StormMans/veldarmour/kanopi_raw/Hilux GD6 Double Cab Data Pack (Side door with no windows)/2023/TOD6-10 v1.2.pdf

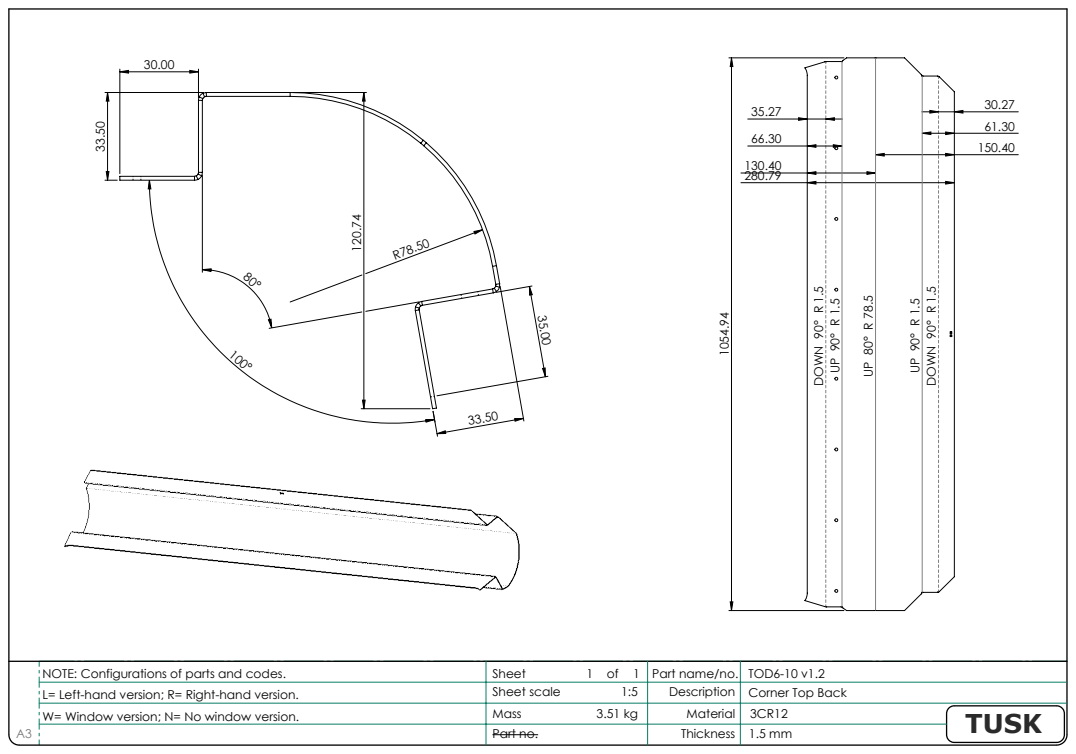
[picture p115: page 1]
DOWN 90° R 1.5 UP 90° R 1.5; DOWN 90° R 1.5; Part no.

NOTE: Configurations of parts and codes. | Sheet 1 of 1 | Part name/no. | TOD6-10 v1.2
L= Left-hand version; R= Right-hand version. | Sheet scale 1:5 | Description | Corner Top Back
W= Window version; N= No window version. | Mass | Material
