StormMans/veldarmour/kanopi_raw/Hilux GD6 Double Cab Data Pack (Side door with no windows)/2023/TOD6-12 v1.2.pdf

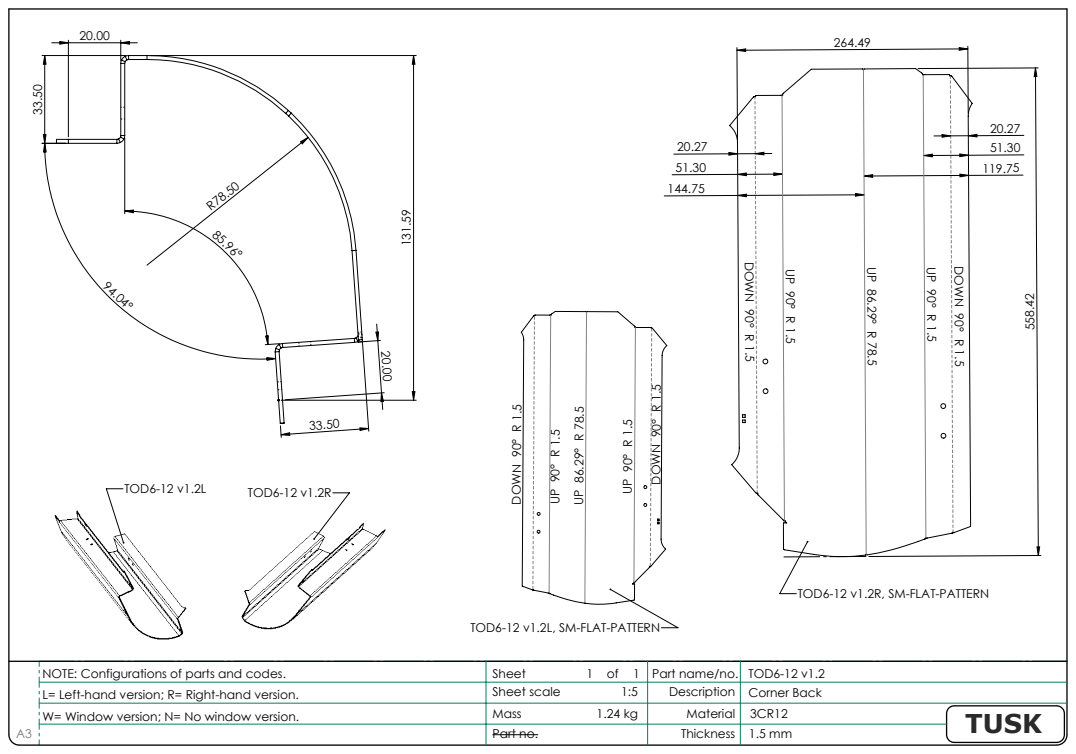
[picture p117: page 1]
TOD6-12 v1.2R TOD6-12 v1.2L; DOWN 90° R 1.5; Part no.

TOD6-12 v1.2R, SM-FLAT-PATTERN

TOD6-12 v1.2L, SM-FLAT-PATTERN

NOTE: Configurations of parts and codes. | Sheet 1 of 1 | Part name/no. | TOD6-12 v1.2
L= Left-hand version; R= Right-hand version. | Sheet scale 1:5 | Description | Corner Back
W= Window version; N= No window version. | Mass | Material
