StormMans/veldarmour/kanopi_raw/Hilux GD6 Double Cab Data Pack (Side door with no windows)/2023/TOD6-ASM v1.2.pdf

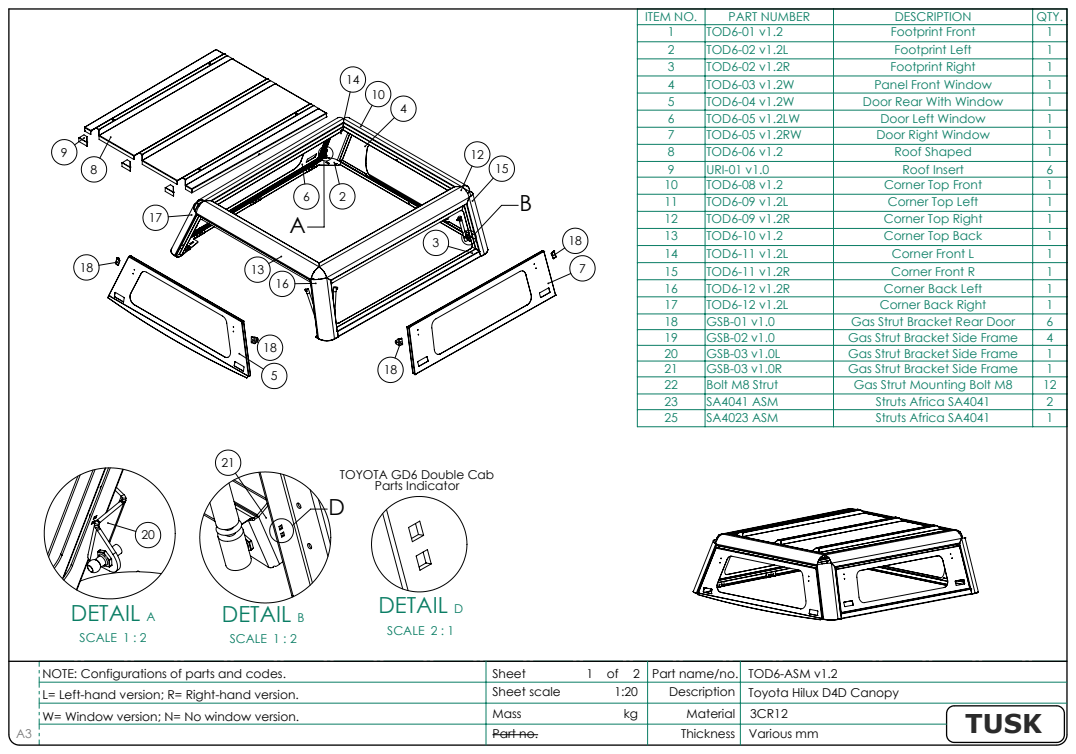
[picture p118: page 1]
DETAIL A; SCALE 1 : 2; DETAIL B; DETAIL D; SCALE 2 : 1; Part no.; Various mm

ITEM NO. | PART NUMBER | DESCRIPTION | QTY.
1 | TOD6-01 v1.2 | Footprint Front | 1
2 | TOD6-02 v1.2L | Footprint Left | 1
3 | TOD6-02 v1.2R | Footprint Right | 1
4 | TOD6-03 v1.2W | Panel Front Window | 1
5 | TOD6-04 v1.2W | Door Rear With Window | 1
6 | TOD6-05 v1.2LW | Door Left Window | 1
7 | TOD6-05 v1.2RW | Door Right Window | 1
8 | TOD6-06 v1.2 | Roof Shaped | 1
9 | URI-01 v1.0 | Roof Insert | 6
10 | TOD6-08 v1.2 | Corner Top Front | 1
11 | TOD6-09 v1.2L | Corner Top Left | 1
12 | TOD6-09 v1.2R | Corner Top Right | 1
13 | TOD6-10 v1.2 | Corner Top Back | 1
14 | TOD6-11 v1.2L | Corner Front L | 1
15 | TOD6-11 v1.2R | Corner Front R | 1
16 | TOD6-12 v1.2R | Corner Back Left | 1
17 | TOD6-12 v1.2L | Corner Back Right | 1
18 | GSB-01 v1.0 | Gas Strut Bracket Rear Door | 6
19 | GSB-02 v1.0 | Gas Strut Bracket Side Frame | 4
20 | GSB-03 v1.0L | Gas Strut Bracket Side Frame | 1
21 | GSB-03 v1.0R | Gas Strut Bracket Side Frame | 1
22 | Bolt M8 Strut | Gas Strut Mounting Bolt M8 | 12
23 | SA4041 ASM | Struts Africa SA4041 | 2
25 | SA4023 ASM | Struts Africa SA4041 | 1

TOYOTA GD6 Double Cab
Parts Indicator

NOTE: Configurations of parts and codes. | Sheet 1 of 2 | Part name/no. | TOD6-ASM v1.2
L= Left-hand version; R= Right-hand version. | Sheet scale 1:20 | Description | Toyota Hilux D4D Canopy
W= Window version; N= No window version. | Mass | Material

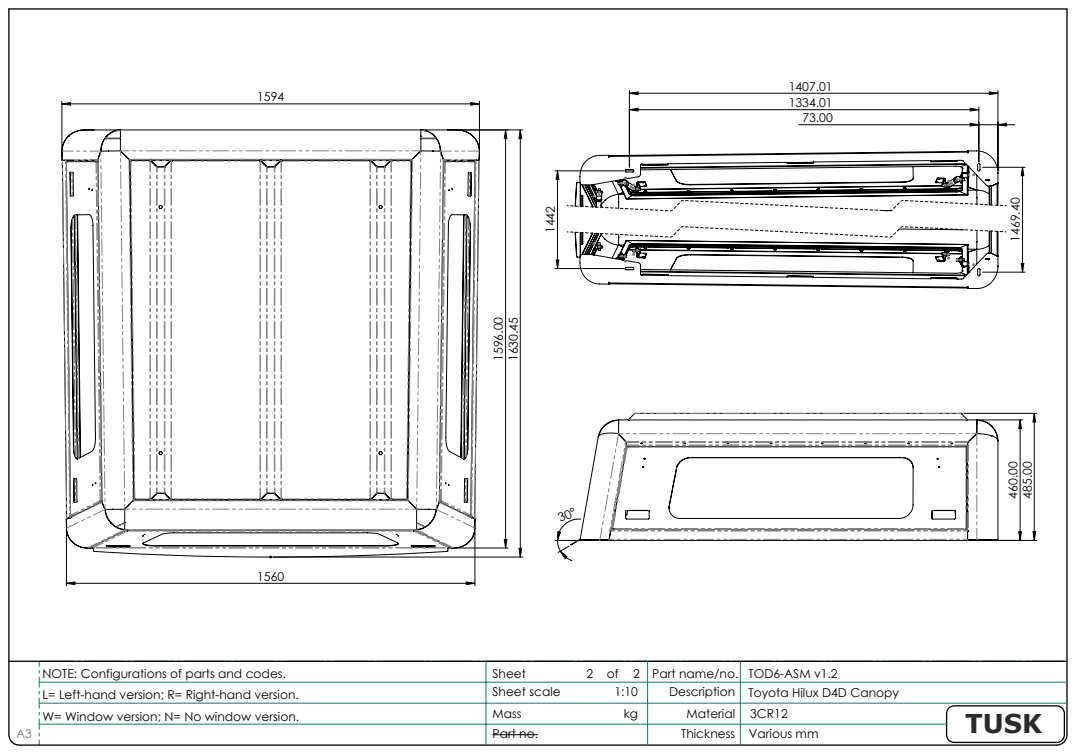
[picture p119: page 2]
Part no.; Various mm

NOTE: Configurations of parts and codes. | Sheet 2 of 2 | Part name/no. | TOD6-ASM v1.2
L= Left-hand version; R= Right-hand version. | Sheet scale 1:10 | Description | Toyota Hilux D4D Canopy
W= Window version; N= No window version. | Mass | Material
