StormMans/veldarmour/kanopi_raw/Hilux GD6 Double Cab Data Pack (Side door with no windows)/2023/URI-01 v1.0.pdf

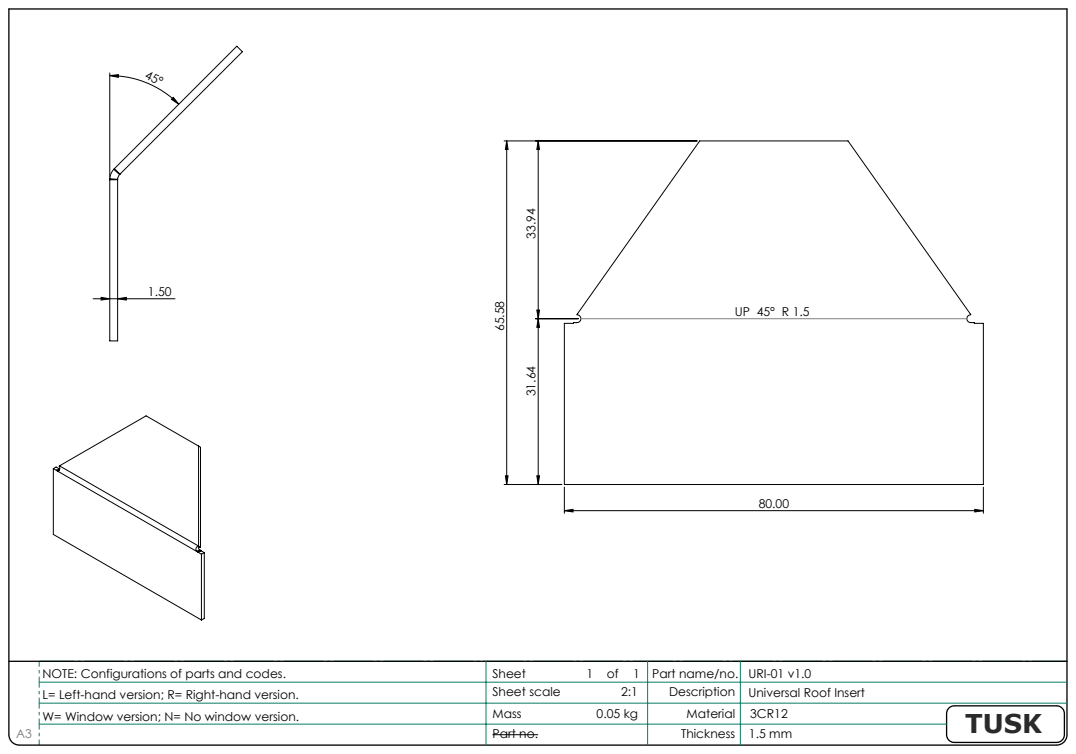
[picture p120: page 1]
Part no.

NOTE: Configurations of parts and codes. | Sheet 1 of 1 | Part name/no. | URI-01 v1.0
L= Left-hand version; R= Right-hand version. | Sheet scale 2:1 | Description | Universal Roof Insert
W= Window version; N= No window version. | Mass | Material
