StormMans/veldarmour/kanopi_raw/Hilux GD6 Double Cab Data Pack (Side door with no windows)/40095.pdf

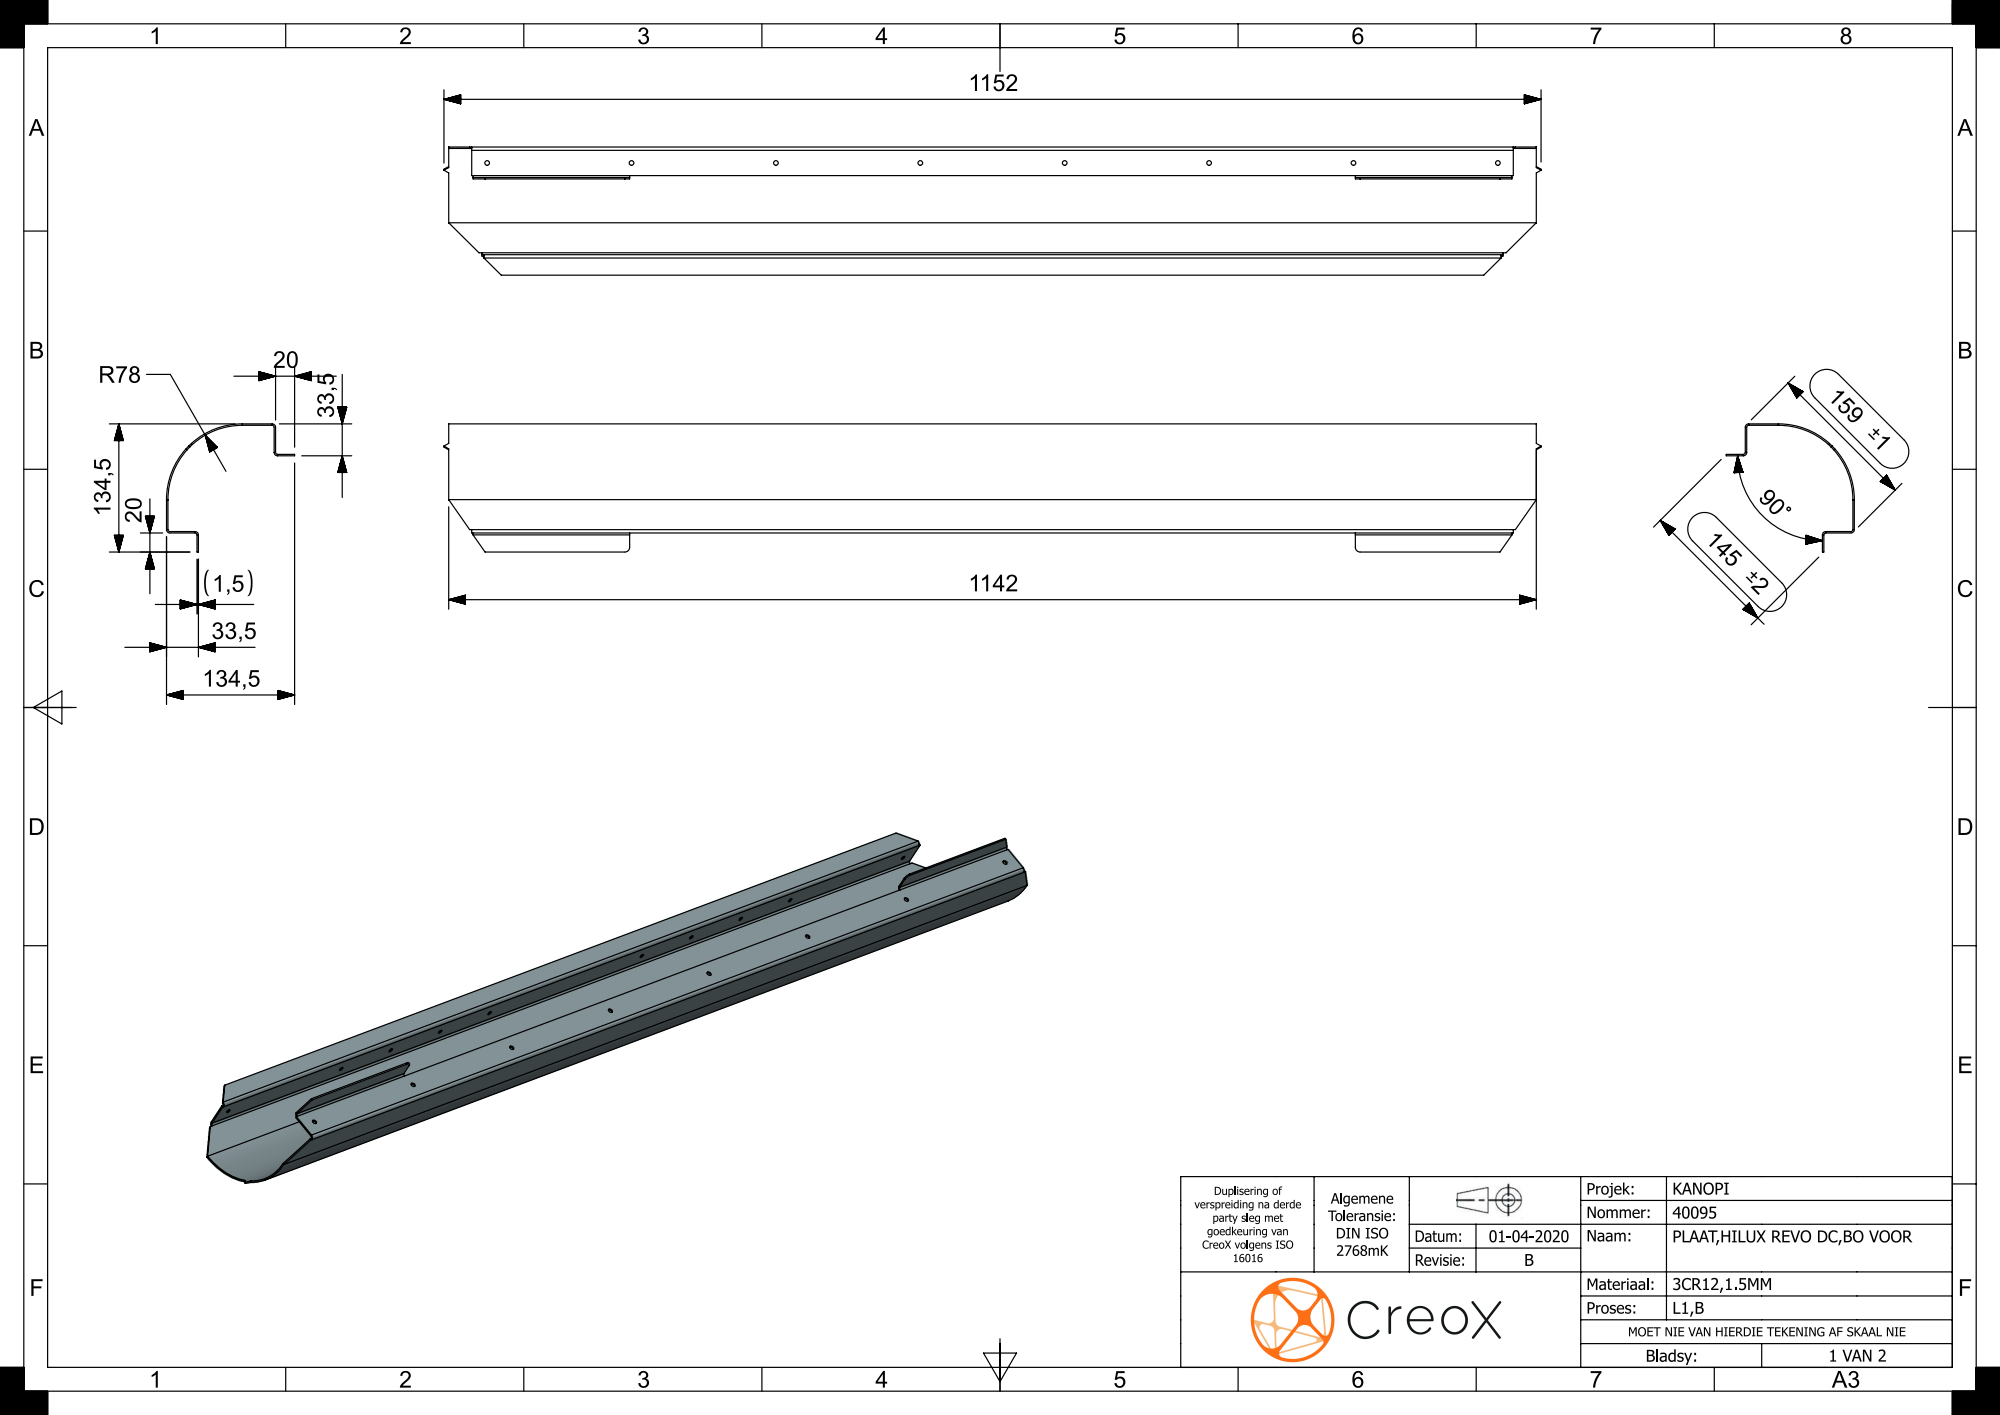
[picture p128: page 1]

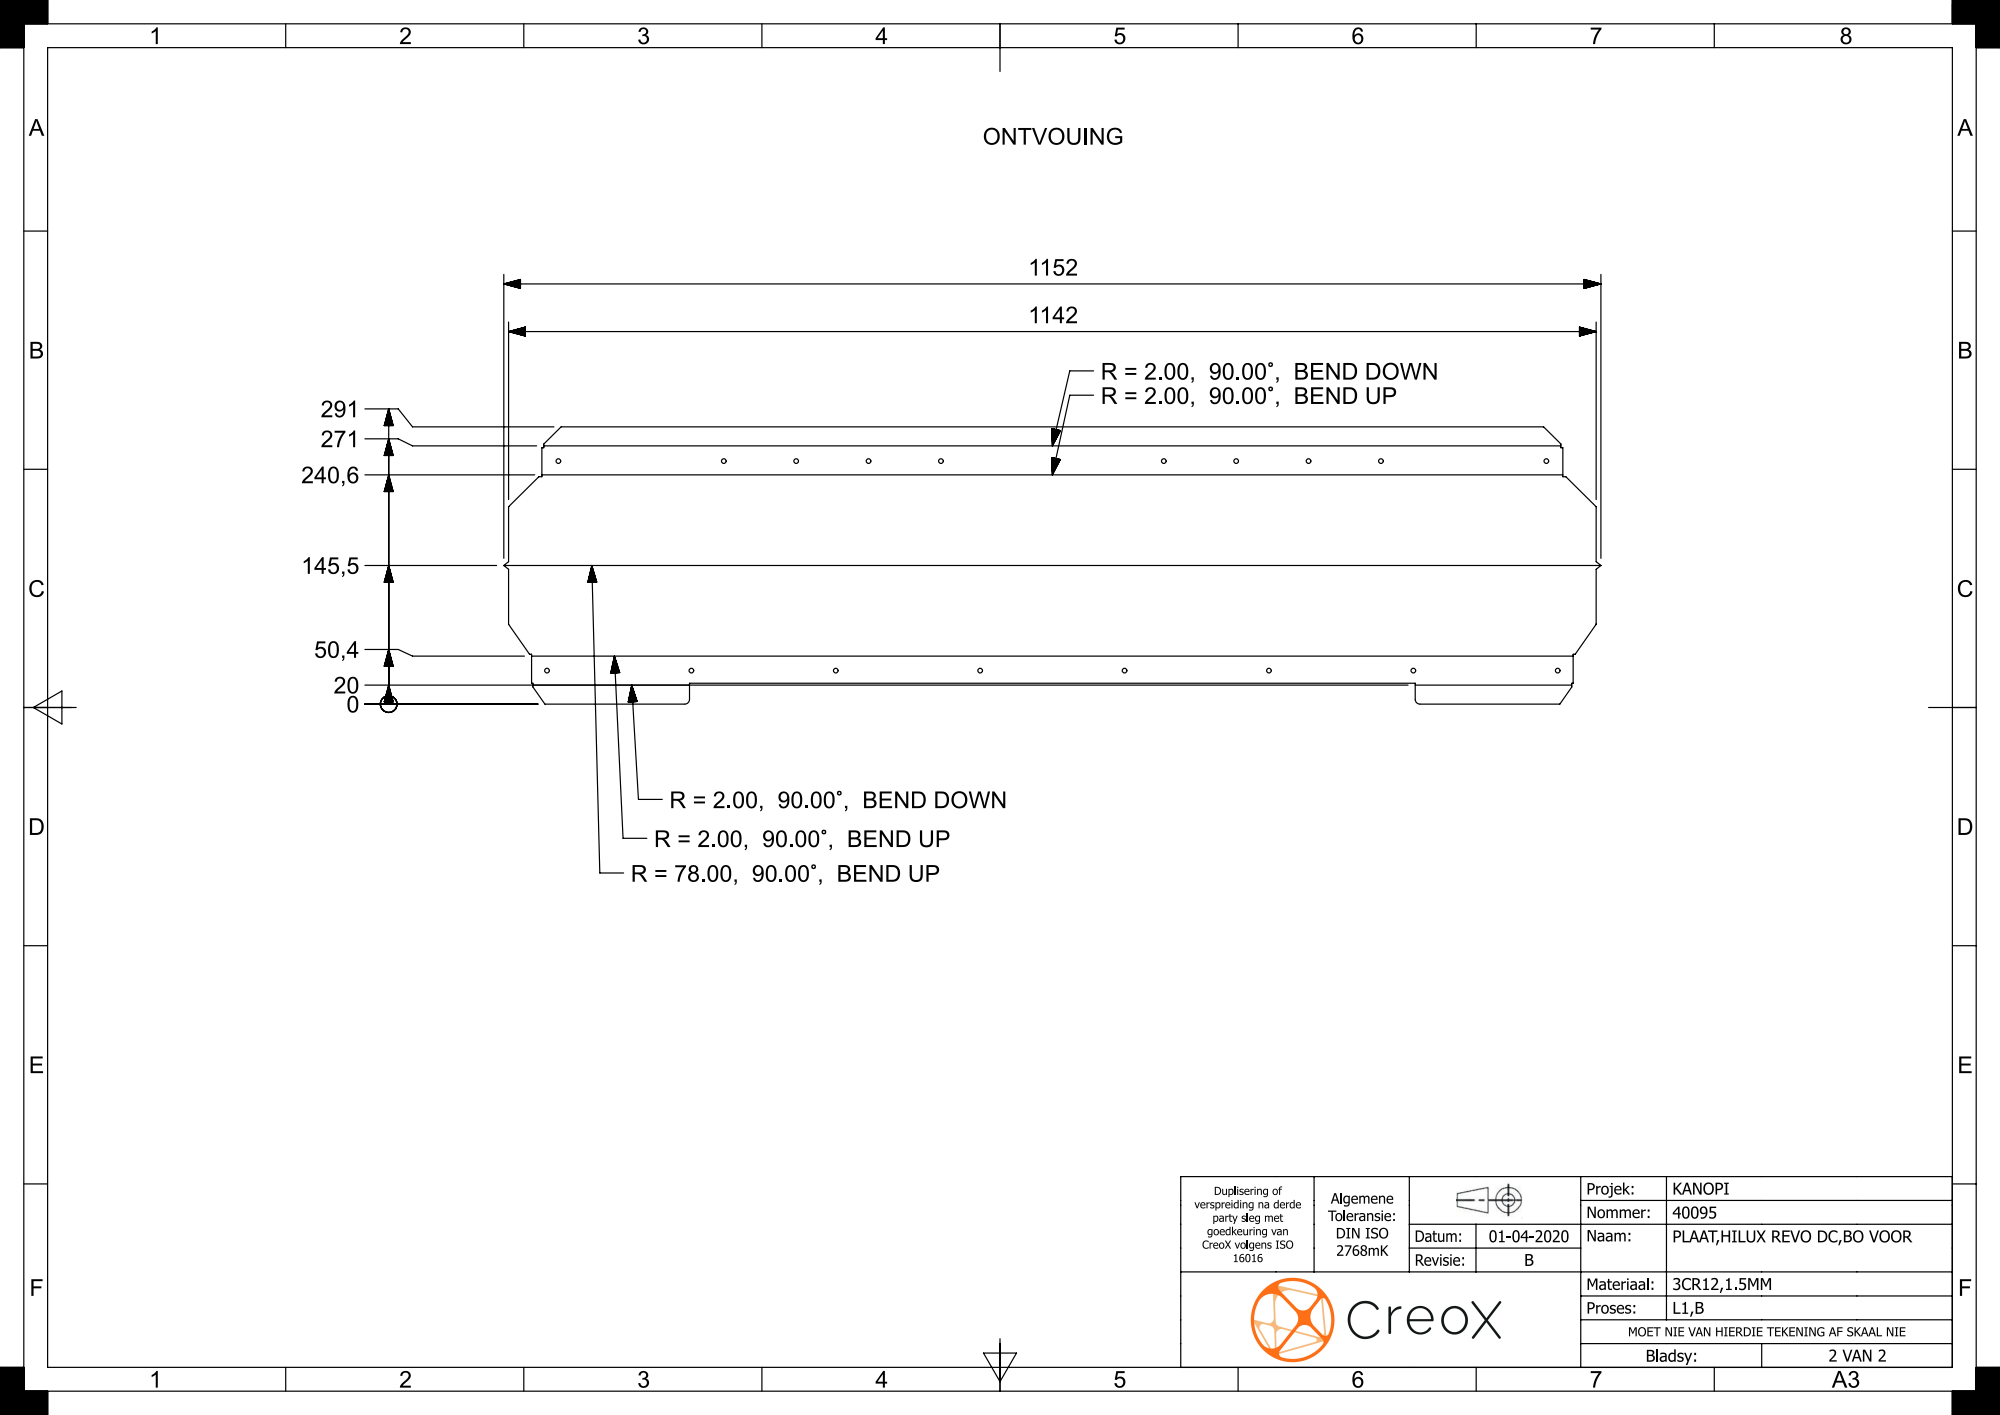
[picture p129: page 2]
