StormMans/veldarmour/kanopi_raw/Hilux GD6 Double Cab Data Pack (Side door with no windows)/40104-Rev 3.pdf

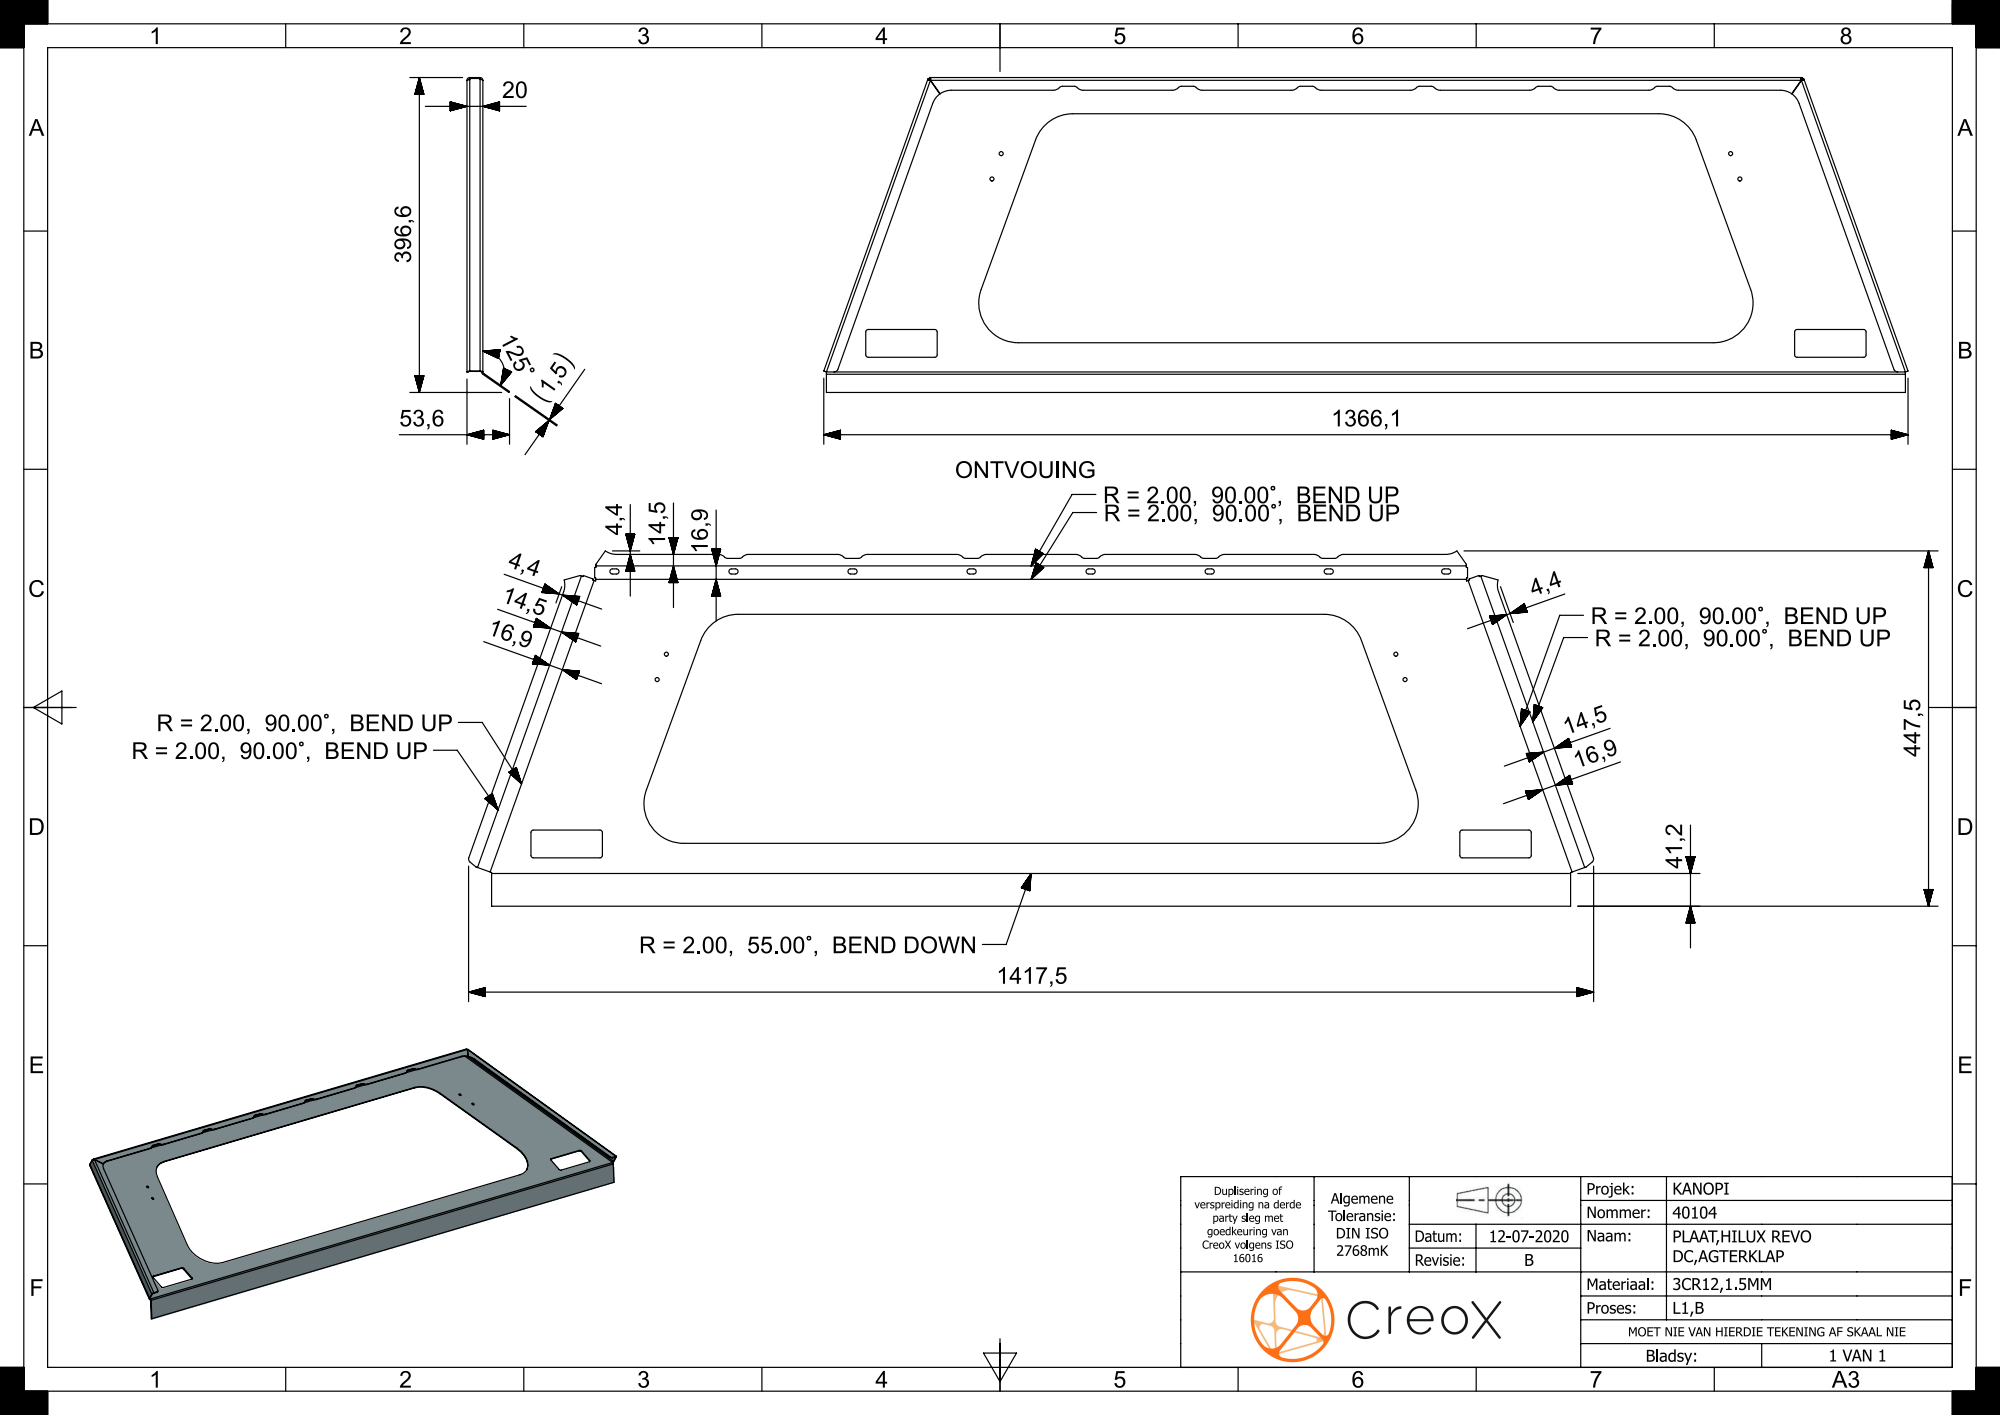
[picture p137: page 1]
