StormMans/veldarmour/kanopi_raw/Hilux GD6 Double Cab Data Pack (Side door with no windows)/40174.pdf

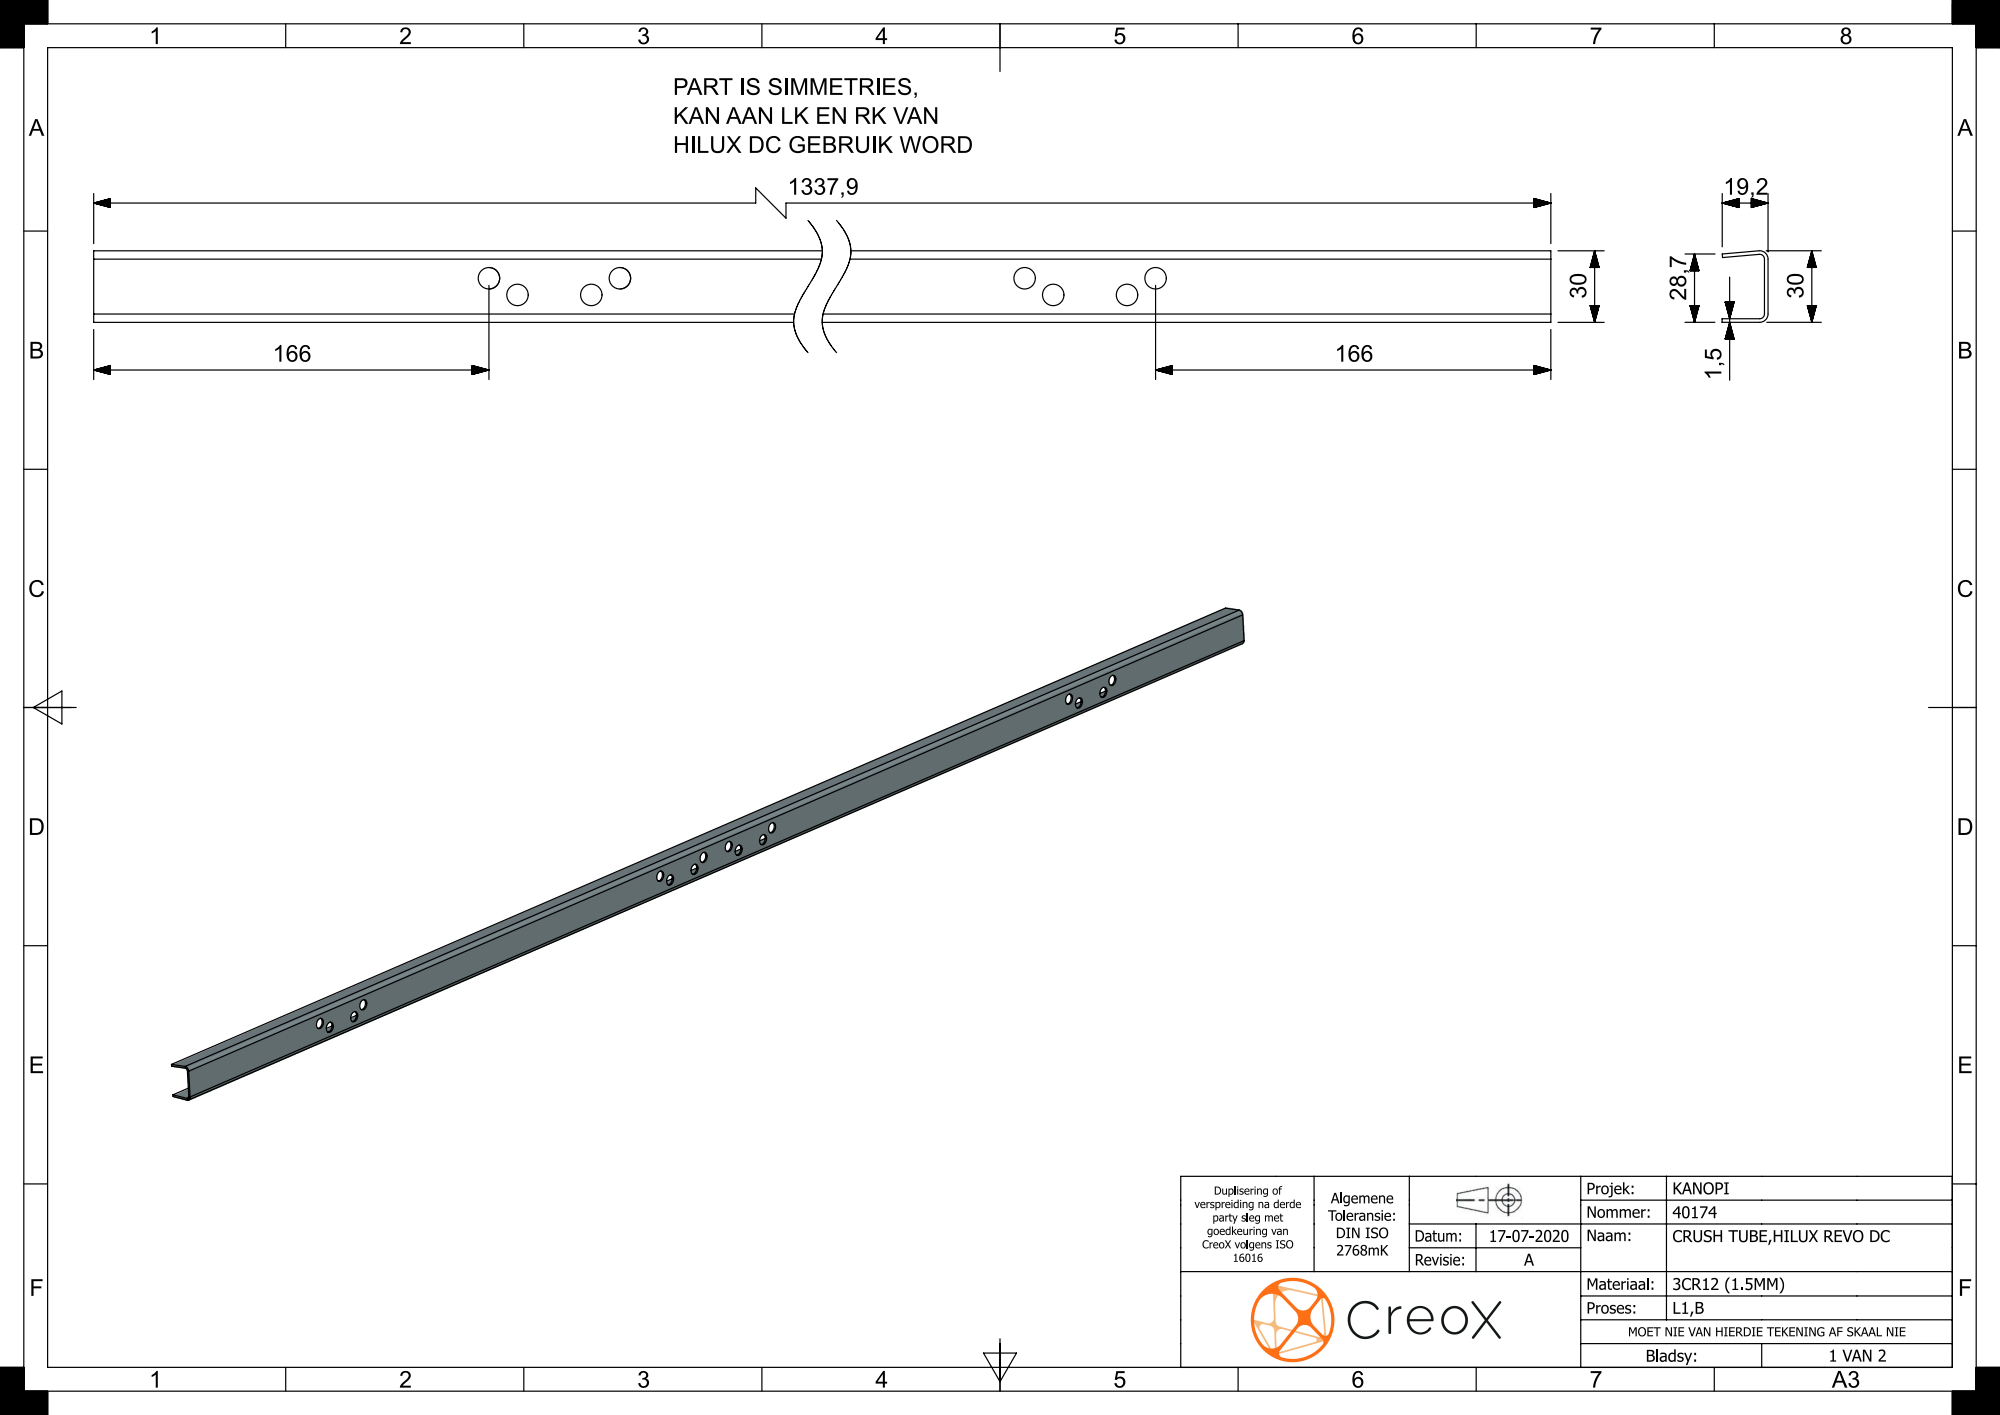
[picture p157: page 1]

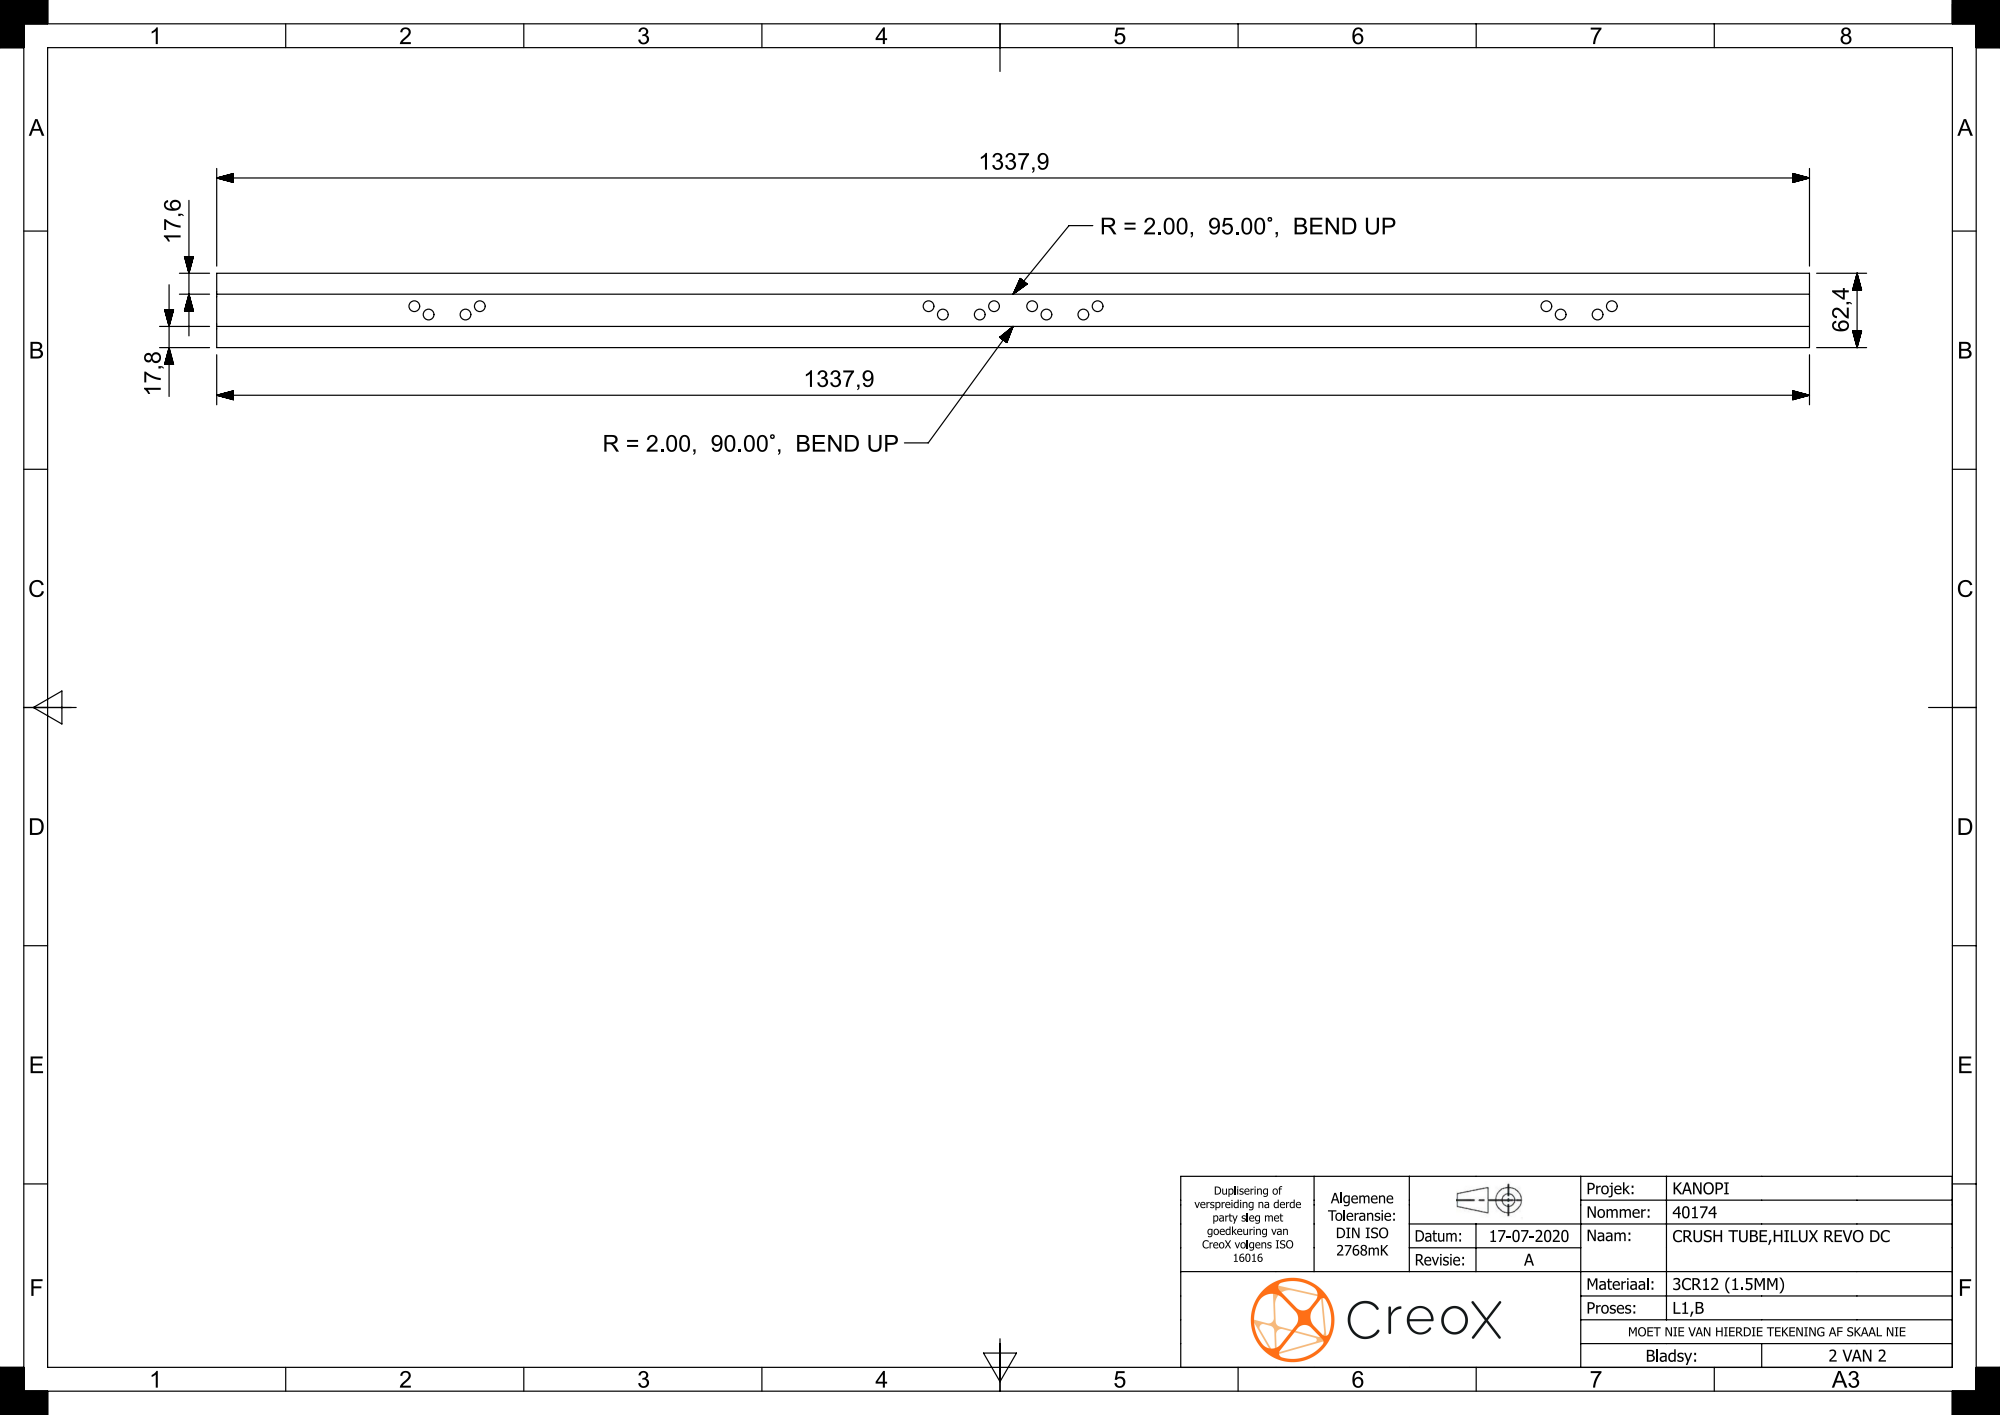
[picture p158: page 2]
