StormMans/veldarmour/kanopi_raw/Hilux GD6 Double Cab Data Pack (Side door with no windows)/2023/TOD6-06 v1.2.pdf

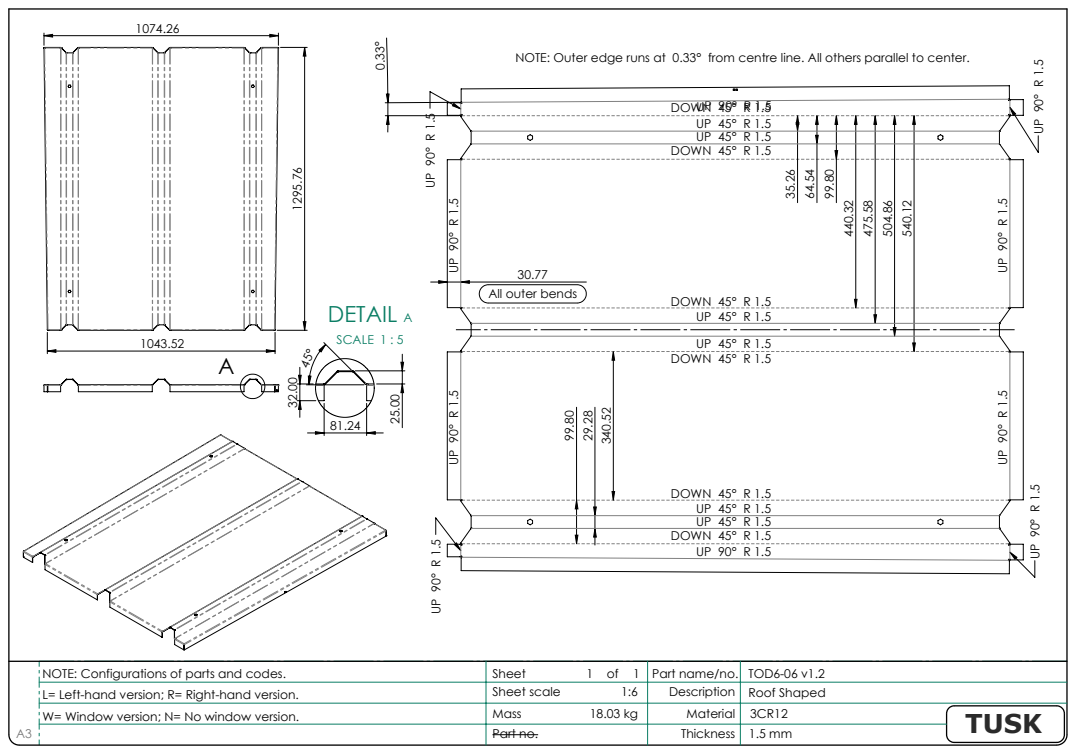
[picture p159: page 1]
DOWN 45° R 1.5; DETAIL A; SCALE 1 : 5; Part no.

NOTE: Outer edge runs at 0.33° from centre line. All others parallel to center.

UP 45° R 1.5 UP 45° R 1.5 DOWN 45° R 1.5

30.77 | DOWN 45° R 1.5

All outer bends

UP 45° R 1.5
DOWN 45° R 1.5

NOTE: Configurations of parts and codes. | Sheet 1 of 1 | Part name/no. | TOD6-06 v1.2
L= Left-hand version; R= Right-hand version. | Sheet scale 1:6 | Description | Roof Shaped
W= Window version; N= No window version. | Mass | Material
