StormMans/veldarmour/kanopi_raw/Hilux GD6 Double Cab Data Pack (Side door with no windows)/2023/TOD6-09 v1.2.pdf

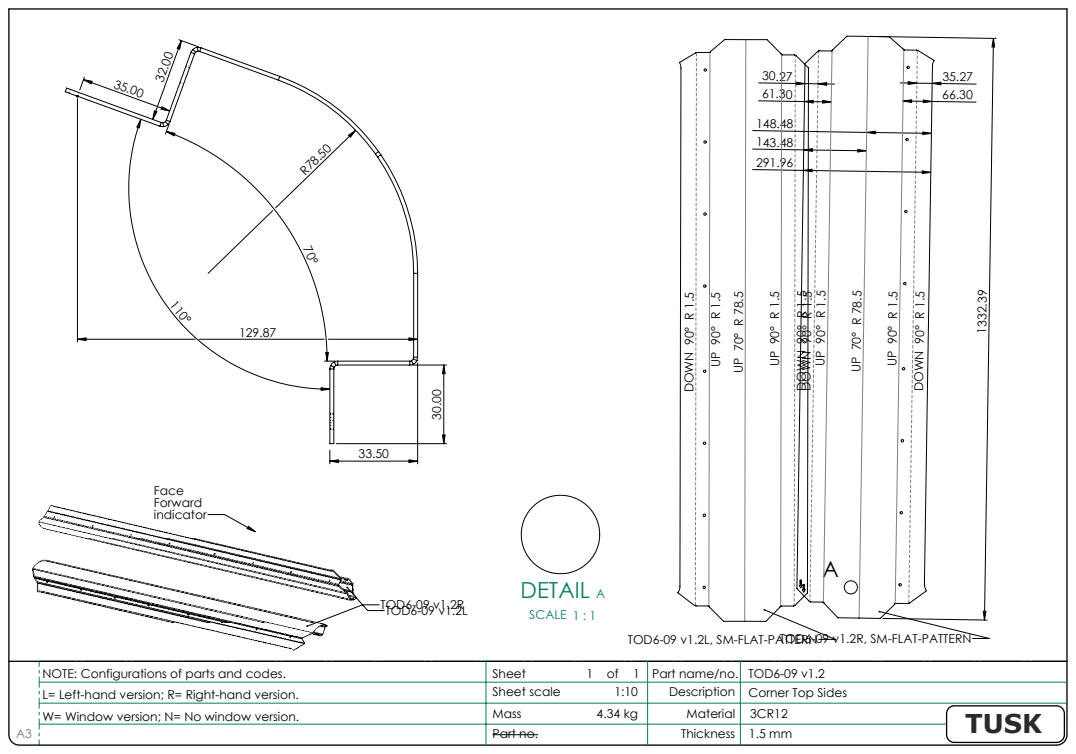
[picture p160: page 1]
DOWN 90° R 1.5; TOD6-09 v1.2R TOD6-09 v1.2L; DETAIL A; SCALE 1 : 1; Part no.

TOD6-09 v1.2L, SM-FLAT-PATTERN

TOD6-09 v1.2R, SM-FLAT-PATTERN

NOTE: Configurations of parts and codes. | Sheet 1 of 1 | Part name/no. | TOD6-09 v1.2
L= Left-hand version; R= Right-hand version. | Sheet scale 1:10 | Description | Corner Top Sides
W= Window version; N= No window version. | Mass | Material
