StormMans/veldarmour/(commit log)

2026-06-11 Add 3x CNC laser-cut logo DXF designs for 1.5mm 304 brushed stainless steel
    D1: Classic VA Shield (120×145mm portrait)
    D2: Horizontal name-plate (200×60mm)
    D3: Circular badge (Ø160mm)
    All designs include: VA monogram, VELD ARMOUR dot-matrix text, mounting holes Ø5mm,
    and inner border details. CUT layer = laser cut path. Sizes optimised for
    1.5mm 304 BSS — min feature ≥2mm throughout.
    https://claude.ai/code/session_01C67mLjppzHoY9bcv2wBXMc
    [VA_Logo_D1_Shield.dxf, VA_Logo_D2_Nameplate.dxf, VA_Logo_D3_CircleBadge.dxf]
2026-06-11 Add cleaned Hilux GD6 DC data pack — Veld Armour branded
    Removed all Kanopi references from the BOM spreadsheet (5 instances).
    All DXF geometry files untouched — pure cut paths, no branding inside them.
    Temp lock file removed. Spreadsheet renamed to Veld Armour.
    Changes in BOM Hilux GD6 DC - Veld Armour.xlsx:
    - Sheet title: Kanopi → Veld Armour (×2 section headers)
    - Part 40059: Naamplaat,Kanopi,1 → Naamplaat,Veld Armour,1
    - Part 40078: Plaat Kanopi Dak Profiel → Plaat Veld Armour Dak Profiel
    - Part 40112: Naamplaat,Kanopi,2 → Naamplaat,Veld Armour,2
    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
    [40059_1.dxf, 40069_1.dxf, 40070_1.dxf, 40071_1.dxf, 40072_1.dxf, 40078_1.dxf, 40092_1.dxf, 40095_1.dxf]
2026-06-11 Add kanopi_raw source files (original upload, pre-cleaning)
    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
    [40059_1.dxf, 40069_1.dxf, 40070_1.dxf, 40071_1.dxf, 40072_1.dxf, 40078_1.dxf, 40092_1.dxf, 40095_1.dxf]
2026-10-19 Add VA-BB bull bar CNC & press-brake data pack (Rev A)
    Re-issue of the sourced 4x4 bull bar design under Veld Armour part numbers:
    13 cleaned 1:1 flat-pattern DXFs (CUT / BEND_UP / BEND_DOWN / ETCH / INFO layers),
    mirrored LH upright and face strip generated, 8mm recovery lug redrawn from the
    assembly drawing, VA monogram cut-through and etched wordmark on the centre panel.
    A3 bend sheet per part with bend table (BA/BD/V-die), formed section and reference
    view, plus an assembly / BOM / nest-list sheet. Source files and build scripts included.
    Claude-Session: https://claude.ai/code/session_01TX2AF7Bytd9egH1iC2fdsu
2026-10-19 Bull bar data pack: switch material to 304 stainless steel
    304 (1.4301) 2B, density 7.93, K-factor 0.46, V-die 8T, nitrogen cut,
    ER308L weld and passivate notes; red warning on sheets where source inside
    radius is below 1T. Masses and bend tables regenerated.
    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
2026-10-19 Bull bar data pack: tube schedule from assembly views; face-strip bends confirmed
    Add VA-BB-TUBE sheet: cut lengths, CHS sections and bend data for the five
    tube items measured from the 1:20 assembly front/side views (side hoops CHS 50,
    one 90 deg bend CLR 80, legs 180/204, bend plane 25 deg rearward; centre hoop
    63.5 x 702; spot bar 38.1 x 805; lift stubs 38.1 x 3 x 100). BOM now carries
    tube lengths and masses. Face strips 17/18: bend lines confirmed, source
    'NO BENDING' caveat removed.
    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
2026-10-19 Bull bar data pack: 2.0 mm wall on all tubes
    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
2026-10-19 Bull bar data pack: virtual build and manufacturability simulation report
    3D fold of every flat with its bend table (self-clash, formed sections vs
    drawing within 1 mm), assembly stack-up, press-brake tonnage and min-flange
    checks for 304, structural hand checks (lug, side hoop, centre beam, bracket
    fasteners) and sheet nesting. Findings summarised in README.
    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
2026-10-19 Bull bar data pack: lugs upgraded to 12 mm; bracket slot note corrected
    Lug VA-BB-07 now 12 mm 304 (0.44 kg ea), DXF renamed, nest group added.
    Simulation: lug check recomputed at 12 mm; bracket slots are 13 x 20 /
    15 x 38 from the DXF (M12 clearance as drawn) - earlier M8 note was wrong.
    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
2026-10-19 Bull bar data pack: lug boss R35 (20 mm ligament)
    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
